Logiant/AgileRoboticControls/Documentation/Microprocessor Proposal/Tiva Series.jpg

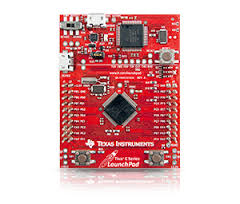
Documentation/Microprocessor Proposal/Tiva Series.jpg
