Logiant/AgileRoboticControls/Documentation/Design Show Poster/basic pneumatic circuit.png

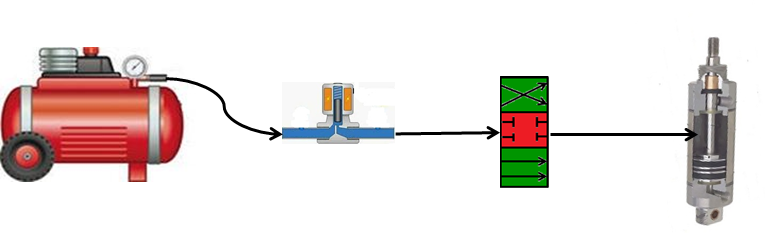
Documentation/Design Show Poster/basic pneumatic circuit.png
