Logiant/AgileRoboticControls/README.md

AgileRoboticControls
====================

Capstone Research Project
