Logiant/AgileRoboticControls/Poster/Poster Images.docx

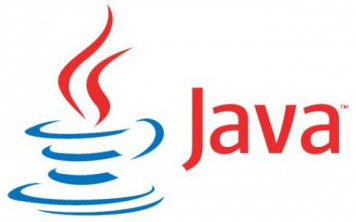
[picture p3: figure]

XBee

XBee

Arduino Mega 2560
