Logiant/AgileRoboticControls/Documentation/Presentation/Design Powerpoint.pptx

## Team Agile Robotic Control

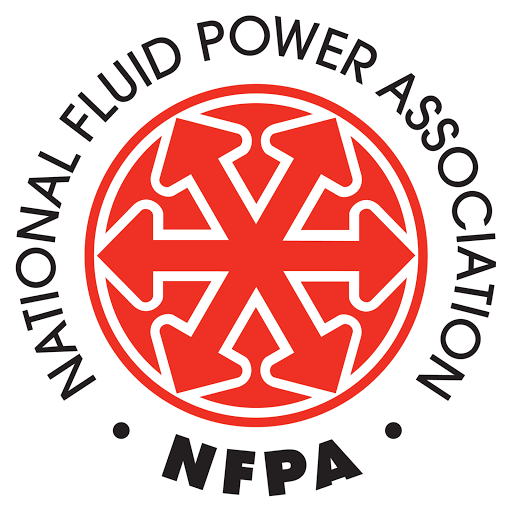
[picture p79: figure]
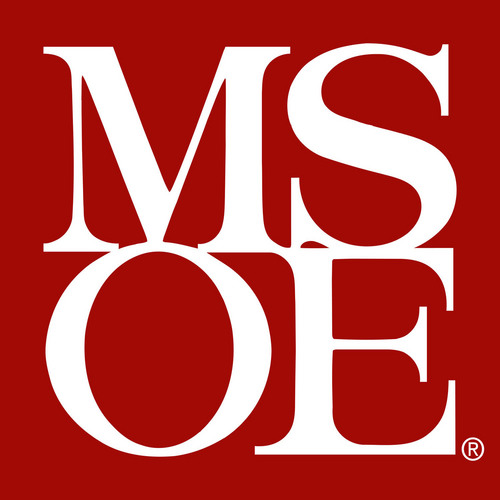
[picture p80: figure]

Logan Beaver - ME
Justin Campbell - ME
Tyler Paddock – CE/EE
Ronald Shipman – ME
Dr. Luis Rodriguez – advisor

## Project Overview

- Develop initial robotics platform
- Public Outreach
  - Increase interest in STEM fields
  - Engineering deficit
  - Fluid Power
- Educational robotics platform
  - Fluid Power
  - Control Systems
  - Robotics

## Major Design Decisions

- Quadruped Locomotion
  - Agile motion
  - Stable
  - Rugged Terrain
  - Two Links per Leg
- Pneumatic Power
  - High energy density
  - Clean and lightweight

## Major Constraints and Objectives

- Does not weight over 35 Kg
- Operational speed up to 0.5 m/s
- Gait implementations for creep and walk
- Emergency stops easily accessible
- Battery life of at least 3 hours for pneumatic components
- Onboard batteries and control system
- Tethered air supply

## Power Source Options

| Advantages | Disadvantages
Hydraulic Power Source | -Highest achievable power density | -High maintenance -Heavy -Dirty
Electric Power Source | -Accurate positioning | -Lowest achievable power density -Noncompliant
Pneumatic Power Source | -Higher power density than electric power -Low Maintenance -Compliant action from fluid compression | -Compressible fluid causes inaccuracy in positioning

## Components

Pneumatic components include:
- Receiver Tank
- Air Compressor
- Double Acting Air Cylinders (w/ feedback)
- Solenoid Valve
- Directional Control Valves (4/2)
- Pressure Relief Valve
- Tubing


F =P_(cap) A_(cap) −P_(rod) A_(rod)

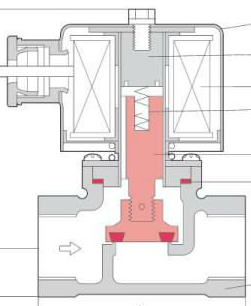
[picture p81: figure]
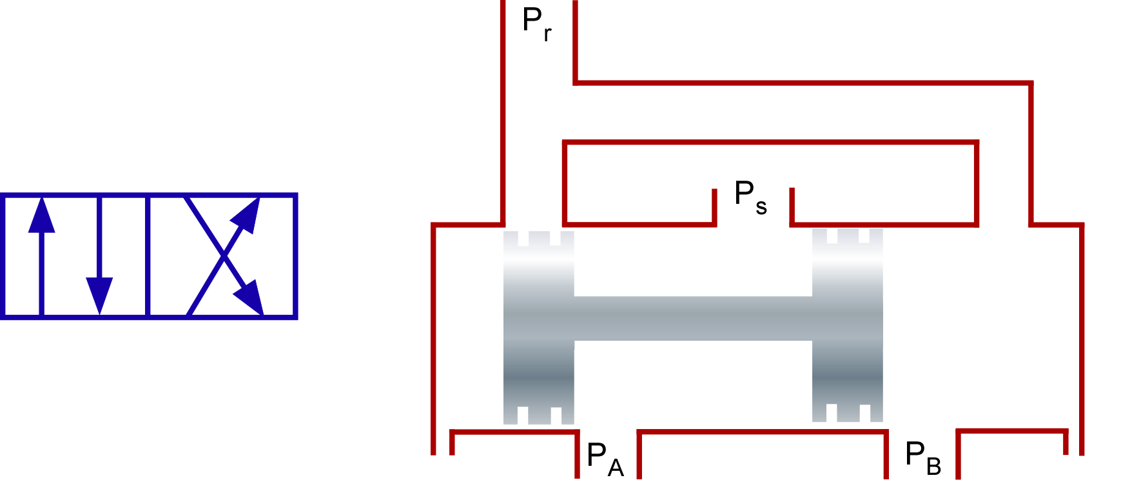
[picture p82: figure]

## Pneumatic Circuit for single cylinder


## Design Ideas


Arachnea


Hexabot

Boxxy

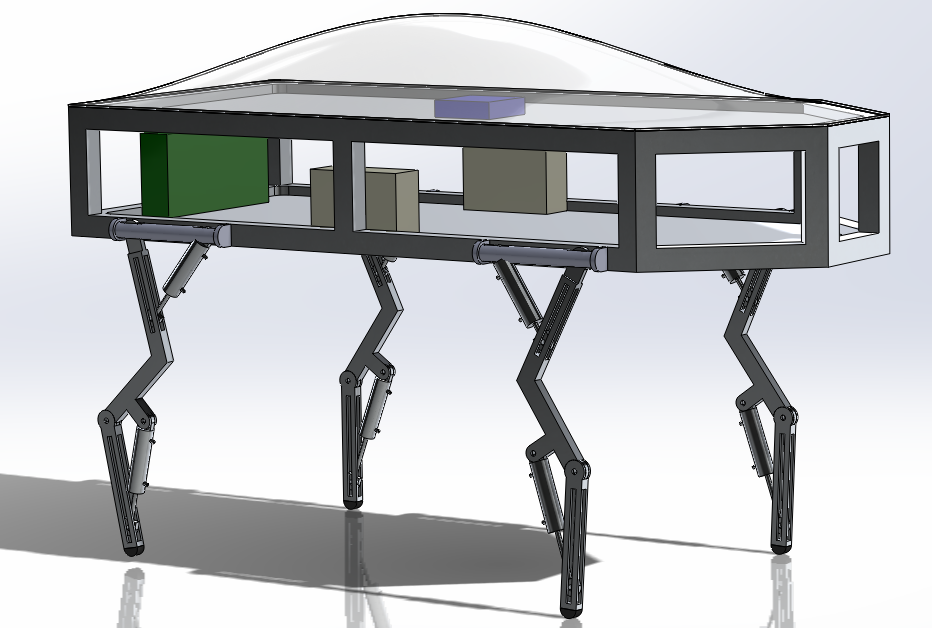
[picture p83: figure]

DogeBot

## Mechanical Design Matrix

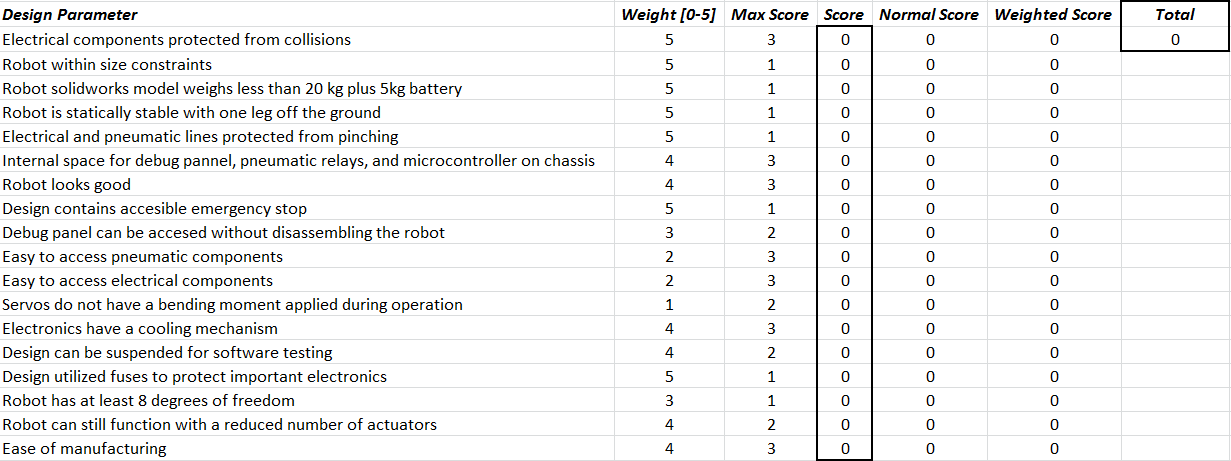
[picture p84: figure]

## Dogebot

- Pros
  - Legs cannot interfere with each other
  - Adequate space for components
  - Open sides for easy accessibility
- Cons
  - Legs may be susceptible to bending
  - Near the limit on all dimensions and weight

## Design Updates

- Chassis
  - Extruded T-Slotted Aluminum Frame
  - Easy to assemble and attach components
  - Decreased dimensions to reduce weight
- Legs
  - Fixed piston attachment points
  - Attached to top of chassis to increase stability

## DogeBot 2.0

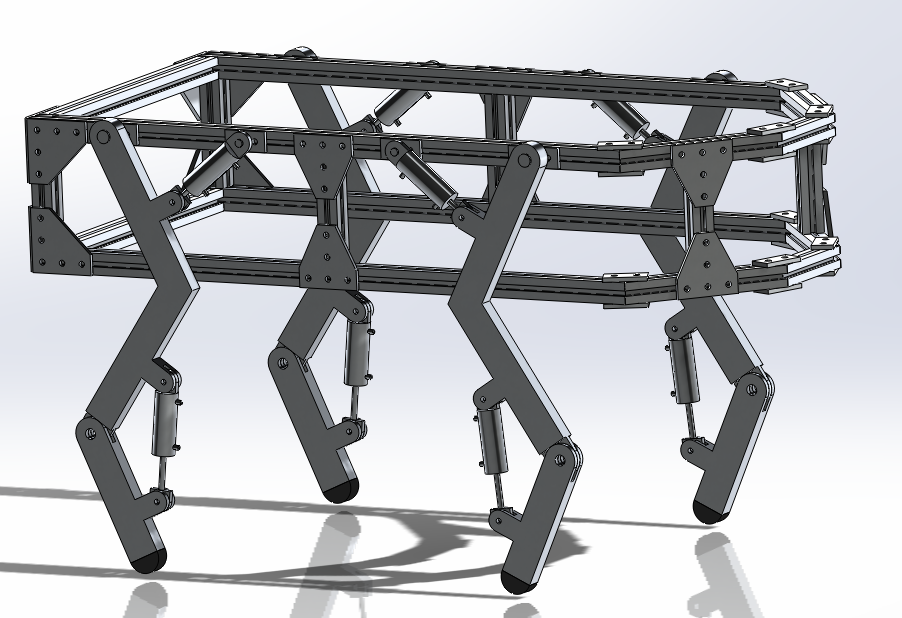
[picture p85: figure]

## Slide 13

Kinematic Model

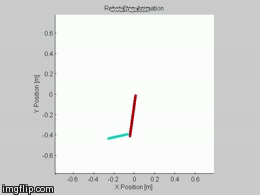
[picture p86: figure]

Homogenous Transformations
Determines cylinder stroke
Shank X Acceleration:
LH4∗cos(tb)∗tbdot^2 − LK4∗cos(th4)∗th4dot^2 + xddot + LH4∗tbddot∗sin(tb) − LK4∗th4ddot∗sin(th4) − S4∗tk4ddot∗sin(tk4)

## Slide 14

Dynamic Model

Non-inertial reference frame
Lagrangian Mechanics
Arbitrary global reference frame
Determines mechanical properties of components
27 Equations with state vector q

q=[, X, Y, θ_(Body) , θ_(Hip 1) , θ_(Knee 1) , θ_(Hip 2) , θ_(Knee 2) , θ_(Hip 3) , θ_(Knee 3) , , θ_(Hip 4) , θ_(Knee 4) ]

## Control architecture

- Control algorithms: Software implemented PIDs
- Software: MATLAB/Simulink model of the control is developed and
- Hardware: Arduino Mega 2560
- Control Feedback: Position feedback from the pneumatic cylinders

## PID Model

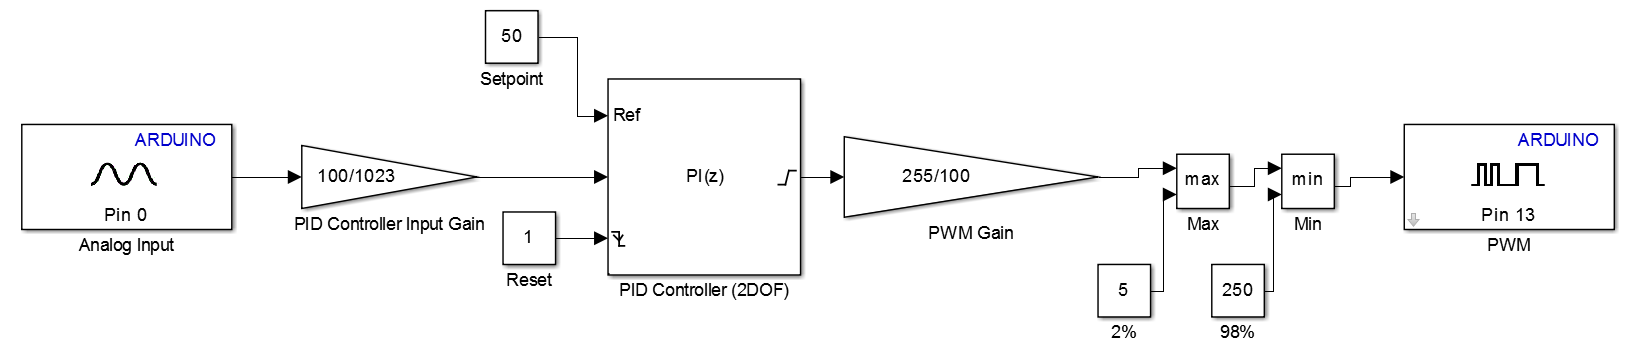
[picture p87: figure]

## Signal Conditioning

- PWM signals from the microcontroller are filtered into analog signals to drive the pneumatic actuators
- The analog signals will be scaled by amplifiers to the correct voltage required by the pneumatic actuator
- Opto-isolators used to protect microcontroller by separating power circuits

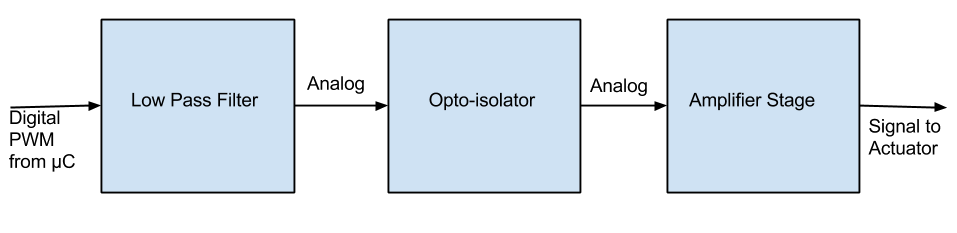
[picture p88: figure]

## User Interface and Remote COntrol

- Xbee short range radio devices using IEEE standard 802.15.4
- Range: 100 meters
- 250Kbps maximum
- 2.4GHz operating frequency

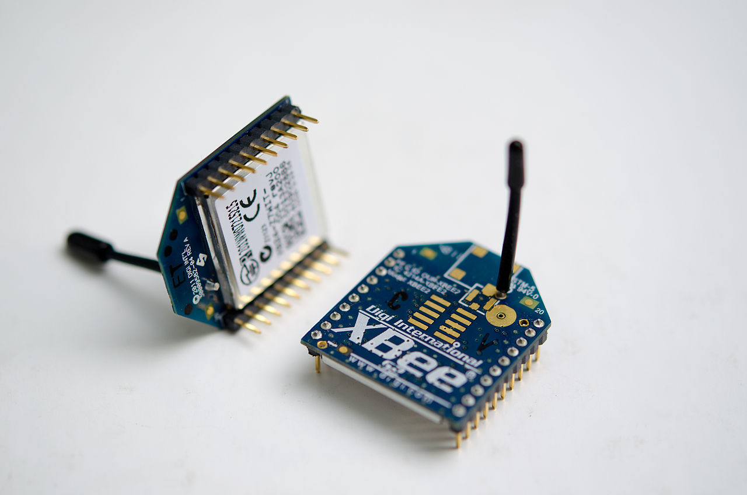
[picture p89: figure]
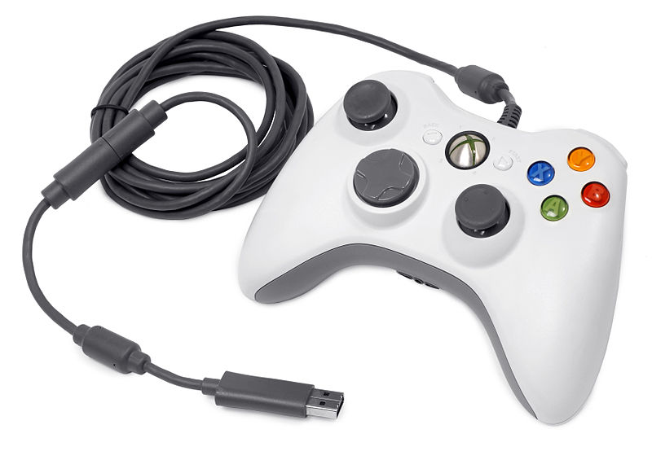
[picture p90: figure]

## What’s Next?

- Decide on final pneumatic cylinder based on simulations
- Operational Motherboard Assembled
- Gather air cylinder response data
- Experiment with single pneumatic leg control
- Build and assemble robot subsystems
- Observe final system behavior
- Test gait implementations

## Questions?
