Logiant/AgileRoboticControls/Meeting Summaries/Week 3/9-26-14.docx

Bimba Pneumatics – With feedback sensor

Numatics – may donate some pneumatic parts to team

Justify constraints/objectives with calculations and analysis – Feasibility Study

Feasability

Design Alternatives

Eventually, select design

Forward and inverse kinematics handout – Use atan2(y,x)
