Logiant/AgileRoboticControls/Documentation/Memos/Fall/Memo - Week 4.docx

Memo

To: Dr. Luis Rodriguez

From: A.R.C. - Logan Beaver, Justin Campbell, Tyler Paddock, and Ron Shipman

Date: October 3, 2014

Re: A.R.C.’s Update for the Week 4

Problem Statement:

Milwaukee School of Engineering’s mechanical engineering students take controls classes in their senior year. Having an automated control system would be a beneficial tool to explore controls theory. An application of Automatic Control Systems is the use and development of robotics. Development of a robot with pneumatic locomotion for the Milwaukee School of Engineering’s controls classes would give students a first-hand experience with complex control systems.

Last Week’s Goals:

- Request funds from Plexus, JoyGlobal, Johnson Controls, and MSOE
- Deliver initial constraints to Dr. Mahinfalah at next senior design meeting
- Design an initial pneumatic circuit for a 4 legged robot
- Create a rough matlab model for a 2 link pneumatic leg
- Interface an xBox controller with matlab
- Audit robot parts list

Accomplishments:

- Have initial interview with Plexus set up

Goals for this Week:

- Research the feasibility of the objectives/constraints
- Create an initial kinematic model of a leg
- Update Gantt chart with remaining deadlines
- Prepare initial presentation for Plexus
- Review the handouts provided by Dr. Rodriguez
- Compile report background information from research

Project Difficulties:

- Project is currently self-funded

Activities:

Date | Person | Task | Time [Hours] | Total Man-Hours
10/2/14 | Team | Team Meeting | 1 | 23
10/3/14 | Team | Team Meeting | 1
9/25/14 – 10/3/14 | Team | Various Research | 3
9/27/14 | Tyler | Xbox/MATLAB Interface | 3

Logan Beaver (715) 417 1001 beaverl@msoe.edu Justin Campbell (815) 347 2336 campbellj@msoe.edu Tyler Paddock (847) 239 3325 paddock@msoe.edu Ron Shipman (414) 520 5451 shipmanr@msoe.edu
