Logiant/AgileRoboticControls/Research/Constraints Research/Articles of Interest.docx

Articles of Interest:

Cheetah-Cub Quadruped Robot Learns to Walk, Trot Using Gait Patterns from Real Animal

http://spectrum.ieee.org/automaton/robotics/robotics-software/epfl-iit-cheetah-cub-quadruped-kmps

Quadruped Robot Pneupard Takes Its First Steps

http://spectrum.ieee.org/automaton/robotics/robotics-hardware/japanese-quadruped-robot-pneupard

THE USE OF PNEUMATIC ACTUATION TO ADDRESS SHORTCOMINGS

CONCERNING NORMALIZED OUTPUT POWER IN STATE

OF THE ART MOBILE ROBOTICS

http://etd.library.vanderbilt.edu/available/etd-07262010-121214/unrestricted/keith_wait_dissertation_FINAL.pdf
