Logiant/AgileRoboticControls/Design/Weight List.xlsx

Component | Weight [kg]
Microcontroller | 0.035
Battery | 2.27
other electronics (estimation) | 0.5
Chassis | 2.243
Position Feedback Cylinder 1-1/16" | 0.2
Position Feedback Cylinder 2" | 0.918
Solenoid Valve | 0.0369
4/2 DCV | 0.13
 |  | Max Weight
Robot Weight | 6.3329 | 35
Load (.25 times robot weight) | 7.916125
Total Weight Including Load | 14.249025
