Logiant/AgileRoboticControls/Documentation/Design Matrix.xlsx

Sheet: Overall Score
Arachne | 88.33
Hexapod | 85.48
Shibe | 96.19 | <-- WINRAR!
Boxxy | 91.43

Sheet: Arachne
Arachne | 70
Design Parameter | Weight [0-5] | Max Score | Score | Normal Score | Weighted Score | Total | Design Pros
Electrical components protected from collisions | 5 | 3 | 3 | 1 | 5 | 88.33333333
Robot within size constraints | 5 | 1 | 1 | 1 | 5
Robot solidworks model weighs less than 20 kg plus 5kg battery | 5 | 1 | 1 | 1 | 5
Robot is statically stable with one leg off the ground | 5 | 1 | 1 | 1 | 5
Electrical and pneumatic lines protected from pinching | 5 | 1 | 1 | 1 | 5
Internal space for debug pannel, pneumatic relays, and microcontroller on chassis | 4 | 3 | 3 | 1 | 4
Robot looks good | 4 | 3 | 2 | 0.6666666667 | 2.666666667
Design contains accesible emergency stop | 5 | 1 | 1 | 1 | 5
Debug panel can be accesed without disassembling the robot | 3 | 2 | 1 | 0.5 | 1.5
Easy to access pneumatic components | 2 | 3 | 1 | 0.3333333333 | 0.6666666667 |  | Design Cons
Easy to access electrical components | 2 | 3 | 2 | 0.6666666667 | 1.333333333
Servos do not have a bending moment applied during operation | 1 | 2 | 2 | 1 | 1
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
