Logiant/AgileRoboticControls/Documentation/Microprocessor Proposal/Microcontroller Decision Matrix.xlsx

Microcontroller Choice Matrix | Weight | 0.1 | 0.25 | 0.15 | 0.2 | 0.25 | 0.05 | 1
 | Field | Cost | Analog Inputs | GPIO | Speed | MATLAB compatibility | Programming Ease | Evaluation
 | Arduino | 2 | 5 | 5 | 2 | 4 | 4 | 3.8
 | Raspberry Pi | 3 | 0 | 1 | 4 | 5 | 2 | 2.6
 | Tiva | 4 | 3 | 5 | 3 | 4 | 4 | 3.7
 | Beagleboard | 1 | 0 | 5 | 5 | 5 | 2 | 3.2
