Logiant/AgileRoboticControls/System Modelling/Mechanical/Pneumatics/PressureBoreCalc.xlsx

Sheet: Main
 |  | Step Time [s] | 1
 | Desired Specifications |  |  | Air Compressor Requirements
 | Hip Torque [N-m] | Knee Torque [N-m] |  | Hip Pressure [PSI] | Knee Pressure [PSI] | Hip Flow Rate [SCFM] | Knee Flow Rate [SCFM] | FLOW [SCFM] | MAX PRESSURE [PSI]
Max - Hip | 383 | 1.3 |  | 56.78564604 | 0.3454863434 | 3.083343162 | 1.297894053 | 4.381237216 | 56.78564604
Max- Knee | 42 | 56 |  | 6.227146563 | 14.88248864 | 0.9026367927 | 2.551923893 | 3.454560686 | 14.88248864
Average | 11.3 | 19.7 |  | 1.675398956 | 5.235446897 | 0.7063092691 | 1.719724932 | 2.426034201 | 5.235446897
 | Geometric Constants |  |  | Air Supply Specs
 | Hip Bore [in] | Knee Bore [in] |  | Flow Produced [SCFM] | Air Storage [Gallons] | Storage Pressure [PSIG]
 | 2 | 2 |  | 1.5 | 8 | 120
 | Hip Moment Arm [in] | Knee Moment Arm [in]
 | 19 | 10.6
 | Hip Stroke [in] | Knee Stroke [in] |  |  | Lifetime (if difference > 0)
 | 3 | 6 |  |  | Flow Difference [SCFM] | Pressurized Flow Difference [CFM] | Air Supply Life [min]
 | Hip Rod Diameter [in] | Knee Rod Diameter [in] |  |  | 0.9260342009 | 0.1010594117 | 10.60762162
 | 0.5 | 0.5
Source:
http://cross-automation.com/blog/pneumatic-cylinder-air-flow-requirements

Sheet: Pressure Calculations
Max Hip Acc |  |  |  |  |  |  | Max Knee Acc
Hip |  |  |  |  |  |  | Hip
Torque [N-m] | Torque [in-lb] | Length [in] | Force [lb] | Bore D [in] | Area [in2] | Pressure | Torque [N-m] | Torque [in-lb] | Length [in] | Force [lb] | Bore D [in] | Area [in2] | Pressure
383 | 3389.55 | 19 | 178.3973684 | 2 | 3.141592654 | 56.78564604 | 42 | 371.7 | 19 | 19.56315789 | 2 | 3.141592654 | 6.227146563
Knee |  |  |  |  |  |  | Knee
Torque [N-m] | Torque [in-lb] | Length [in] | Force [lb] | Bore D [in] | Area [in2] | Pressure | Torque [N-m] | Torque [in-lb] | Length [in] | Force [lb] | Bore D [in] | Area [in2] | Pressure
1.3 | 11.505 | 10.6 | 1.085377358 | 2 | 3.141592654 | 0.3454863434 | 56 | 495.6 | 10.6 | 46.75471698 | 2 | 3.141592654 | 14.88248864
 |  |  |  |  |  |  | Avg Knee Acc
 |  |  |  |  |  |  | Hip
 |  |  |  |  |  |  | Torque [N-m] | Torque [in-lb] | Length [in] | Force [lb] | Bore D [in] | Area [in2] | Pressure
 |  |  |  |  |  |  | 11.3 | 100.005 | 19 | 5.263421053 | 2 | 3.141592654 | 1.675398956
 |  |  |  |  |  |  | Knee
 |  |  |  |  |  |  | Torque [N-m] | Torque [in-lb] | Length [in] | Force [lb] | Bore D [in] | Area [in2] | Pressure
 |  |  |  |  |  |  | 19.7 | 174.345 | 10.6 | 16.44764151 | 2 | 3.141592654 | 5.235446897

Sheet: Volumetric Flow Calculations
Max Hip Acc
Hip |  |  |  |  |  |  |  |  | vol | act vol
Stroke [in] | Bore Diameter [in] | Rod Diameter [in] | Cycles/Minute | Bore Area [in2] | Rod Area [in2] | Flow Rate [ft3/min] | Pressure [PSIG] | Flow Rate [SCFM] | 0.6544984695 | 0.6340453923
3 | 2 | 0.5 | 60 | 3.141592654 | 0.1963495408 | 0.6340453923 | 56.78564604 | 3.083343162
Knee
Stroke [in] | Bore Diameter [in] | Rod Diameter [in] | Cycles/Minute | Bore Area [in2] | Rod Area [in2] | Flow Rate [ft3/min] | Pressure [PSIG] | Flow Rate [SCFM]
6 | 2 | 0.5 | 60 | 3.141592654 | 0.1963495408 | 1.268090785 | 0.3454863434 | 1.297894053
Max Knee Acc
Hip
Stroke [in] | Bore Diameter [in] | Rod Diameter [in] | Cycles/Minute | Bore Area [in2] | Rod Area [in2] | Flow Rate [ft3/min] | Pressure [PSIG] | Flow Rate [SCFM]
3 | 2 | 0.5 | 60 | 3.141592654 | 0.1963495408 | 0.6340453923 | 6.227146563 | 0.9026367927
Knee
Stroke [in] | Bore Diameter [in] | Rod Diameter [in] | Cycles/Minute | Bore Area [in2] | Rod Area [in2] | Flow Rate [ft3/min] | Pressure [PSIG] | Flow Rate [SCFM]
6 | 2 | 0.5 | 60 | 3.141592654 | 0.1963495408 | 1.268090785 | 14.88248864 | 2.551923893
Average
Hip
Stroke [in] | Bore Diameter [in] | Rod Diameter [in] | Cycles/Minute | Bore Area [in2] | Rod Area [in2] | Flow Rate [ft3/min] | Pressure [PSIG] | Flow Rate [SCFM]
3 | 2 | 0.5 | 60 | 3.141592654 | 0.1963495408 | 0.6340453923 | 1.675398956 | 0.7063092691
Knee
Stroke [in] | Bore Diameter [in] | Rod Diameter [in] | Cycles/Minute | Bore Area [in2] | Rod Area [in2] | Flow Rate [ft3/min] | Pressure [PSIG] | Flow Rate [SCFM]
6 | 2 | 0.5 | 60 | 3.141592654 | 0.1963495408 | 1.268090785 | 5.235446897 | 1.719724932
