Logiant/AgileRoboticControls/Documentation/Environmental Impact Report/6400035E_MSDS.pdf

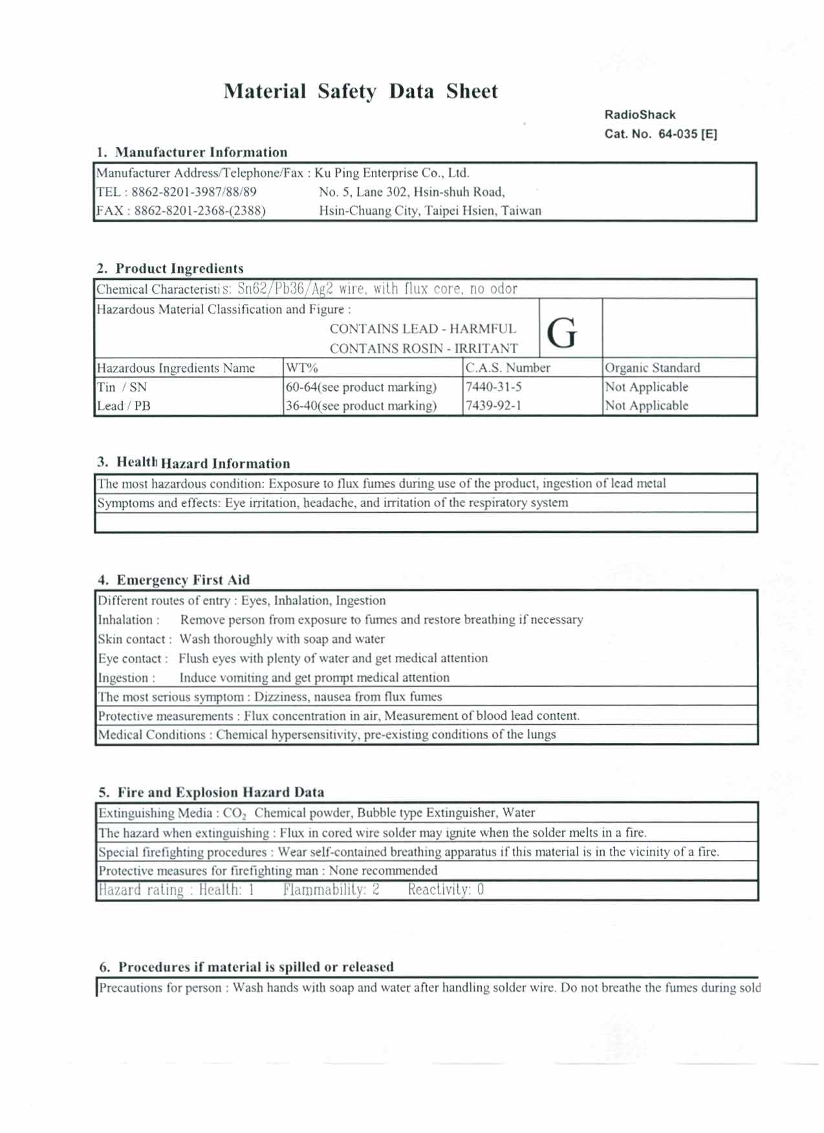
[picture p144: page 1]
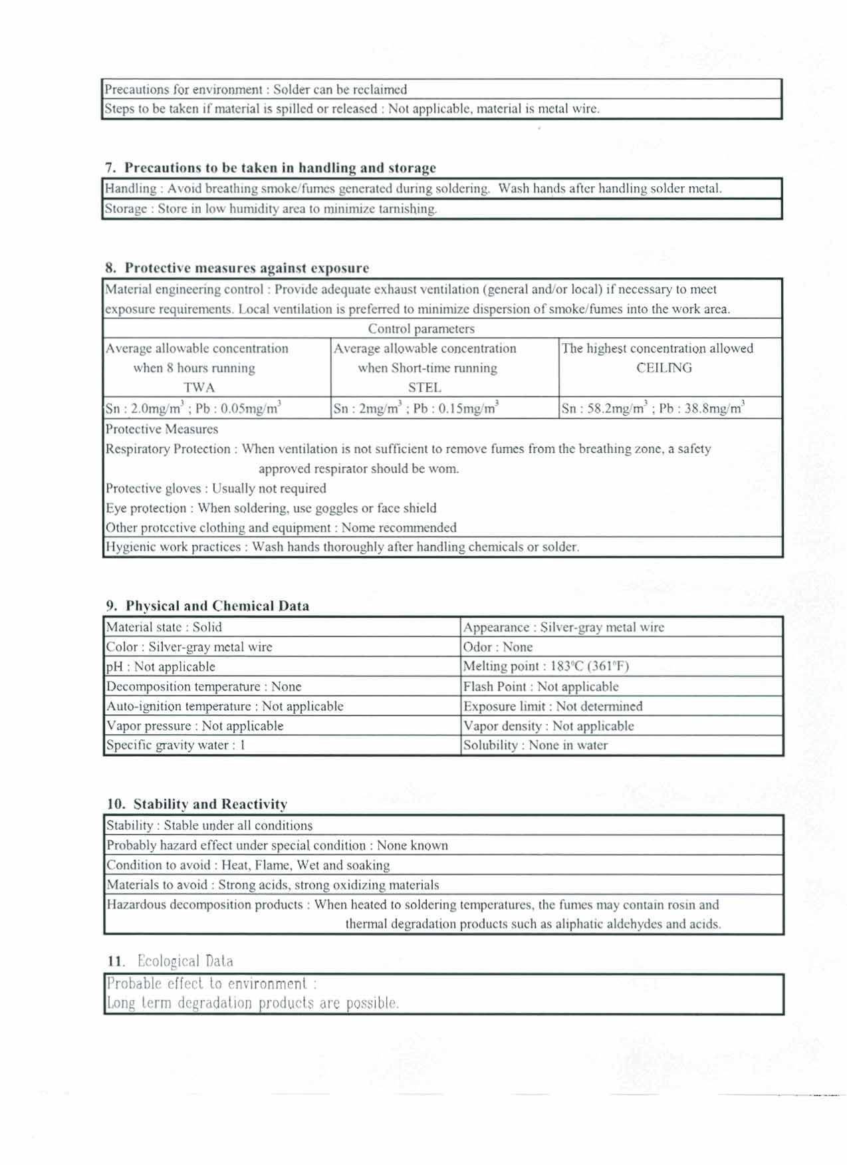
[picture p145: page 2]
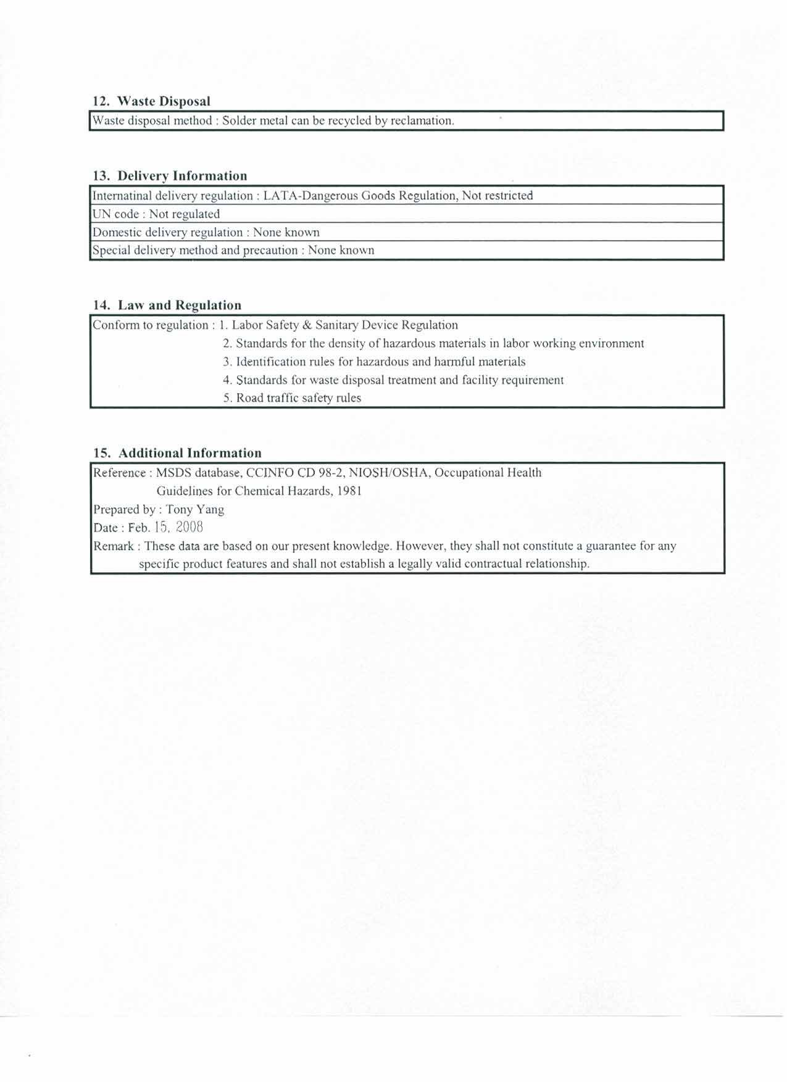
[picture p146: page 3]
