Logiant/AgileRoboticControls/Documentation/Design Proposal Report/Electrical Drawings.pdf

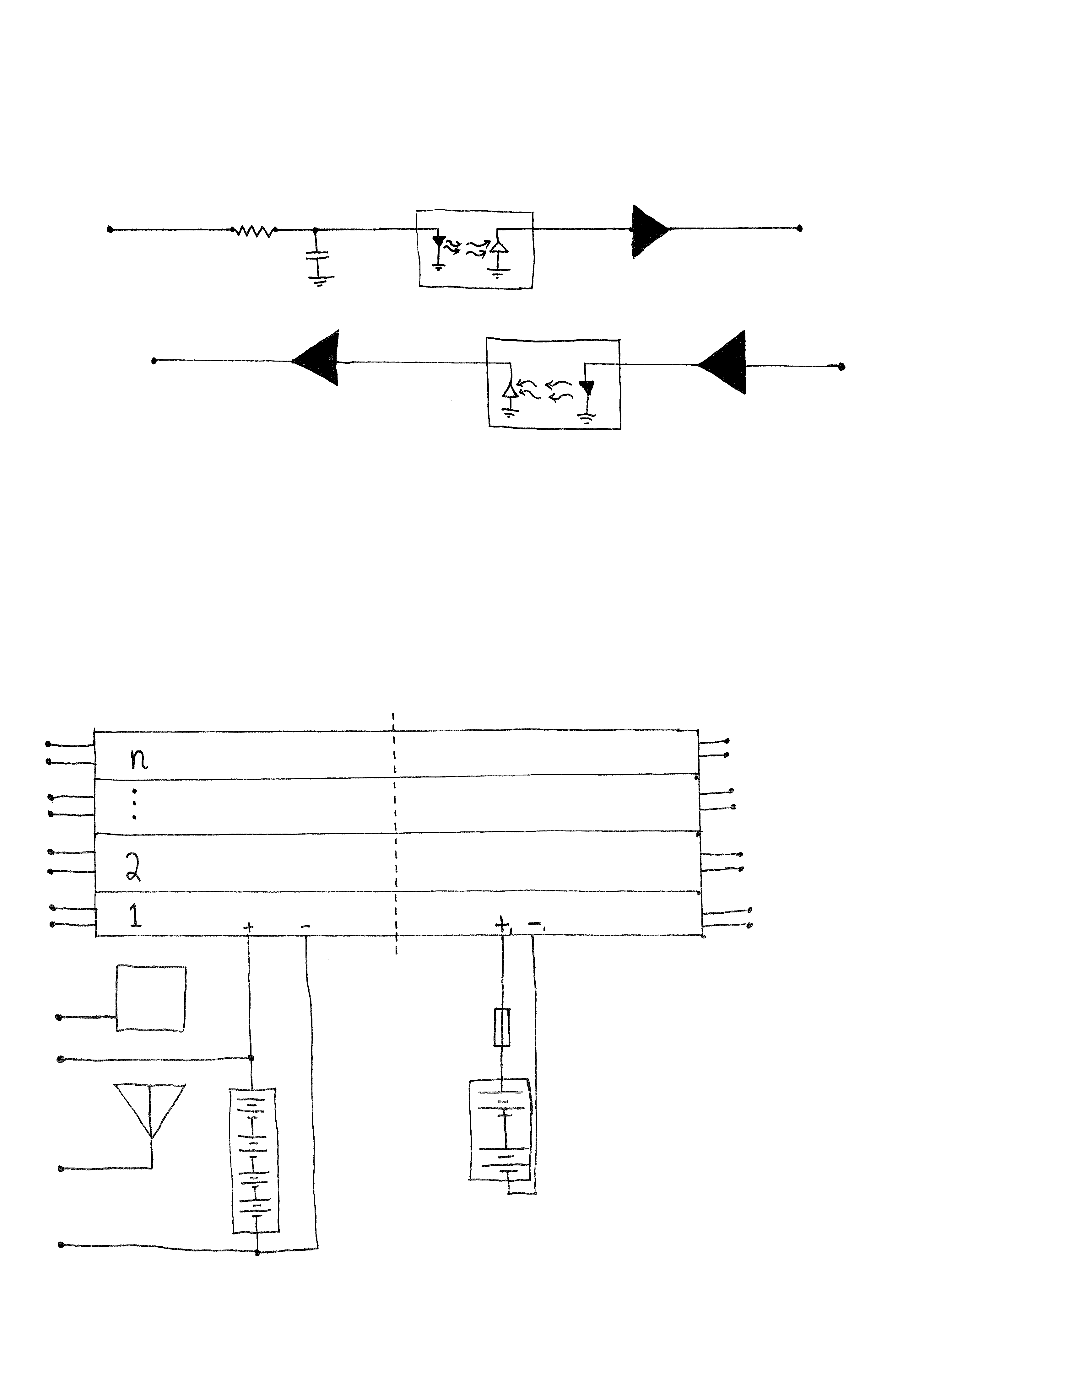
[picture p147: page 1]
