Logiant/AgileRoboticControls/System Modelling/Mechanical/Finite Elements/Force Calculations.xlsx

Sheet: Step
 | TI1 = | Value |  | Hip Arm | Hip Force | Theta1 | Theta2 | Index 1 | Torques |  | Value | Step | Drag | Impulse
TH1 | 383.2008 | 383.2008 |  | 0.18 | 2128.893333 | -76.5 | -76.5 |  |  |  | TH1 | 383.2008 | 67.082 | 0
TH2 | 2.9008 | 2.9008 |  |  |  |  |  |  |  |  | TH2 | 2.9008 | -3.1367 | 0
TH3 | -0.7823 | -0.7823 |  |  |  |  |  |  |  |  | TH3 | -0.7823 | -1.3573 | 0
TH4 | 2.9008 | 2.9008 |  | Knee Arm | Knee Force |  |  |  |  |  | TH4 | 2.9008 | -3.1367 | 0
TK1 | 1.3135 | 1.3135 |  | 0.17 | 7.726470588 |  |  |  |  |  | TK1 | 1.3135 | 99.3253 | 0
TK2 | 17.5289 | 17.5289 |  |  |  |  |  |  |  |  | TK2 | 17.5289 | 6.8914 | 0
TK3 | -13.2918 | -13.2918 |  |  |  |  |  |  |  |  | TK3 | -13.2918 | -9.8418 | 0
TK4 | 17.5289 | 17.5289 |  |  |  | Total Weight [N] | 138 |  |  |  | TK4 | 17.5289 | 6.8914 | 0
 |  |  |  |  |  | Foot Friction Factor | 0.5 | Theta1 | Theta2 |  | FK1x | 557.6 | 33.7092 | 12.3869
 |  |  |  |  |  |  |  | -70.1 | -85.1 |  | FH1x | 911 | 91.9408 | 0
 |  |  |  |  |  |  |  |  |  |  | FK2x | 0 | 17.25 | 0
 | TI2 = | value |  | Hip Arm | Hip Force | FF1x | 0 |  |  |  | FH2x | 0 | 17.25 | 0
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
