Logiant/AgileRoboticControls/System Modelling/Mechanical/Agile Controls Simulation/ParameterConfig.xlsx

Total Weight [N] | 138
Body Length [m] | 0.75
Body CG [m from front] | 0.375
Thigh Distance [cm] | 53
Thigh Inertia [m4] | 0.00067929
Thigh CG (from hip) [m] | 0.2
Thigh Mass [kg] | 0.43
Shank Distance [cm] | 27
Shank Inertia [m4] | 0.00051042
Shank CG (from knee) [m] | 0.19
Shank Mass [kg] | 0.37
Foot Friction Factor | 0.5
