Logiant/AgileRoboticControls/Documentation/Design Proposal Report/ActuatorSensorPath.PNG

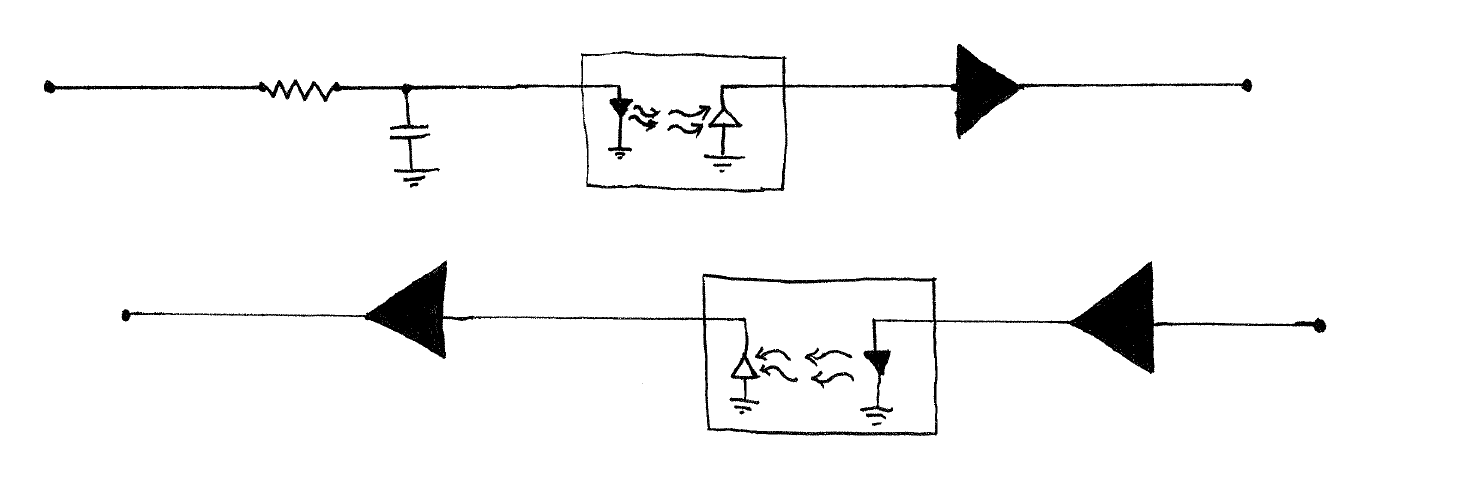
Documentation/Design Proposal Report/ActuatorSensorPath.PNG
