Logiant/AgileRoboticControls/Documentation/Design Show Poster/Formula Hybrid Poster.JPG

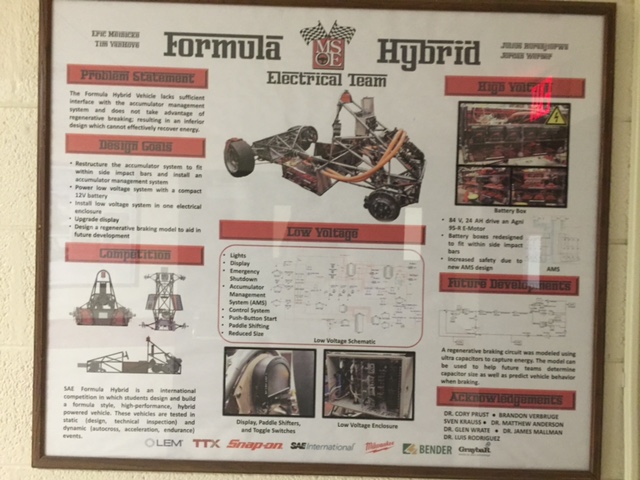
Documentation/Design Show Poster/Formula Hybrid Poster.JPG
