Logiant/AgileRoboticControls/Documentation/Design Show Poster/IGVC Poster.JPG

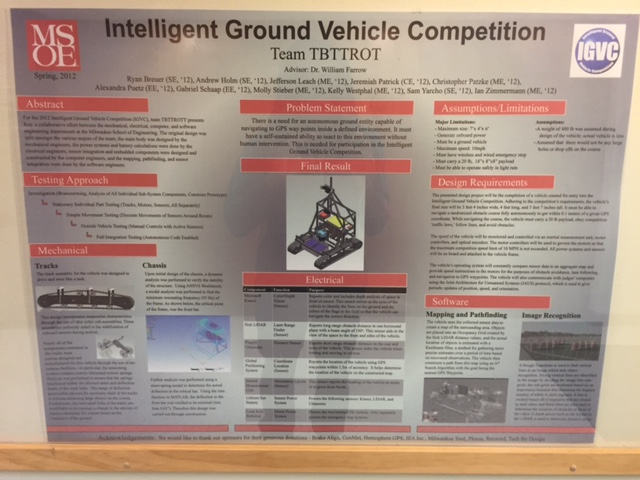
Documentation/Design Show Poster/IGVC Poster.JPG
