Logiant/AgileRoboticControls/Documentation/Design Show Poster/Mini Baja Poster.JPG

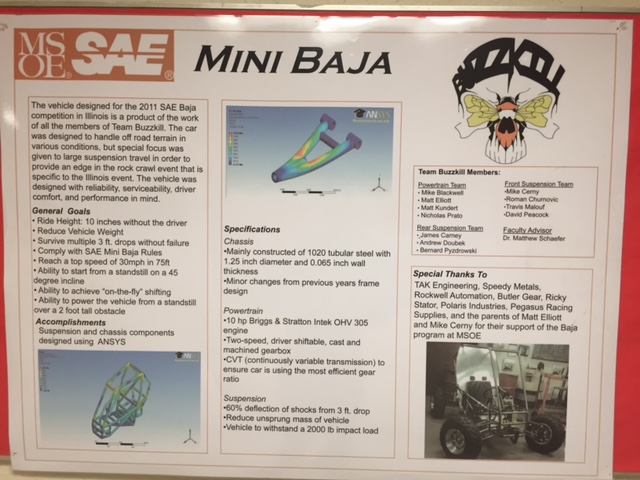
Documentation/Design Show Poster/Mini Baja Poster.JPG
