Logiant/AgileRoboticControls/Research/Pneumatics, Hydraulics, and Electrics/Difference Between Pneumatics and Hydraulics Systems_files/49e29f63e0661b72ee2a0c7a9000ce4fb3b3f61a_large.jpg

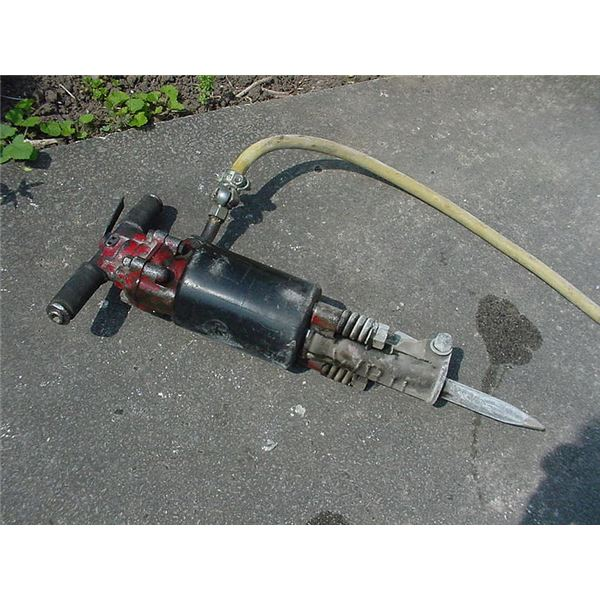
Research/Pneumatics, Hydraulics, and Electrics/Difference Between Pneumatics and Hydraulics Systems_files/49e29f63e0661b72ee2a0c7a9000ce4fb3b3f61a_large.jpg
