Logiant/AgileRoboticControls/Research/Pneumatics, Hydraulics, and Electrics/Electric Actuator or Pneumatic Actuator _files/DownloadLatestLeadScrewCatalog.gif

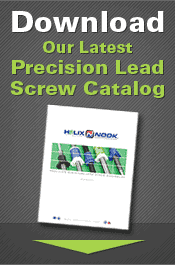
Research/Pneumatics, Hydraulics, and Electrics/Electric Actuator or Pneumatic Actuator _files/DownloadLatestLeadScrewCatalog.gif
