Logiant/AgileRoboticControls/Research/Pneumatics, Hydraulics, and Electrics/Electric Actuator or Pneumatic Actuator _files/Electric-Actuator.gif

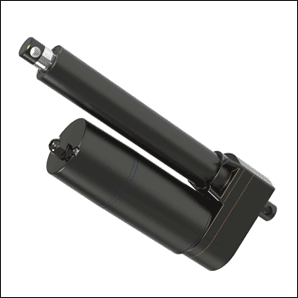
Research/Pneumatics, Hydraulics, and Electrics/Electric Actuator or Pneumatic Actuator _files/Electric-Actuator.gif
