Logiant/AgileRoboticControls/Research/Pneumatics, Hydraulics, and Electrics/Electric Actuator or Pneumatic Actuator _files/pneumatic_actuator_helix_linear_technologies.png

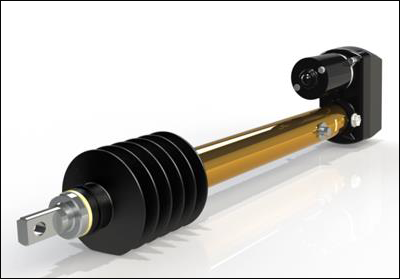
Research/Pneumatics, Hydraulics, and Electrics/Electric Actuator or Pneumatic Actuator _files/pneumatic_actuator_helix_linear_technologies.png
