Logiant/AgileRoboticControls/System Modelling/Electrical/Smaller Battery Level Indicator/New Circuit/Battery Level Indicator.jpg

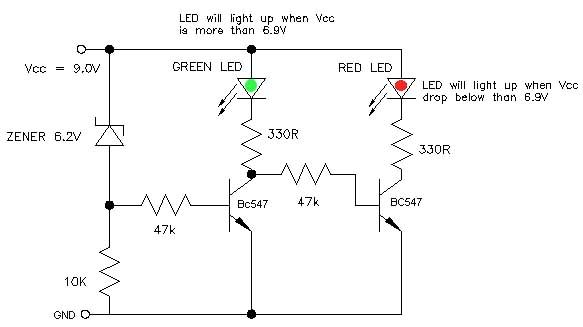
System Modelling/Electrical/Smaller Battery Level Indicator/New Circuit/Battery Level Indicator.jpg
