Logiant/AgileRoboticControls/Design/Bill of Materials/Bill Of Materials - Updated.xlsx

Name | Description | Quantity | Part Number | Cost | Ordered
Arduino Mega 2560 | Microcontroller | 1 |  | $45.00 | Y
Arduino Xbee Shield | Xbee Shield for expanding the IO ports on Arduino Mega | 1 |  | $6.00 | Y
9 volt battery connector | 9 volt battery connector | 1 | BS61-ND | $0.59 | Y
Two prong Switch | Two prong Switch | 1 | CKN 9868-ND | $6.63 | Y
Battery Holder | Battery Holder | 1 | 71K-ND | $0.42 | Y
USB A RCPT to B PLUG | USB A receptacle to USB B plug | 1 | 839-1104-ND | $4.14 | Y
USB A RCPT to A PLUG | USB A receptacle to USB A plug | 1 | U024-001-PM-ND | $8.07 | N
Xbee | Xbee series 1 radio antenna | 2 |  | $25.00 | Y
E-STOP | Emergency Stop Switch | 1 | Z1504-ND | $27.30 | Y
LED | Green | 3 | 350-1557-ND | $0.95 | Y
LED | Yellow | 3 | 350-1558-ND | $0.95 | Y
LED | Red | 2 | 350-1555-ND | $0.95 | Y
Banana Connector | Banana Plug Connector - Black Female | 2 | J152-ND | $0.70 | Y
Banana Connector | Banana Plug Connector - Red Female | 8 | J151-ND | $0.70 | Y
Banana Connector | Banana Plug Connector - White Female | 8 | J150-ND | $0.70 | Y
Nitra Nylon Tubing | Flexible Tubing | 200 ft | n532BLU100 | $21.00
20 mm Extruded Aluminum Frame - 8 ft | McMaster - Carr | 3 | 5537T101 | $64.74
20 mm Extruded Aluminum Frame - 6 ft | McMaster - Carr | 1 | 5537T101 | $17.19
Single, 5-Hole Tee Plate | McMaster - Carr | 8 | 5537T213 | $60.16
Single, 5-Hole 90° Plate | McMaster - Carr | 8 | 5537T206 | $51.04
Single, 2-Hole 90° Bracket | McMaster - Carr | 8 | 5537T181 | $31.04
Single, 2-Hole Plate | McMaster - Carr | 16 | 5537T167 | $72.00
Fasteners (4 pack) | McMaster - Carr | 34 | 5537T154 | $71.40
1"x1.5"x6' 6061 Aluminum Bar | McMaster - Carr | 2 | 8975K52 | $136.32
2" Bore, 4" Stroke Position Feedback Cylinder | Bimba air cylinder (universal mount) | 4 | PFC-314-X | $2651.80
2" Bore, 3" Stroke Position Feedback Cylinder | Bimba air cylinder (universal mount) | 4 | PFC-313-X | $2562.40
Mark 3 (5/3) Directional Control Valve | Numatics/Emerson | 8 | 03-1-SS5-00-E-0-000-61 | $1734.00
Brass Solenoid Valve | Grainger | 1 | 821G003 | -
1/8" Solenoid Valve | Normally closed pneumatic electrically controlled, 0.23 Cv | 1 | 2ACK-1/8-D | $16.80
10 gal. 2.5 HP Air Compressor | 5.3 CFM @ 90 ps - 6.2 CFM @ 40 psi (CentralPneumatic) | 1 | 67708 | $142.99
0.056 uF cap |  | 8 | 478-3145-1-ND | $3.52
0.047 uF cap |  | 8 | BC2686CT-ND | $2.96
0.068 uF cap |  | 8 | 399-4381-ND | $3.20
0.022uF cap |  | 8 | BC2677CT-ND | $2.56
0.018uF cap |  | 8 | 490-8989-1-ND | $5.28
0.22 uF cap |  | 8 | 399-4466-1-ND | $3.52
0.012 uF cap |  | 8 | 399-9799-ND | $2.64
Debug panel hosuing |  | 1 | SRW091-WG-ND | $16.19
6.2 Zener Diode |  | 1 | 1N4735A-TPCT-ND | 0.25
10K resistor |  | 1 | CF14JT10K0CT-ND | $0.10
47K resistor |  | 2 | CF14JT47K0CT-ND | $0.20
330 resistor |  | 2 | CF14JT330RCT-ND | $0.20
NPN transistor |  | 2 | BC547BTACT-ND | $0.40
