Logiant/AgileRoboticControls/Design/Bill of Materials/BOM.xlsx

Name | Description | Quantity | Part Number | Cost
Arduino Mega 2560 | Microcontroller | 1 |  | $45.00
Arduino Xbee Shield | Xbee Shield for expanding the IO ports on Arduino Mega | 1 |  | $6.00
9 volt battery connector | 9 volt battery connector | 1 | BS61-ND | $0.59
Two prong Switch | Two prong Switch | 1 | CKN 9868-ND | $6.63
Battery Holder | Battery Holder | 1 | 71K-ND | $0.42
USB A RCPT to B PLUG | USB A receptacle to USB B plug | 1 | 839-1104-ND | $4.14
USB A RCPT to A PLUG | USB A receptacle to USB A plug | 1 | U024-001-PM-ND | $8.07
Xbee | Xbee series 1 radio antenna | 2 |  | $25.00
E-STOP | Emergency Stop Switch | 1 | Z1504-ND | $27.30
LED | Green | 3 | 350-1557-ND | $0.95
LED | Yellow | 3 | 350-1558-ND | $0.95
LED | Red | 2 | 350-1555-ND | $0.95
Banana Connector | Banana Plug Connector - Black Female | 2 | J152-ND | $0.70
Banana Connector | Banana Plug Connector - Red Female | 8 | J151-ND | $0.70
Banana Connector | Banana Plug Connector - White Female | 8 | J150-ND | $0.70
Nitra Nylon Tubing | Flexible Tubing | 200 ft | n532BLU100 | $21.00
Bimba Air Cylinder | 2 IN Bore Diameter Dual Acting Cylinders with position feedback | 8 |  | $2831.20
