Logiant/AgileRoboticControls/Design/Bill of Materials/Bill of Materials.xlsx

Bill of Materials
Item # | Item Name | Quantity | Manufacturer | Reference #
1 | 20 mm Extruded Aluminum Frame - 8 ft | 3 | McMaster - Carr | 5537T101
2 | 20 mm Extruded Aluminum Frame - 6 ft | 1 | McMaster - Carr | 5537T101
3 | Single, 5-Hole Tee Plate | 8 | McMaster - Carr | 5537T213
4 | Single, 5-Hole 90° Plate | 8 | McMaster - Carr | 5537T206
5 | Single, 2-Hole Plate | 16 | McMaster - Carr | 5537T167
6 | Fasteners (4 pack) | 28 | McMaster - Carr | 5537T154
7 | 1"x1.5"x6' 6061 Aluminum Bar | 2 | McMaster - Carr | 8975K52
8 | 2" Bore, 4" Stroke Position Feedback Cylinder | 4 | Bimba | PFC-314-X
9 | 2" Bore, 3" Stroke Position Feedback Cylinder | 4 | Bimba | PFC-313-X
10 | Mark 3 (5/3) Directional Control Valve | 8 | Neumatics/Emerson | 03-1-SS5-00-E-0-000-61
11 | Brass Solenoid Valve | 1 | Grainger | 821G003
