Logiant/AgileRoboticControls/Design/Debug Panel/Debug Panel Components.xlsx

Part Number [Digikey] | Description | Cost | Quantity | Total Cost
B561-ND | 9 volt Battery Connector | 0.59 | 1 | 0.59
CKN 9868-ND | 2 Pronge Switch | 6.63 | 1 | 6.63
71K-ND | Battery Holder | 0.42 | 1 | 0.42
839-1104-ND | USB A RCPT to B Plug | 4.14 | 1 | 4.14
U024-001-PM-ND | USB A RCPT to A Plug | 8.07 | 1 | 8.07
J152-ND | Black Banana Female | 0.7 | 1 | 0.7
J151-ND | Red Banana Female | 0.7 | 8 | 5.6
J150-ND | White Banana Female | 0.7 | 8 | 5.6
350-1557-ND | Green LED | 0.95 | 2 | 1.9
350-1558-ND | Yellow LED | 0.95 | 3 | 2.85
350-1555-ND | Red LED | 0.95 | 2 | 1.9
Z1504-ND | E-Stop | 27.3 | 1 | 27.3
732-4358-ND | 32 pin Connector | 2.3 | 1 | 2.3
732-4335-ND | 32-pin Connector | 7.85 | 1 | 7.85
 |  |  | Sum | 75.85
