Logiant/AgileRoboticControls/Documentation/Compressor Options/Air Compressor Spread sheet.xlsx

 |  | Average (amps) | Capacity (Gallons) | Air Flow (cfm) | Pressure (psi) | Pressure (Kpa) | Cost | Link
Home Depot | 1-Gallon Portable Electronic Air Compressor | 2.9 | 1 |  | 100 | 689.475729 | $70.00 | http://www.menards.com/main/tools-hardware/power-tools/compressors-and-pneumatic-tools/compressors/tool-shop-6-gallon-air-compressor-with-13-pc-accessory-kit/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
 | 3 gal. Horizontal Air Compressor | 2 | 3 | 0.4 | 110 | 758.4233019 | $79.00 | http://www.homedepot.com/p/Campbell-Hausfeld-3-gal-Horizontal-Air-Compressor-FP209499AV/203002168
 | 6 gal. 150 psi Portable Air Compressor | 10 | 6 | 2.6 | 150 | 1034.213594 | $149.00 | http://www.homedepot.com/p/Porter-Cable-6-gal-150-psi-Portable-Air-Compressor-C2002/203162815
Menards | Tool Shop 6-Gallon Air compressor | 12 | 6 | 3.5 | 125 | 861.8446613 |  | http://www.menards.com/main/tools-hardware/power-tools/compressors-and-pneumatic-tools/compressors/tool-shop-6-gallon-air-compressor-with-13-pc-accessory-kit/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
 | Tool Shop 2-Gallon Air Compressor | 2 | 2 | 0.7 | 100 | 689.475729 | $54.00 | http://www.menards.com/main/tools-hardware/power-tools/pneumatic/2-gallon-air-compressor/p-1442765.htm
