Logiant/AgileRoboticControls/SolidWorks Models/Leg Assembly.SLDASM

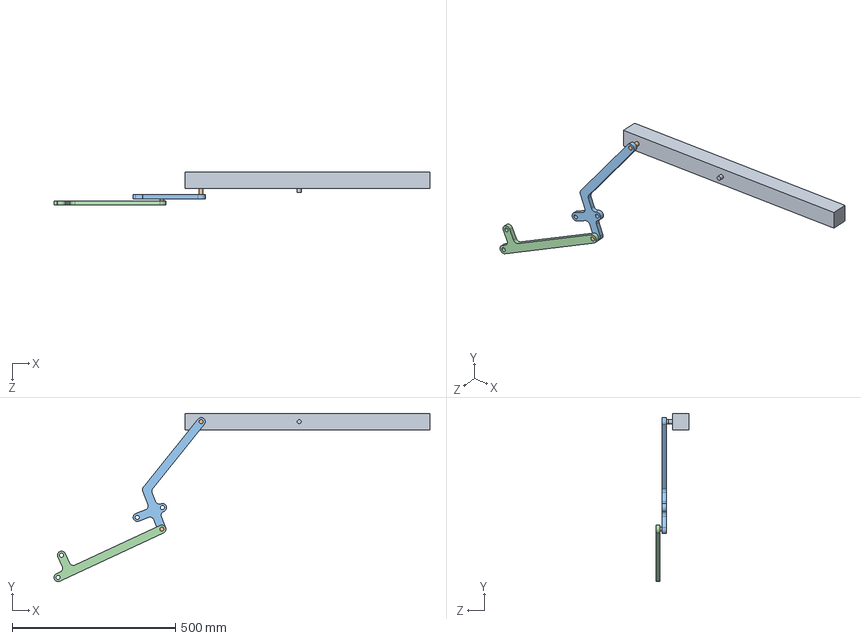
[picture p157: CAD file, 2015-02-17]
SolidWorks Models/Leg Assembly.SLDASM
1150.2 x 514.4 x 101.6 mm
Mounting
Pin Joint x 2
Thigh
Shank
