Logiant/AgileRoboticControls/SolidWorks Models/Solid Models/Doge 4.0.SLDASM

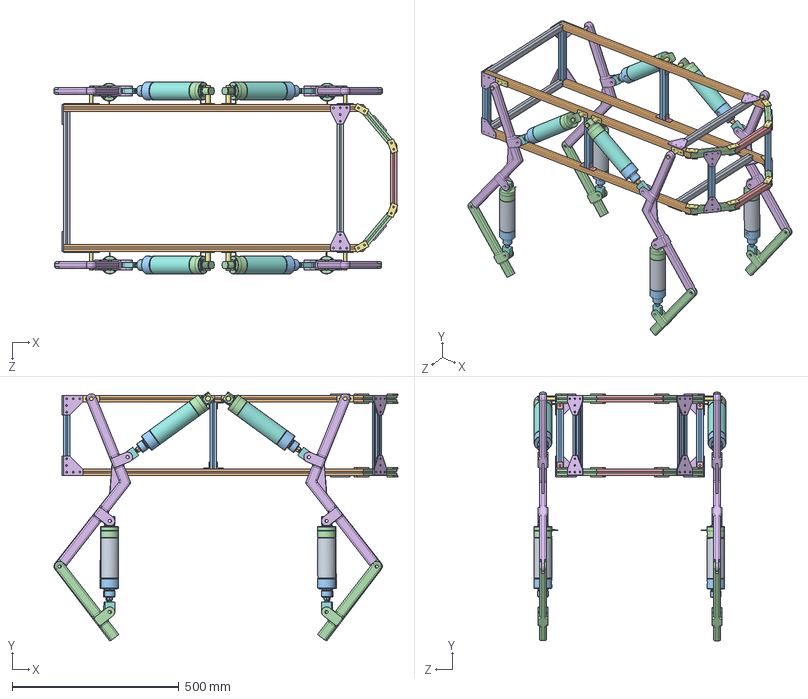
[picture p158: CAD file, 2015-02-27]
SolidWorks Models/Solid Models/Doge 4.0.SLDASM
1031.5 x 746.3 x 574.9 mm
Body_2_Back x 4
Body_2_Side x 4
Body_2_Upright x 6
Body_2_Angle x 4
Body_2_Front x 2
90_Degree_Plate x 8
Shoulder_Plate x 4
PFC-31-4 x 4
PFC-314-X__rod x 4
PFCN-314-0_31_stud x 4
PFC-31X-_0_rod_guide x 8
PFC-31X x 8
D-8342-XX x 8
Upper Leg 4.0 x 4
Piston_Plate2 x 4
Piston Attachment x 8
PFC-31-3 x 4
PFC-313-X__rod x 4
PFCN-313-0_31_stud x 4
Lower Leg 3.0 x 4
90_Degree_Bracket x 8
T_Plate x 8
Plate x 16
