Logiant/AgileRoboticControls/SolidWorks Models/Cylinders/3 inch/PFC-313-X.sldasm

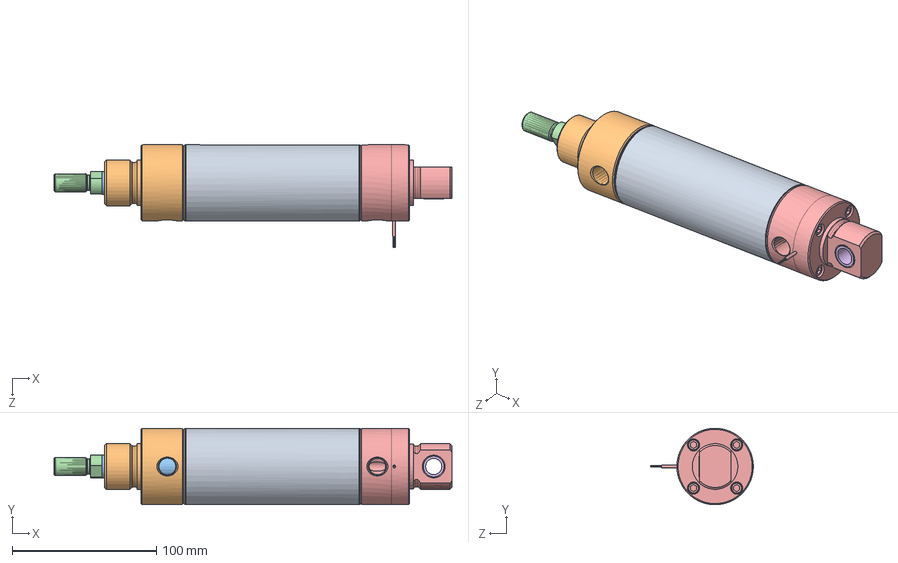
[picture p159: CAD file, 2015-02-17]
SolidWorks Models/Cylinders/3 inch/PFC-313-X.sldasm
276.4 x 53.1 x 71.3 mm
PFC-31-3
PFC-31X-_0_rod_guide
PFC-313-X__rod
PFCN-313-0_31_stud
PFC-31X
D-8342-XX
