Logiant/AgileRoboticControls/SolidWorks Models/Cylinders/4 inch/PFC-314-X.sldasm

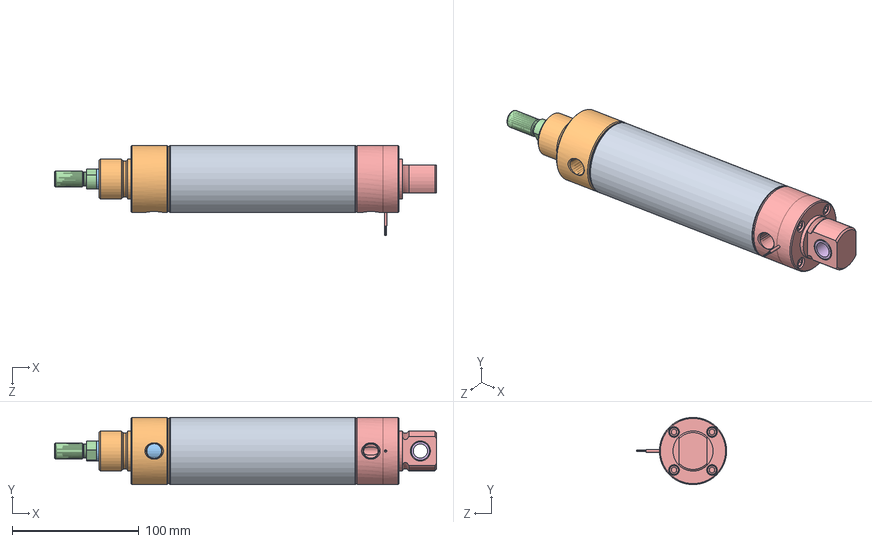
[picture p160: CAD file, 2015-02-17]
SolidWorks Models/Cylinders/4 inch/PFC-314-X.sldasm
301.8 x 53.1 x 71.3 mm
PFC-31-4
PFC-31X-_0_rod_guide
PFC-314-X__rod
PFCN-314-0_31_stud
PFC-31X
D-8342-XX
