Logiant/AgileRoboticControls/SolidWorks Models/Cylinders/3 inch/PFC-31X-_0_rod_guide.sldprt

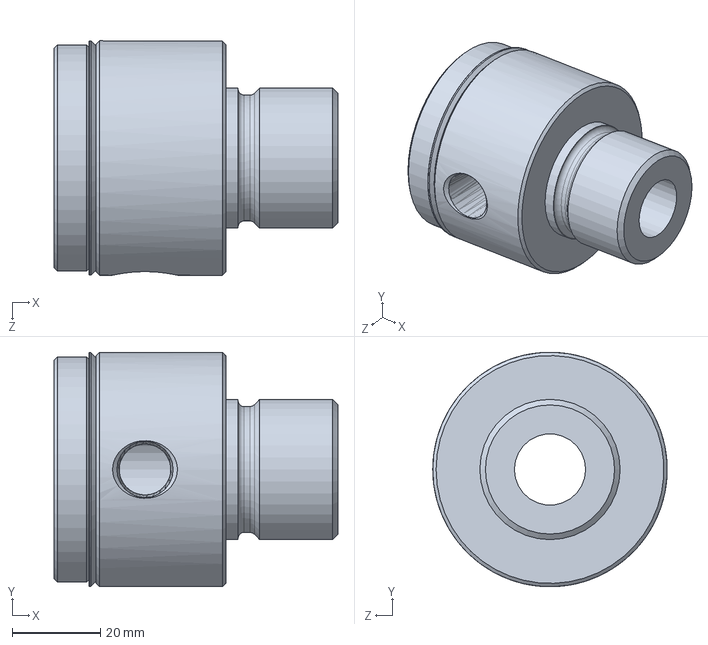
[picture p161: CAD file, 2015-02-17]
SolidWorks Models/Cylinders/3 inch/PFC-31X-_0_rod_guide.sldprt
64.3 x 53.1 x 53.1 mm
