Logiant/AgileRoboticControls/SolidWorks Models/Leg Components/Mounting.SLDPRT

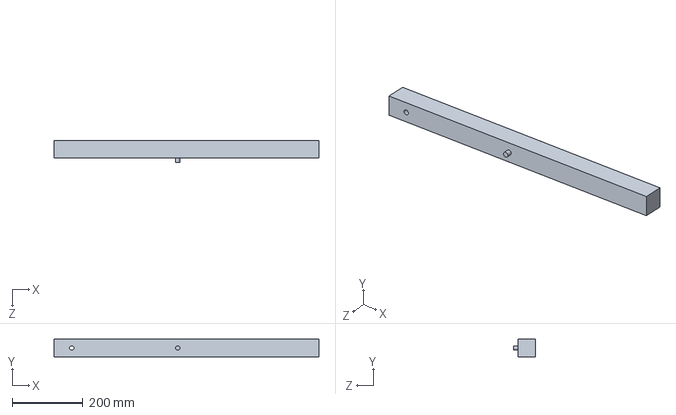
[picture p162: CAD file, 2015-02-17]
SolidWorks Models/Leg Components/Mounting.SLDPRT
750.0 x 50.8 x 63.5 mm
