Logiant/AgileRoboticControls/System Modelling/Mechanical/Agile Controls Simulation/Thigh.SLDPRT

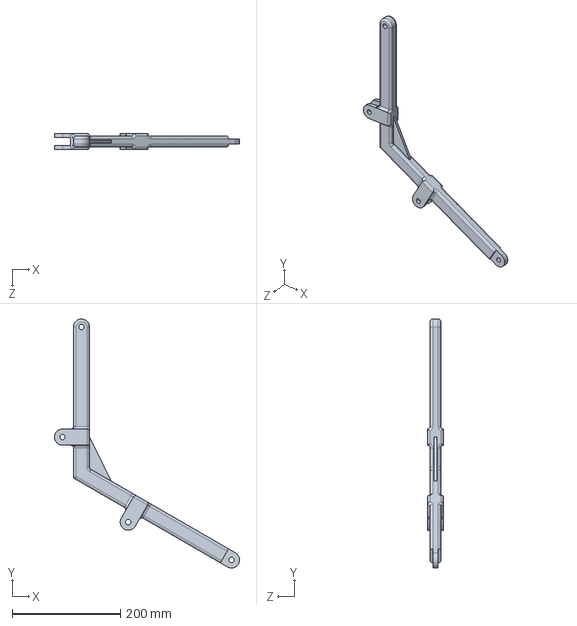
[picture p163: CAD file, 2015-02-19]
System Modelling/Mechanical/Agile Controls Simulation/Thigh.SLDPRT
342.1 x 460.0 x 30.0 mm
