Logiant/AgileRoboticControls/System Modelling/Mechanical/Finite Elements/Shank.IGS

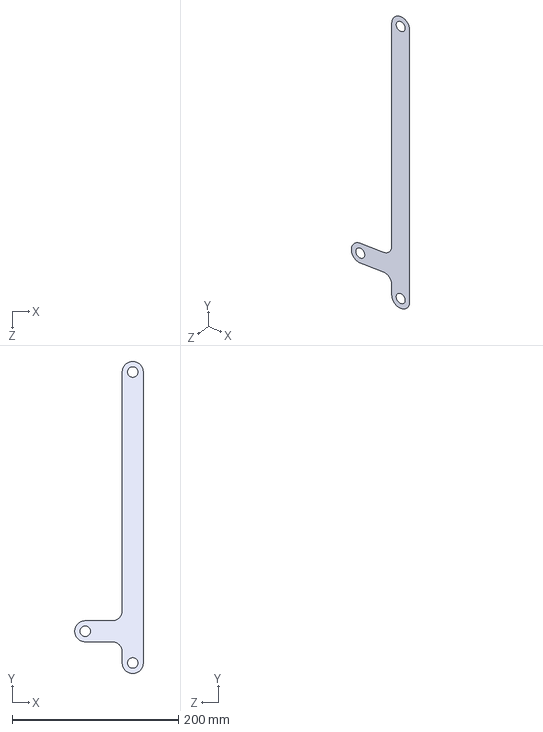
[picture p164: CAD file, 2015-02-13]
System Modelling/Mechanical/Finite Elements/Shank.IGS
82.5 x 375.4 x 0 mm
