Logiant/AgileRoboticControls/SolidWorks Models/Cylinders/3 inch/PFC-31-3.sldprt

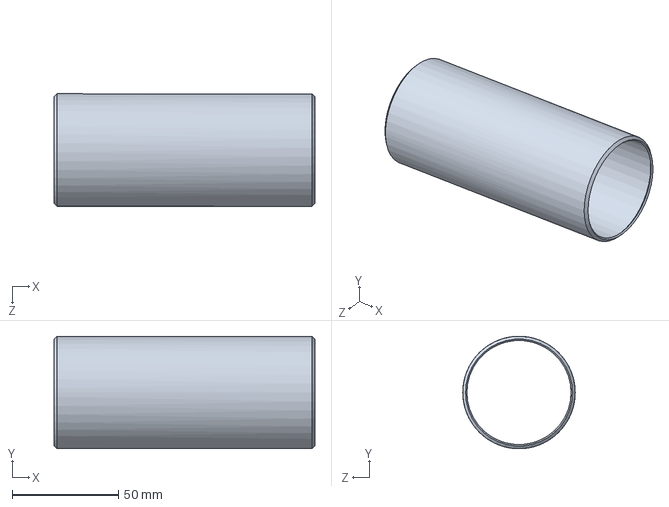
[picture p165: CAD file, 2015-02-17]
SolidWorks Models/Cylinders/3 inch/PFC-31-3.sldprt
122.9 x 52.9 x 53.0 mm
