Logiant/AgileRoboticControls/SolidWorks Models/Leg Components/Shank.SLDPRT

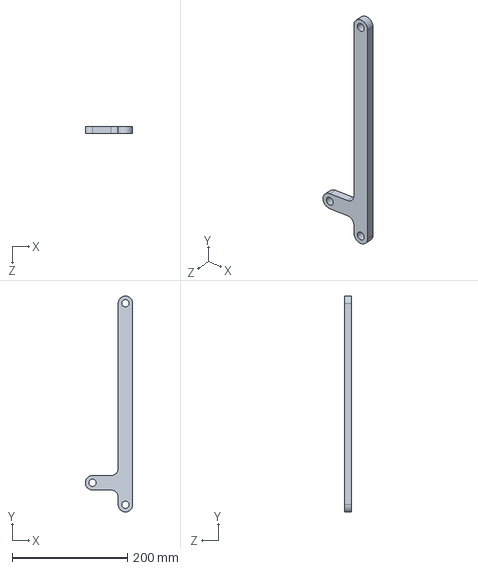
[picture p166: CAD file, 2015-02-13]
SolidWorks Models/Leg Components/Shank.SLDPRT
82.5 x 375.4 x 12.7 mm
