Logiant/AgileRoboticControls/SolidWorks Models/Pneumatic Box.SLDPRT

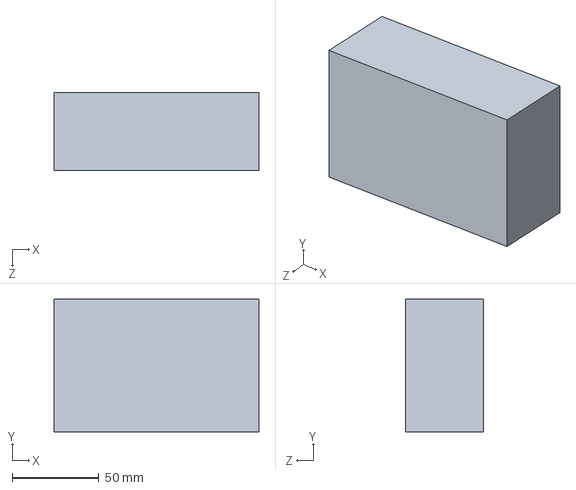
[picture p167: CAD file, 2014-11-13]
SolidWorks Models/Pneumatic Box.SLDPRT
118.0 x 76.4 x 45.0 mm
