Logiant/AgileRoboticControls/System Modelling/Mechanical/Agile Controls Simulation/Shank.SLDPRT

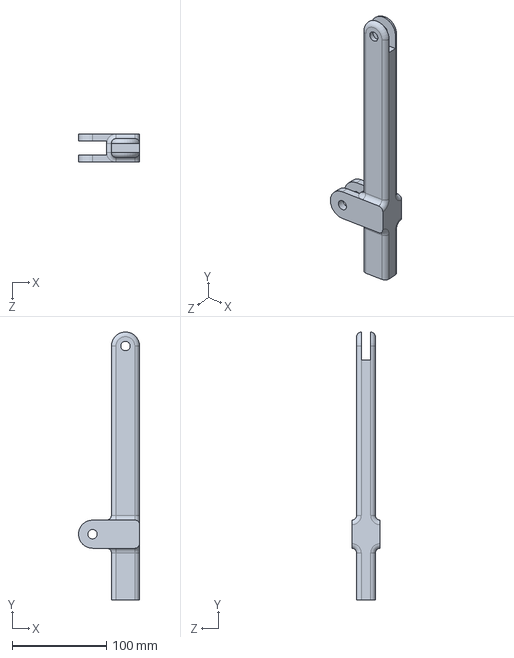
[picture p168: CAD file, 2015-02-19]
System Modelling/Mechanical/Agile Controls Simulation/Shank.SLDPRT
65.0 x 284.9 x 30.0 mm
