Logiant/AgileRoboticControls/System Modelling/Mechanical/Finite Elements/Thigh.IGS

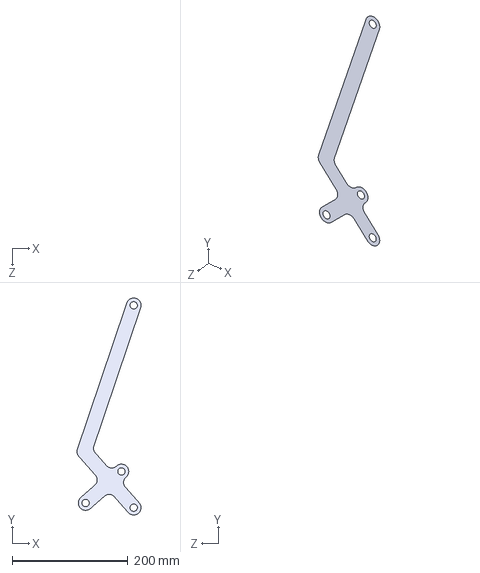
[picture p169: CAD file, 2015-02-13]
System Modelling/Mechanical/Finite Elements/Thigh.IGS
110.9 x 375.4 x 0 mm
