Logiant/AgileRoboticControls/SolidWorks Models/Cylinders/3 inch/PFCN-313-0_31_stud.sldprt

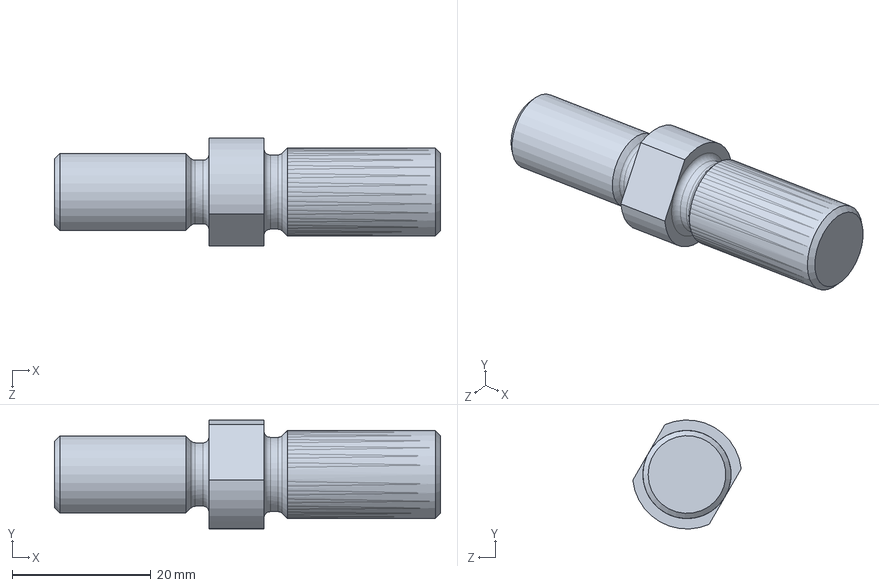
[picture p170: CAD file, 2015-02-17]
SolidWorks Models/Cylinders/3 inch/PFCN-313-0_31_stud.sldprt
55.6 x 15.7 x 15.6 mm
