Logiant/AgileRoboticControls/SolidWorks Models/Cylinders/4 inch/PFC-31X.sldprt

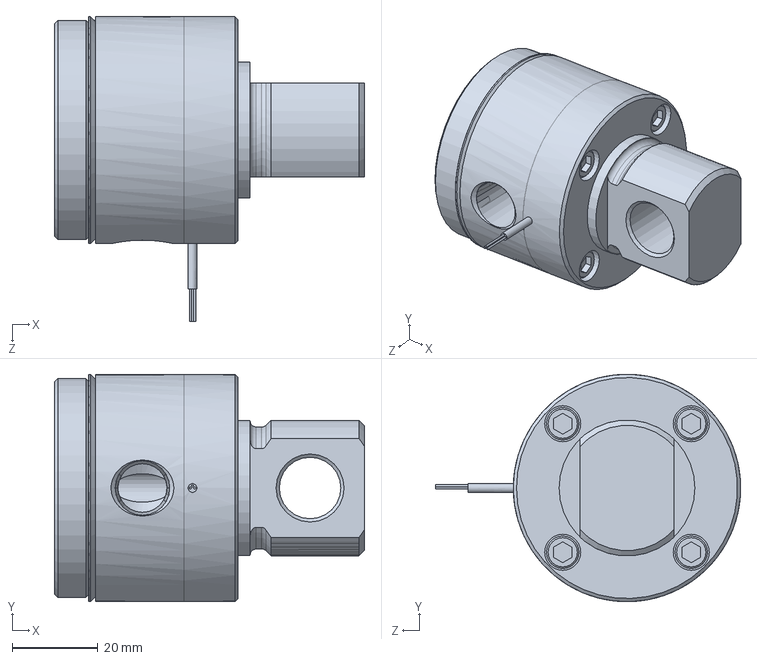
[picture p171: CAD file, 2015-02-17]
SolidWorks Models/Cylinders/4 inch/PFC-31X.sldprt
72.3 x 53.1 x 71.3 mm
