Logiant/AgileRoboticControls/SolidWorks Models/Leg Components/Thigh.SLDPRT

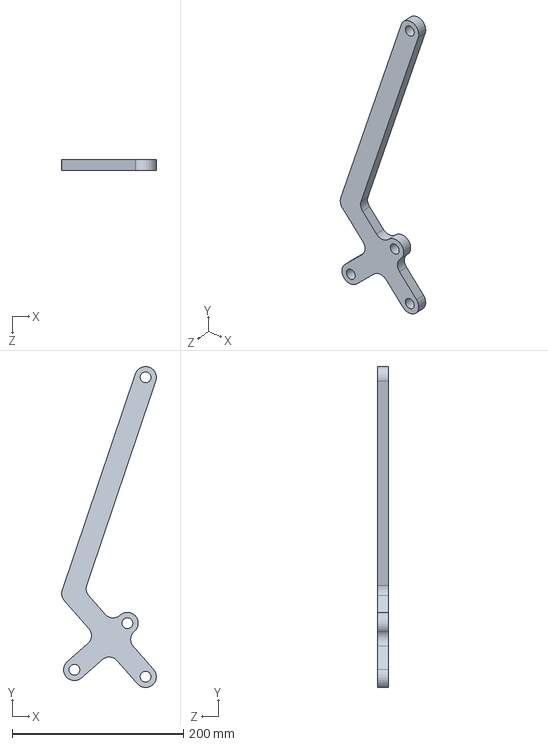
[picture p172: CAD file, 2015-02-13]
SolidWorks Models/Leg Components/Thigh.SLDPRT
110.9 x 375.3 x 12.7 mm
