Logiant/AgileRoboticControls/SolidWorks Models/Microcontroller.SLDPRT

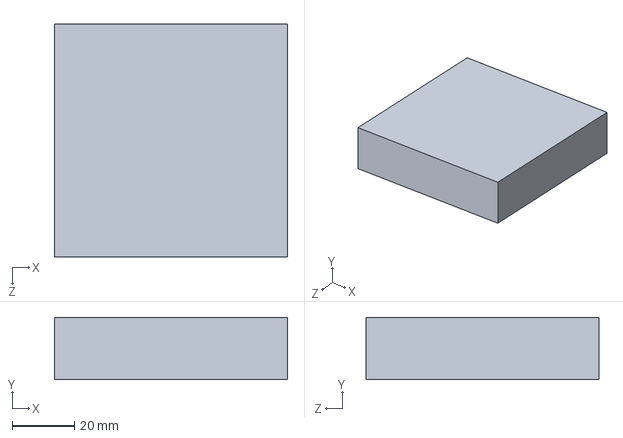
[picture p173: CAD file, 2014-11-13]
SolidWorks Models/Microcontroller.SLDPRT
75.0 x 20.0 x 75.0 mm
