Logiant/AgileRoboticControls/SolidWorks Models/Solid Models/90_Degree_Extended_Bracket.SLDPRT

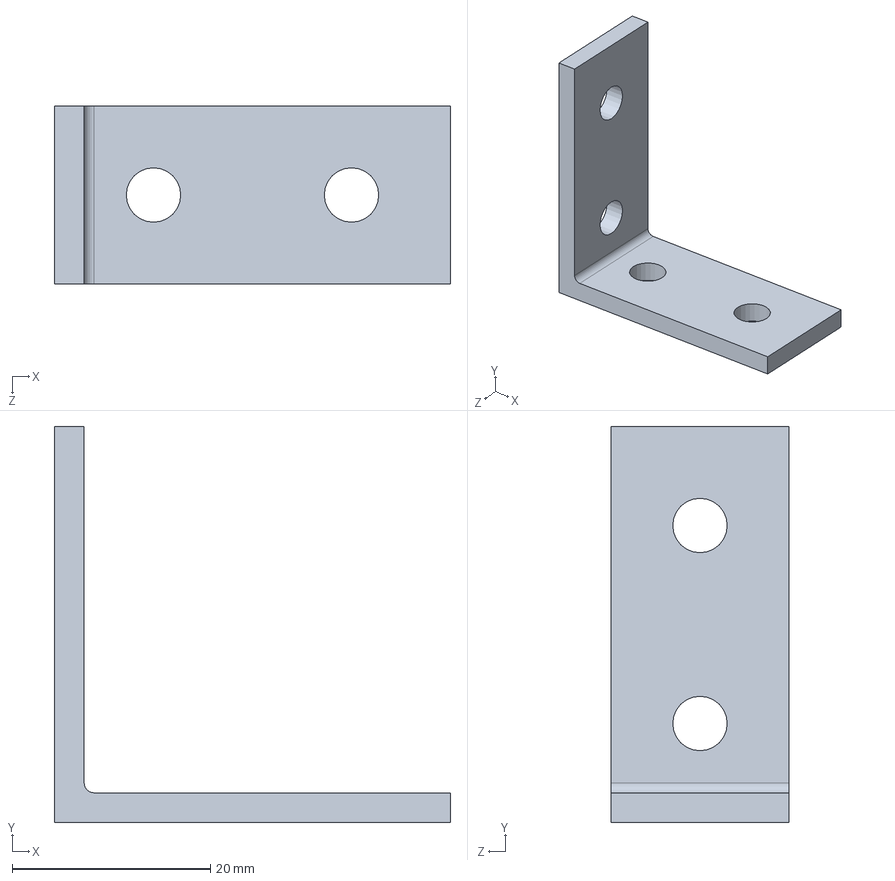
[picture p174: CAD file, 2015-02-17]
SolidWorks Models/Solid Models/90_Degree_Extended_Bracket.SLDPRT
40.0 x 40.0 x 18.0 mm
