Logiant/AgileRoboticControls/System Modelling/Mechanical/Agile Controls Simulation/Link2.SLDPRT

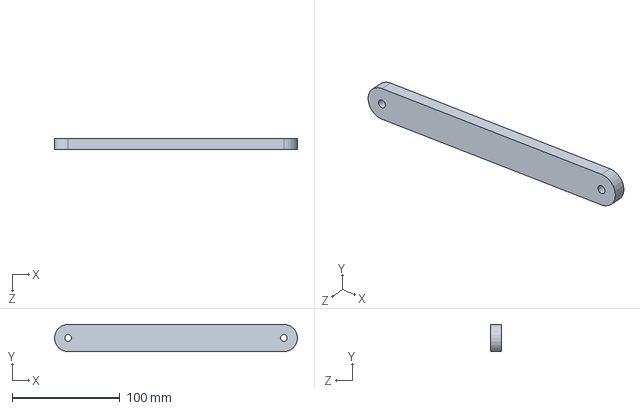
[picture p175: CAD file, 2014-12-04]
System Modelling/Mechanical/Agile Controls Simulation/Link2.SLDPRT
225.4 x 25.4 x 10.0 mm
