Logiant/AgileRoboticControls/System Modelling/Mechanical/Finite Elements/Pin Joint.IGS

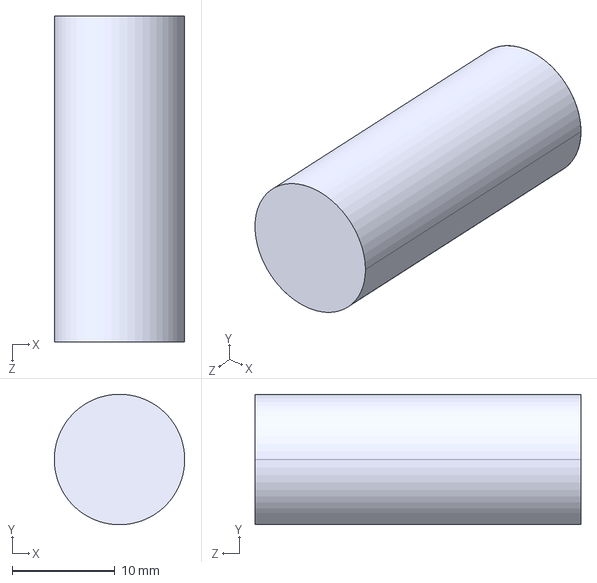
[picture p176: CAD file, 2015-02-13]
System Modelling/Mechanical/Finite Elements/Pin Joint.IGS
12.7 x 12.7 x 31.8 mm
