Logiant/AgileRoboticControls/SolidWorks Models/DebugBoard.SLDPRT

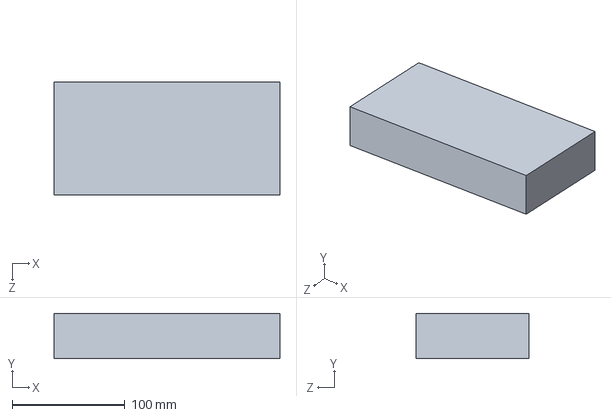
[picture p177: CAD file, 2014-11-13]
SolidWorks Models/DebugBoard.SLDPRT
200.0 x 40.0 x 100.0 mm
