Logiant/AgileRoboticControls/SolidWorks Models/Solid Models/Shoulder_Plate.SLDPRT

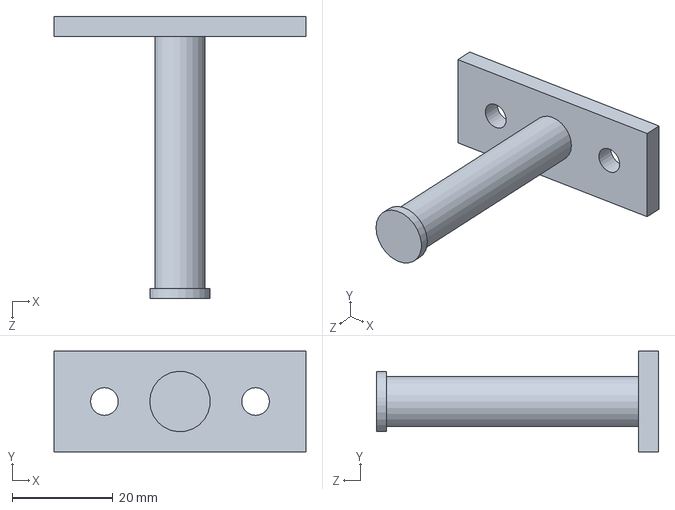
[picture p178: CAD file, 2015-02-17]
SolidWorks Models/Solid Models/Shoulder_Plate.SLDPRT
50.0 x 20.0 x 56.0 mm
