Logiant/AgileRoboticControls/System Modelling/Mechanical/Agile Controls Simulation/Link1.SLDPRT

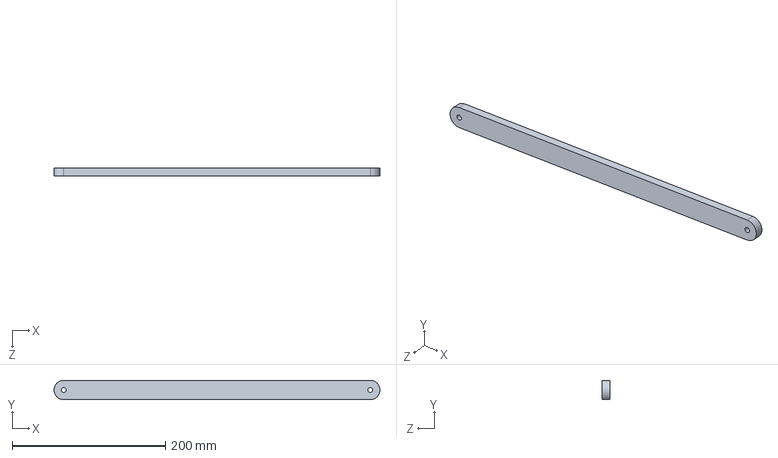
[picture p179: CAD file, 2014-12-04]
System Modelling/Mechanical/Agile Controls Simulation/Link1.SLDPRT
425.4 x 25.4 x 10.0 mm
