Logiant/AgileRoboticControls/SolidWorks Models/Cylinders/3 inch/D-8342-XX.sldprt

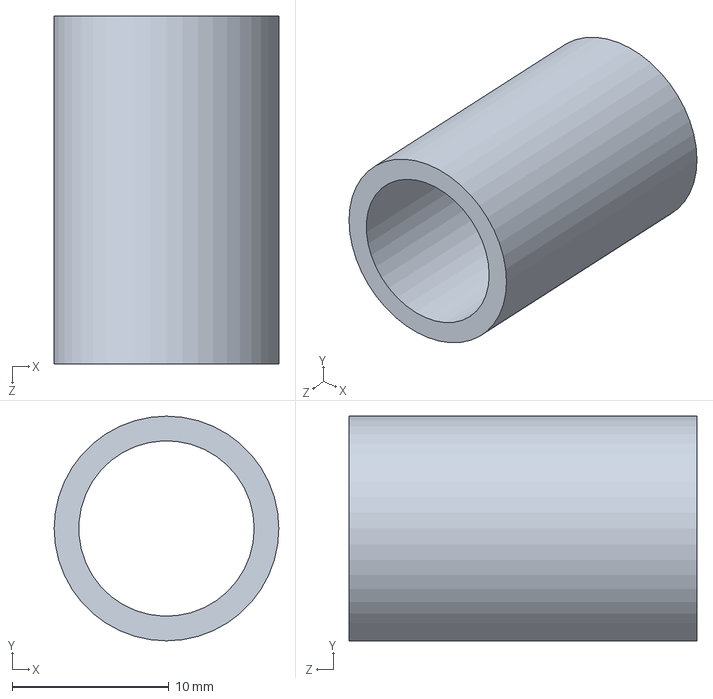
[picture p180: CAD file, 2015-02-17]
SolidWorks Models/Cylinders/3 inch/D-8342-XX.sldprt
14.4 x 14.4 x 22.2 mm
