Logiant/AgileRoboticControls/SolidWorks Models/Cylinders/3 inch/PFC-313-X__rod.sldprt

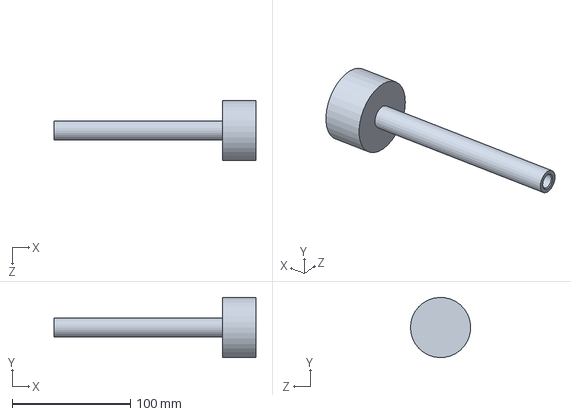
[picture p181: CAD file, 2015-02-17]
SolidWorks Models/Cylinders/3 inch/PFC-313-X__rod.sldprt
170.7 x 50.8 x 50.8 mm
