Logiant/AgileRoboticControls/SolidWorks Models/Cylinders/4 inch/PFC-31-4.sldprt

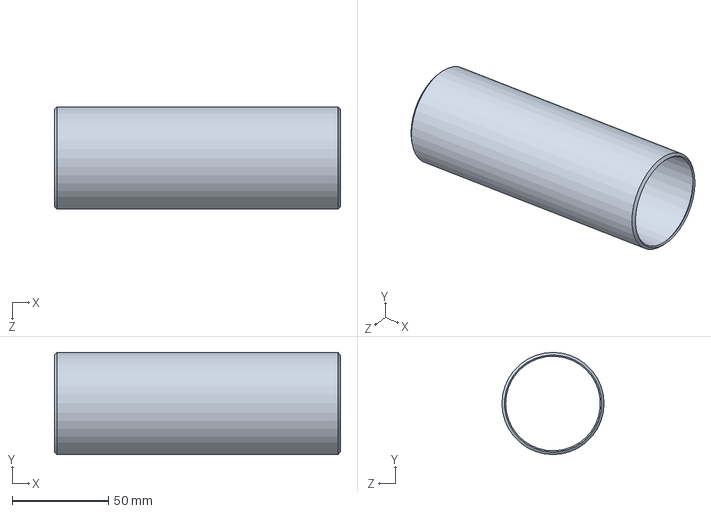
[picture p182: CAD file, 2015-02-17]
SolidWorks Models/Cylinders/4 inch/PFC-31-4.sldprt
148.3 x 53.0 x 53.0 mm
