Logiant/AgileRoboticControls/SolidWorks Models/Solid Models/Body_2_Side.SLDPRT

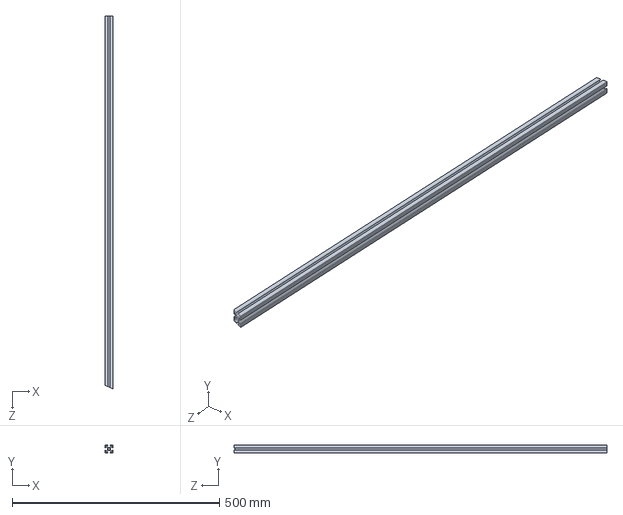
[picture p183: CAD file, 2015-02-17]
SolidWorks Models/Solid Models/Body_2_Side.SLDPRT
20.0 x 20.0 x 900.0 mm
