Logiant/AgileRoboticControls/SolidWorks Models/Leg Components/Side Wall.SLDPRT

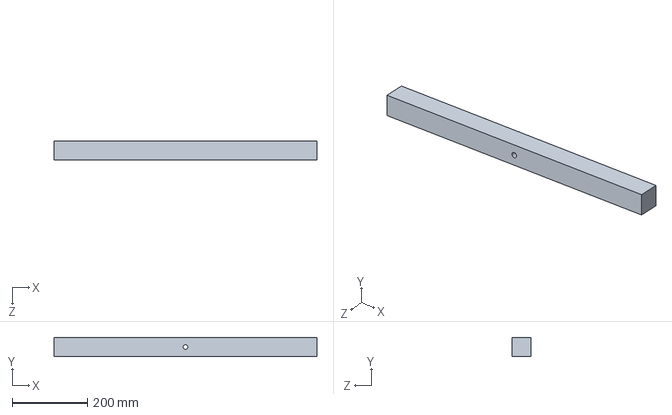
[picture p184: CAD file, 2015-02-13]
SolidWorks Models/Leg Components/Side Wall.SLDPRT
700.0 x 50.8 x 50.8 mm
