Logiant/AgileRoboticControls/SolidWorks Models/Solid Models/Body_2_Front.SLDPRT

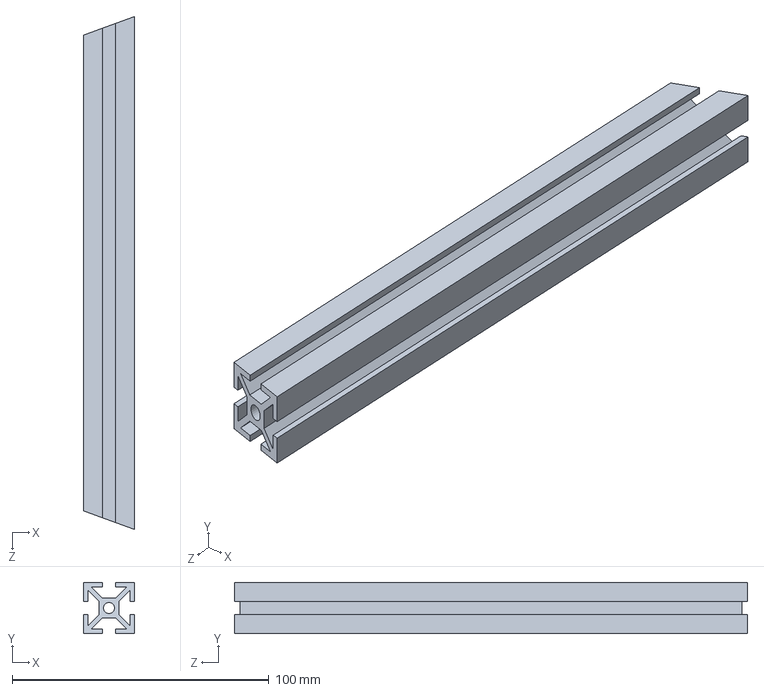
[picture p185: CAD file, 2015-02-17]
SolidWorks Models/Solid Models/Body_2_Front.SLDPRT
20.0 x 20.0 x 200.0 mm
