Logiant/AgileRoboticControls/SolidWorks Models/Cylinders/4 inch/PFC-314-X__rod.sldprt

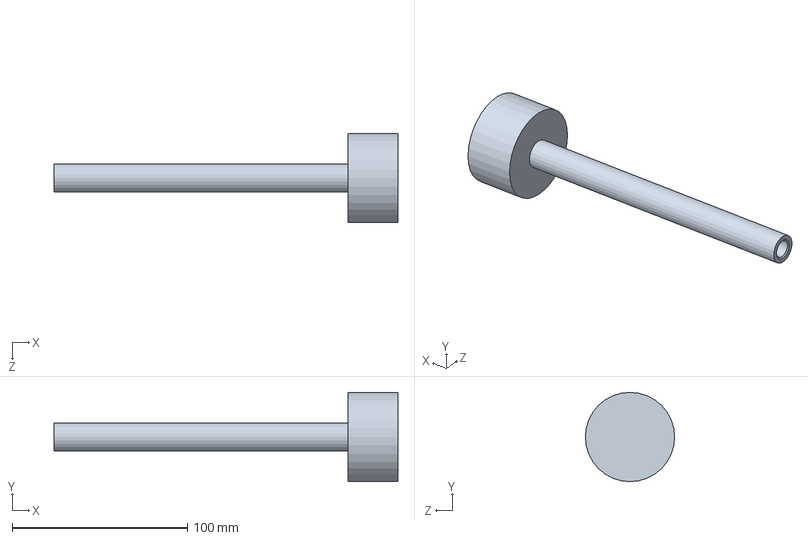
[picture p186: CAD file, 2015-02-17]
SolidWorks Models/Cylinders/4 inch/PFC-314-X__rod.sldprt
196.1 x 50.9 x 50.9 mm
