Logiant/AgileRoboticControls/SolidWorks Models/Solid Models/90_Degree_Plate.SLDPRT

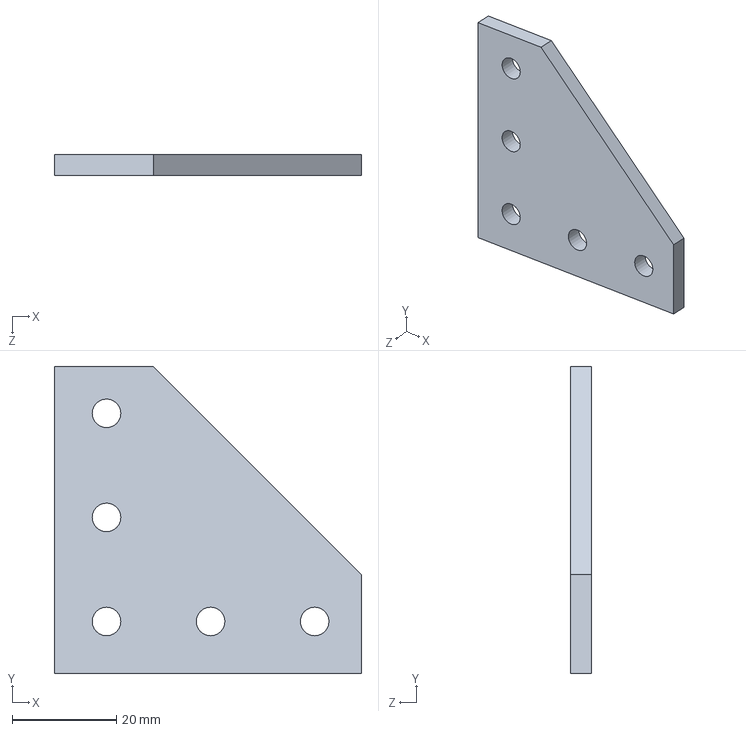
[picture p187: CAD file, 2015-02-17]
SolidWorks Models/Solid Models/90_Degree_Plate.SLDPRT
59.0 x 59.0 x 4.00 mm
