Logiant/AgileRoboticControls/SolidWorks Models/Solid Models/90_Degree_Bracket.SLDPRT

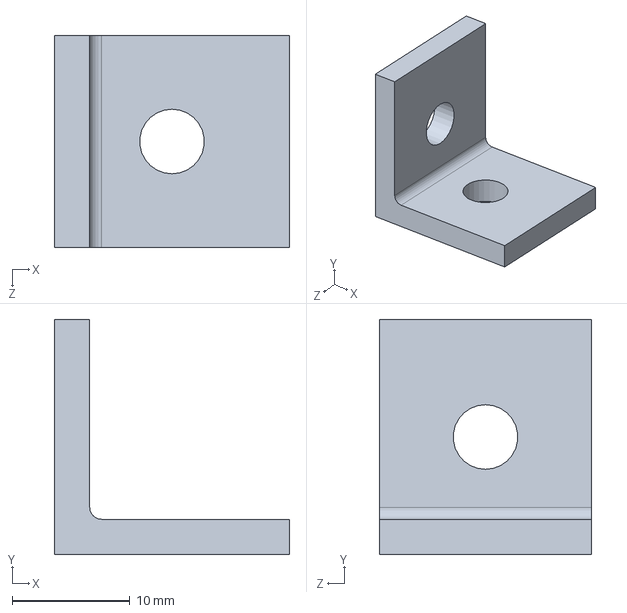
[picture p188: CAD file, 2015-02-17]
SolidWorks Models/Solid Models/90_Degree_Bracket.SLDPRT
20.0 x 20.0 x 18.0 mm
