Logiant/AgileRoboticControls/SolidWorks Models/Solid Models/T_Plate.SLDPRT

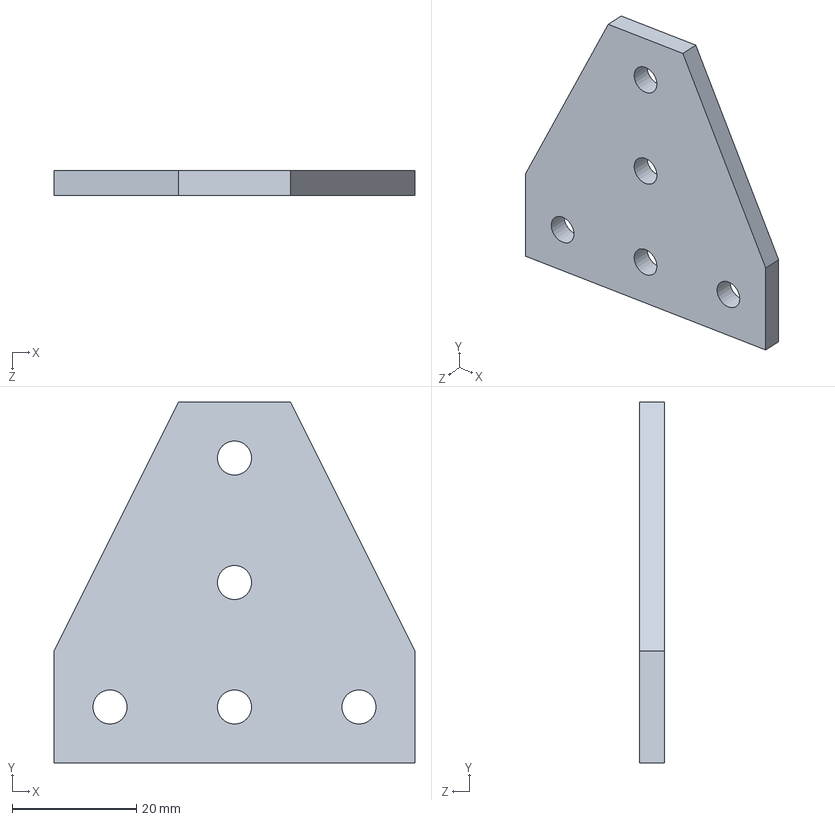
[picture p189: CAD file, 2015-02-17]
SolidWorks Models/Solid Models/T_Plate.SLDPRT
58.0 x 58.0 x 4.00 mm
