Logiant/AgileRoboticControls/SolidWorks Models/Solid Models/Body_2_Angle.SLDPRT

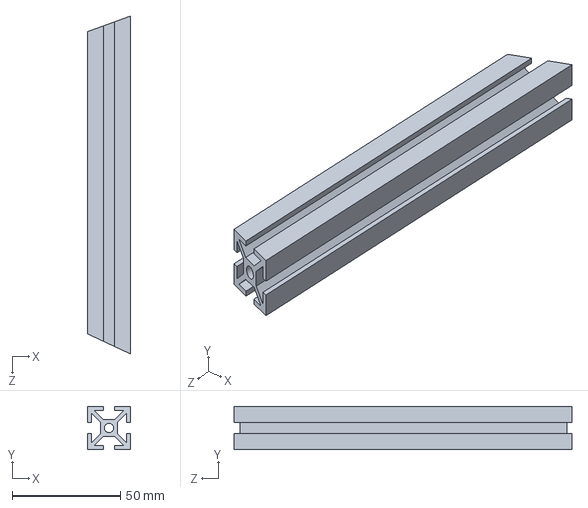
[picture p190: CAD file, 2015-02-17]
SolidWorks Models/Solid Models/Body_2_Angle.SLDPRT
20.0 x 20.0 x 156.2 mm
