Logiant/AgileRoboticControls/SolidWorks Models/Solid Models/Foot 2.0.SLDPRT

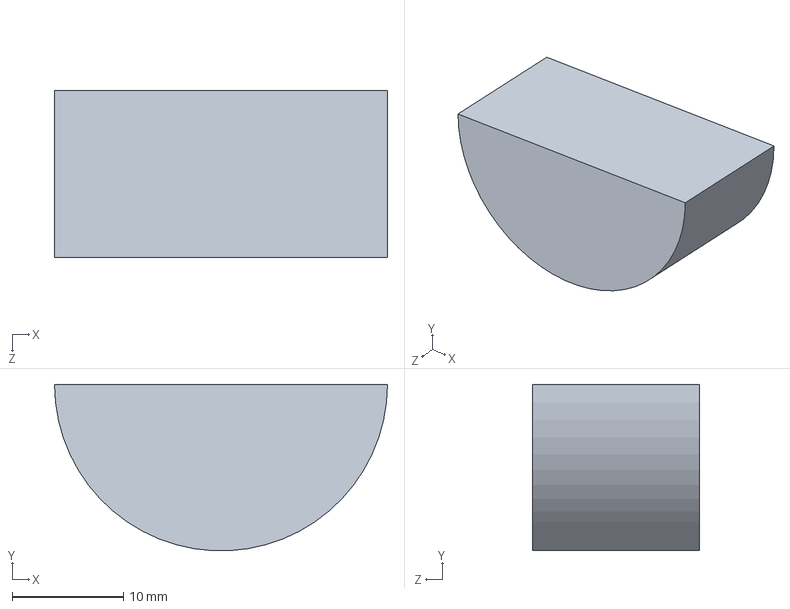
[picture p191: CAD file, 2015-02-17]
SolidWorks Models/Solid Models/Foot 2.0.SLDPRT
30.0 x 15.0 x 15.0 mm
