Logiant/AgileRoboticControls/SolidWorks Models/Solid Models/Body_2_Upright.SLDPRT

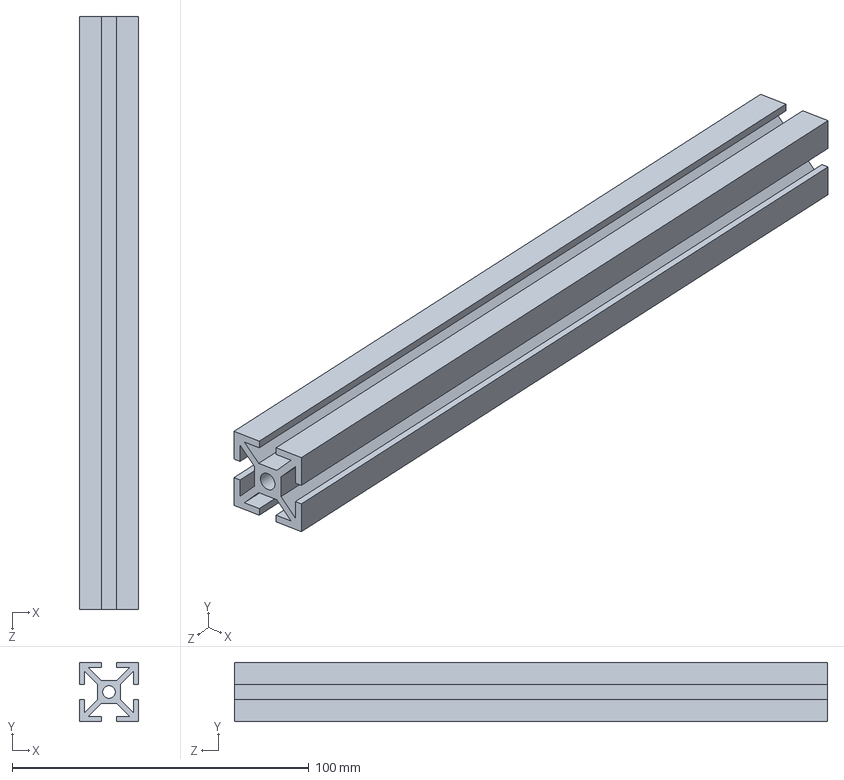
[picture p192: CAD file, 2015-02-17]
SolidWorks Models/Solid Models/Body_2_Upright.SLDPRT
20.0 x 20.0 x 200.0 mm
