Logiant/AgileRoboticControls/SolidWorks Models/Solid Models/Piston_Plate2.SLDPRT

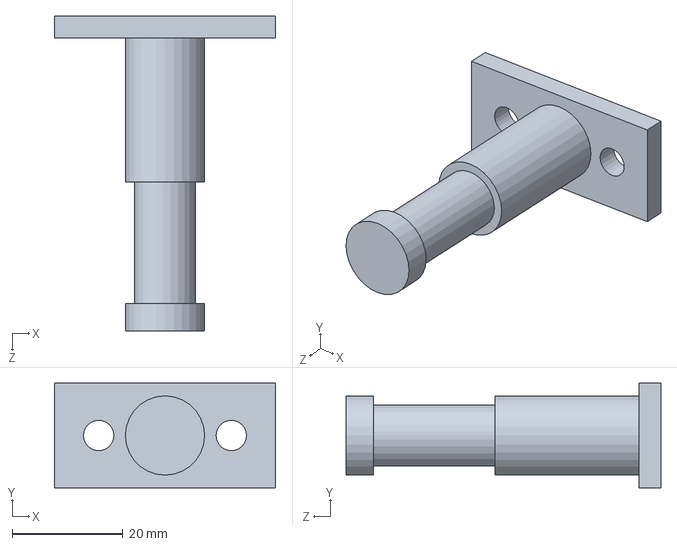
[picture p193: CAD file, 2015-02-17]
SolidWorks Models/Solid Models/Piston_Plate2.SLDPRT
40.0 x 19.0 x 57.0 mm
