Logiant/AgileRoboticControls/SolidWorks Models/Solid Models/Body_2_Back.SLDPRT

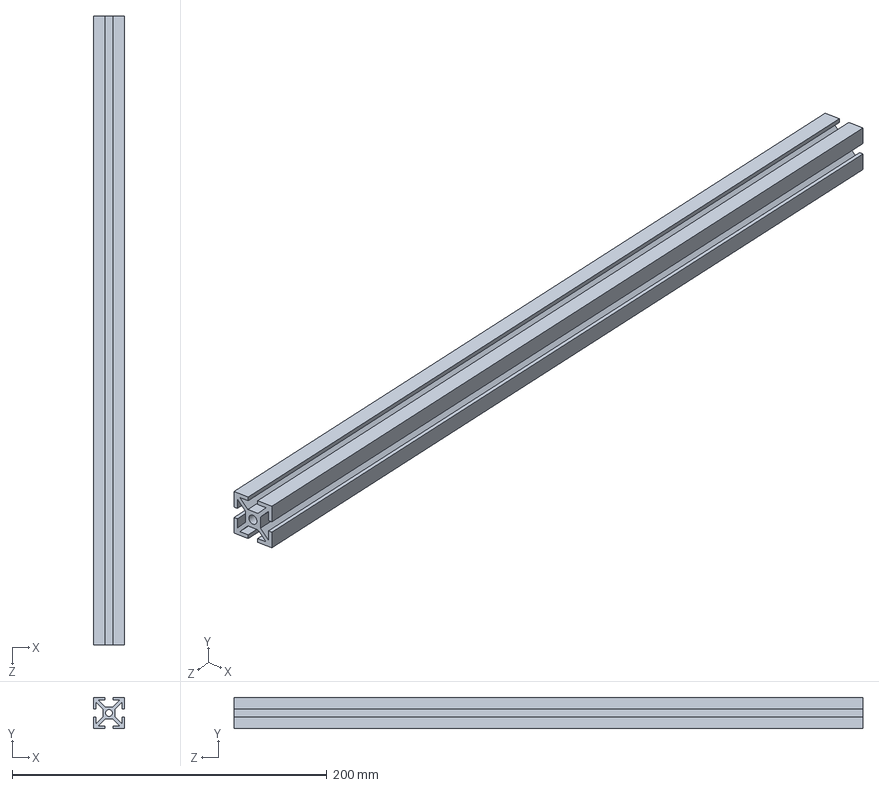
[picture p194: CAD file, 2015-02-17]
SolidWorks Models/Solid Models/Body_2_Back.SLDPRT
20.0 x 20.0 x 400.0 mm
