Logiant/AgileRoboticControls/SolidWorks Models/Solid Models/Plate.SLDPRT

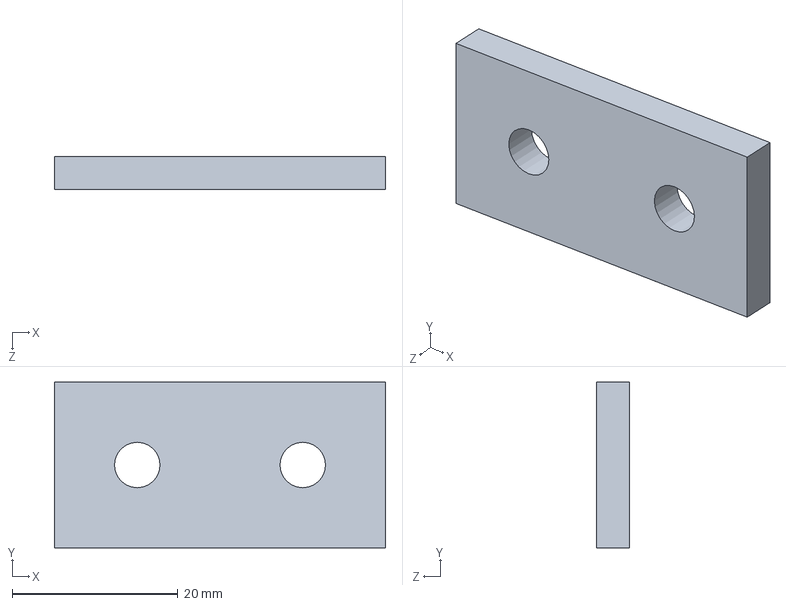
[picture p195: CAD file, 2015-02-17]
SolidWorks Models/Solid Models/Plate.SLDPRT
40.0 x 20.0 x 4.00 mm
