Logiant/AgileRoboticControls/SolidWorks Models/Solid Models/Piston Attachment.SLDPRT

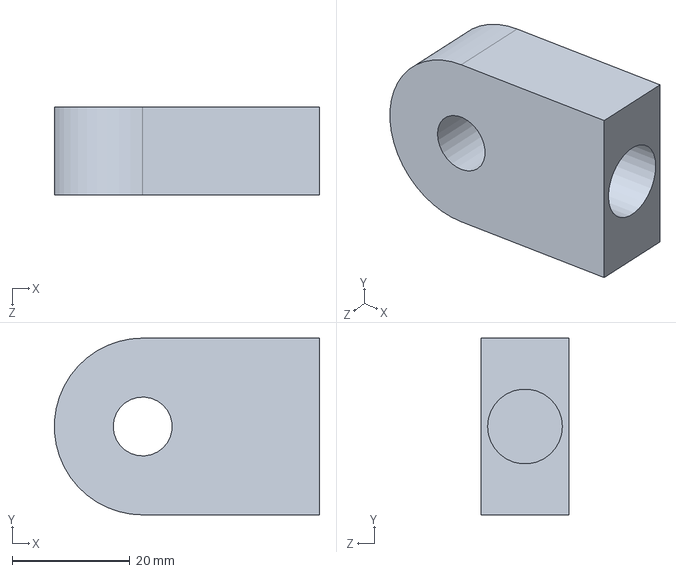
[picture p196: CAD file, 2015-02-17]
SolidWorks Models/Solid Models/Piston Attachment.SLDPRT
45.0 x 30.0 x 15.0 mm
