Logiant/AgileRoboticControls/(list of files, cad)

Other CAD files:
System Modelling/Control/Simulink Code/Cylinder Tests/Hardware Test/SingleCylinderTest_grt_rtw/rt_main.obj
SolidWorks Models/Cylinders/4 inch/PFC-314-X_0_dummy.sldprt
System Modelling/Control/Simulink Code/Cylinder Tests/Hardware Test/SingleCylinderTest_grt_rtw/rt_nonfinite.obj
SolidWorks Models/Cylinders/4 inch/PFC-31X-_0_rod_guide.sldprt
SolidWorks Models/Solid Models/Upper Leg 4.0.SLDPRT
System Modelling/Control/Simulink Code/Cylinder Tests/Hardware Test/SingleCylinderTest_grt_rtw/rtGetInf.obj
SolidWorks Models/Leg Components/Surface_Shank.SLDPRT
System Modelling/Control/Simulink Code/Cylinder Tests/Hardware Test/SingleCylinderTest_grt_rtw/SingleCylinderTest_data.obj
SolidWorks Models/Cylinders/4 inch/PFCN-314-0_31_stud.sldprt
SolidWorks Models/Leg Components/Surface_Thigh.SLDPRT
SolidWorks Models/Solid Models/Lower Leg 3.0.SLDPRT
System Modelling/Control/Simulink Code/Cylinder Tests/Hardware Test/SingleCylinderTest_grt_rtw/SingleCylinderTest.obj
SolidWorks Models/Leg Components/Pin Joint.SLDPRT
System Modelling/Control/Simulink Code/Cylinder Tests/Hardware Test/SingleCylinderTest_grt_rtw/rtGetNaN.obj
SolidWorks Models/Cylinders/3 inch/PFC-313-X_0_dummy.sldprt
SolidWorks Models/Cylinders/4 inch/D-8342-XX.sldprt
System Modelling/Control/Simulink Code/Cylinder Tests/Hardware Test/SingleCylinderTest_grt_rtw/rt_logging.obj
SolidWorks Models/Cylinders/3 inch/PFC-31X.sldprt
SolidWorks Models/Solid Models/ANSYS Models/Doge 4.0.x_t
SolidWorks Models/Solid Models/ANSYS Models/Lower Leg 3.0.x_t
SolidWorks Models/Solid Models/ANSYS Models/Upper Leg.x_t
System Modelling/Mechanical/Agile Controls Simulation/Link1.STL
System Modelling/Mechanical/Agile Controls Simulation/Link2.STL
System Modelling/Mechanical/Agile Controls Simulation/Shank.STL
System Modelling/Mechanical/Agile Controls Simulation/Thigh.STL
