Logiant/AgileRoboticControls/Design/Communication Software/Instructions.docx

Guild to Installing XCTU and Discovering XBee Radios for the Agile Robotics Control Project

1) First install XCTU (Image of installer shown below).
2) Click “Next” on the installer window (Be sure to allow the installer to run on your computer).

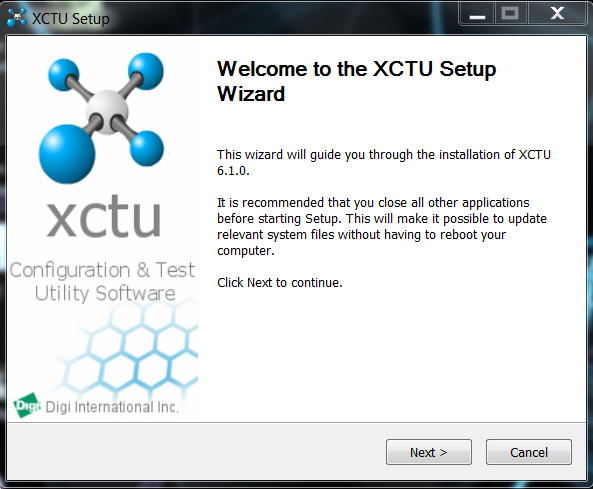
[picture p197: figure]

3) Click “I agree” to the license agreement (After carefully reading everything of course).

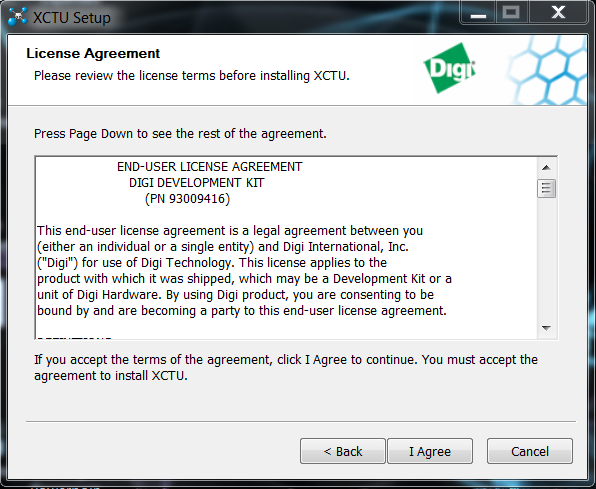
[picture p198: figure]

4) Click “Next”.

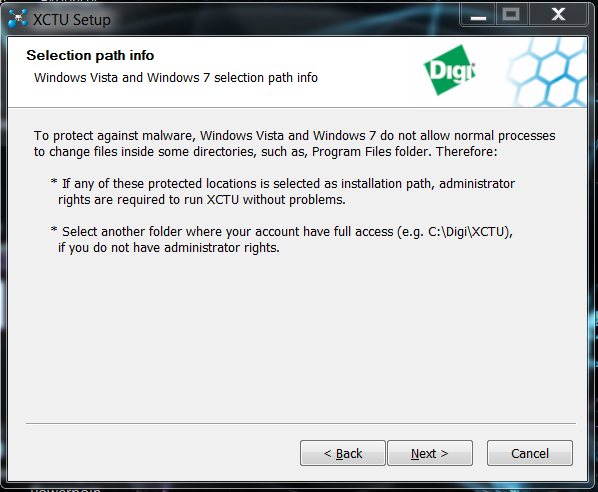
[picture p199: figure]

5) Select an install directory on your computer if you are not using the default. Click “Next”.

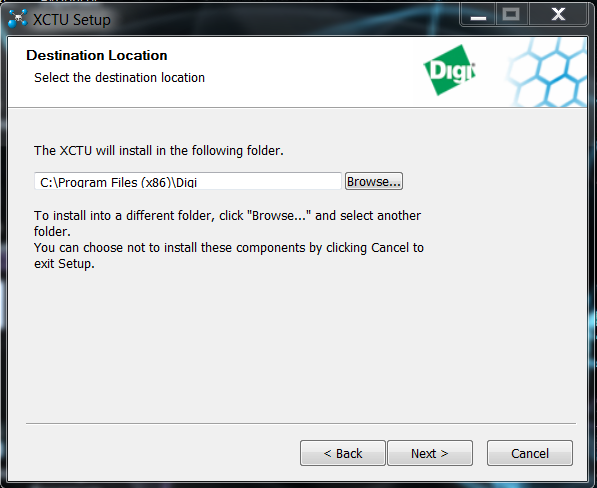
[picture p200: figure]

6) Click the “Install” button.

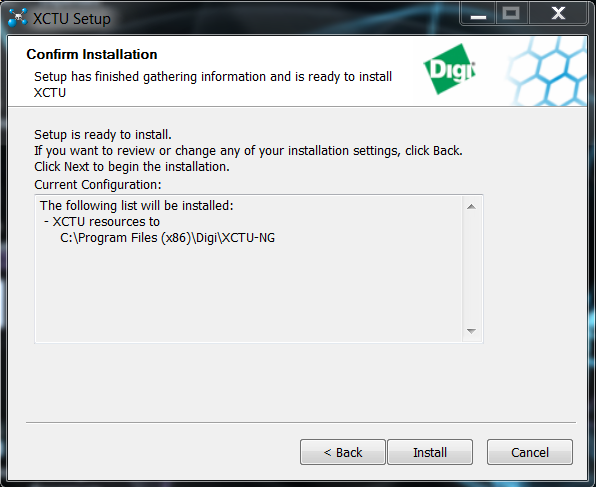
[picture p201: figure]

7) Wait for the installer to finish.

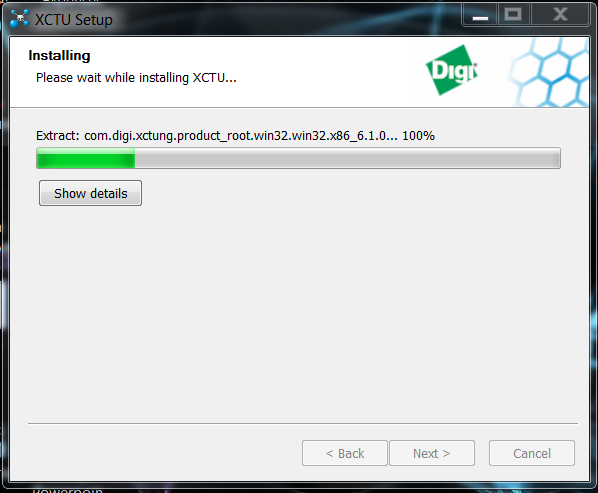
[picture p202: figure]

8) Click “Finish” to complete the setup wizard.

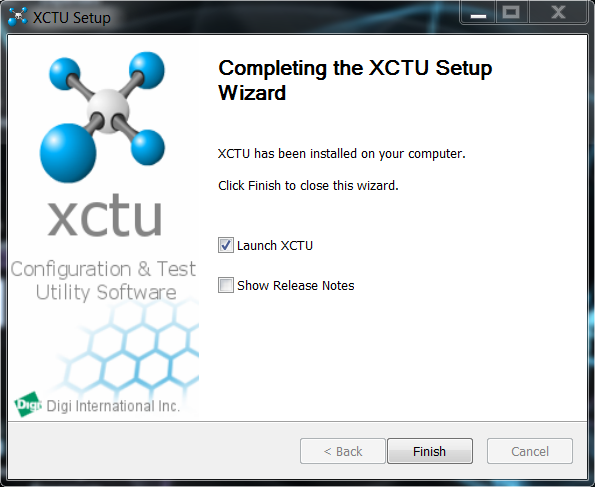
[picture p203: figure]

9) When finished, launch XCTU and this should come up. Click on the updates available on the bottom right corner.

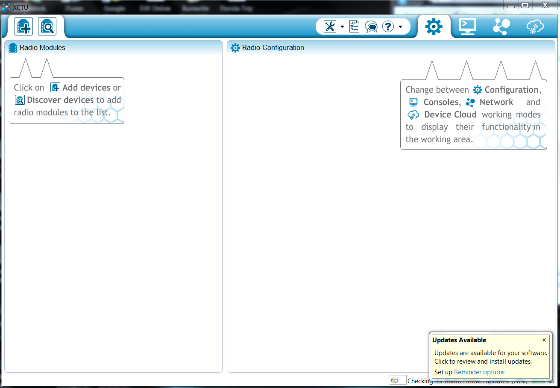
[picture p204: figure]

10) Click “Finish”.

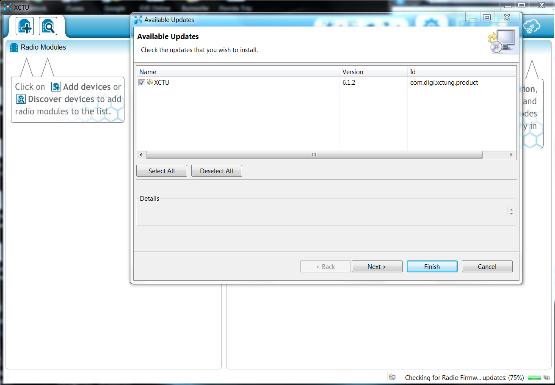
[picture p205: figure]

11) Wait for the update to complete.

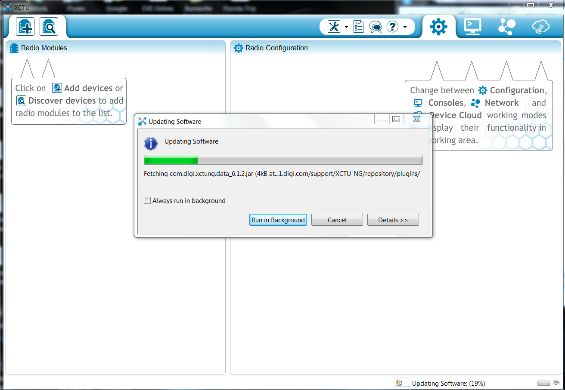
[picture p206: figure]

12) Click “Ok” and continue.

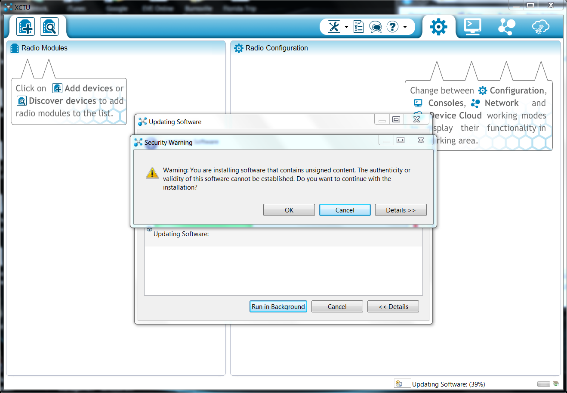
[picture p207: figure]

13) Restart your XCTU for the changes to take effect.

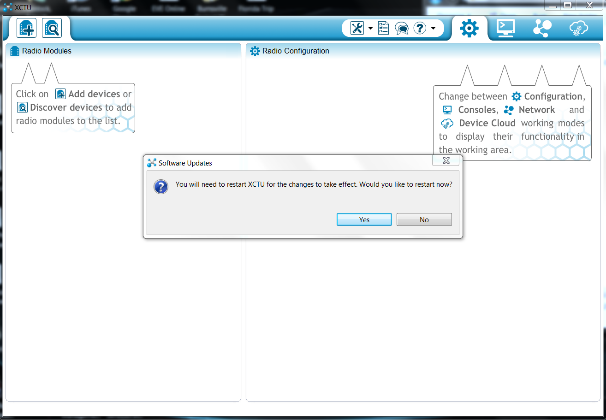
[picture p208: figure]

14) Install the Parallax USB driver (Image of installer shown below).
15) Click “Install” on the Parallax USB Driver Installer.

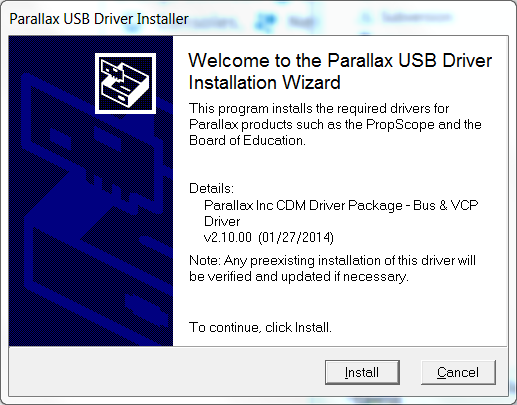
[picture p209: figure]

16) Click “Finish” on the Parallax USB Driver Installation.

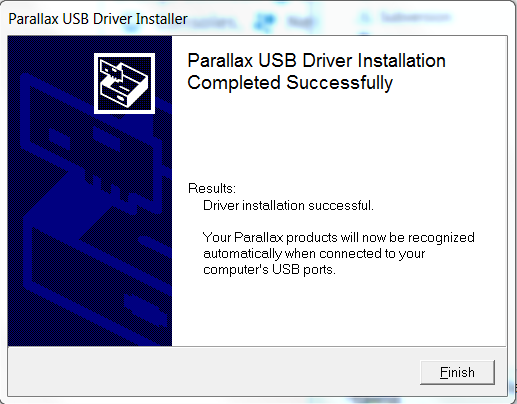
[picture p210: figure]

17) When finished, open XCTU and select the ports you want to scan. Click “Next”.

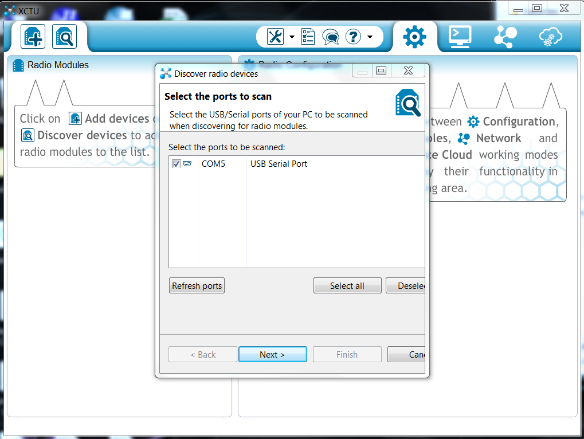
[picture p211: figure]

18) Follow default parameters and click “Finish”.

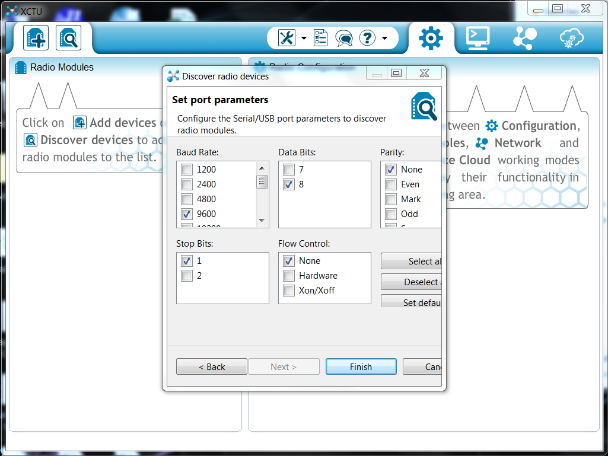
[picture p212: figure]

19) When the device is found, select it and click “Finish”.

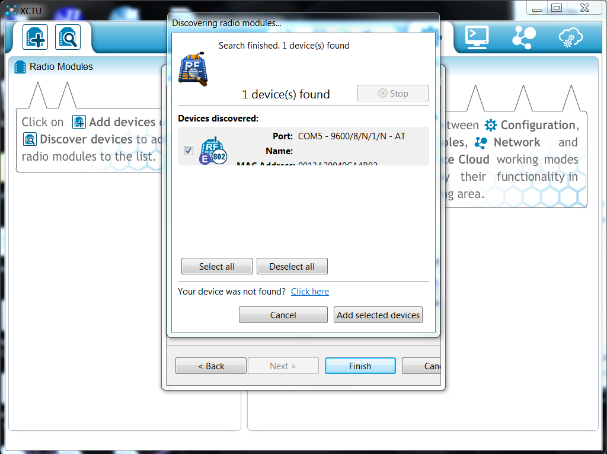
[picture p213: figure]
