Logiant/AgileRoboticControls/Design/Communication Software/Instruction Resource Files/XCTU Update Step 4.PNG

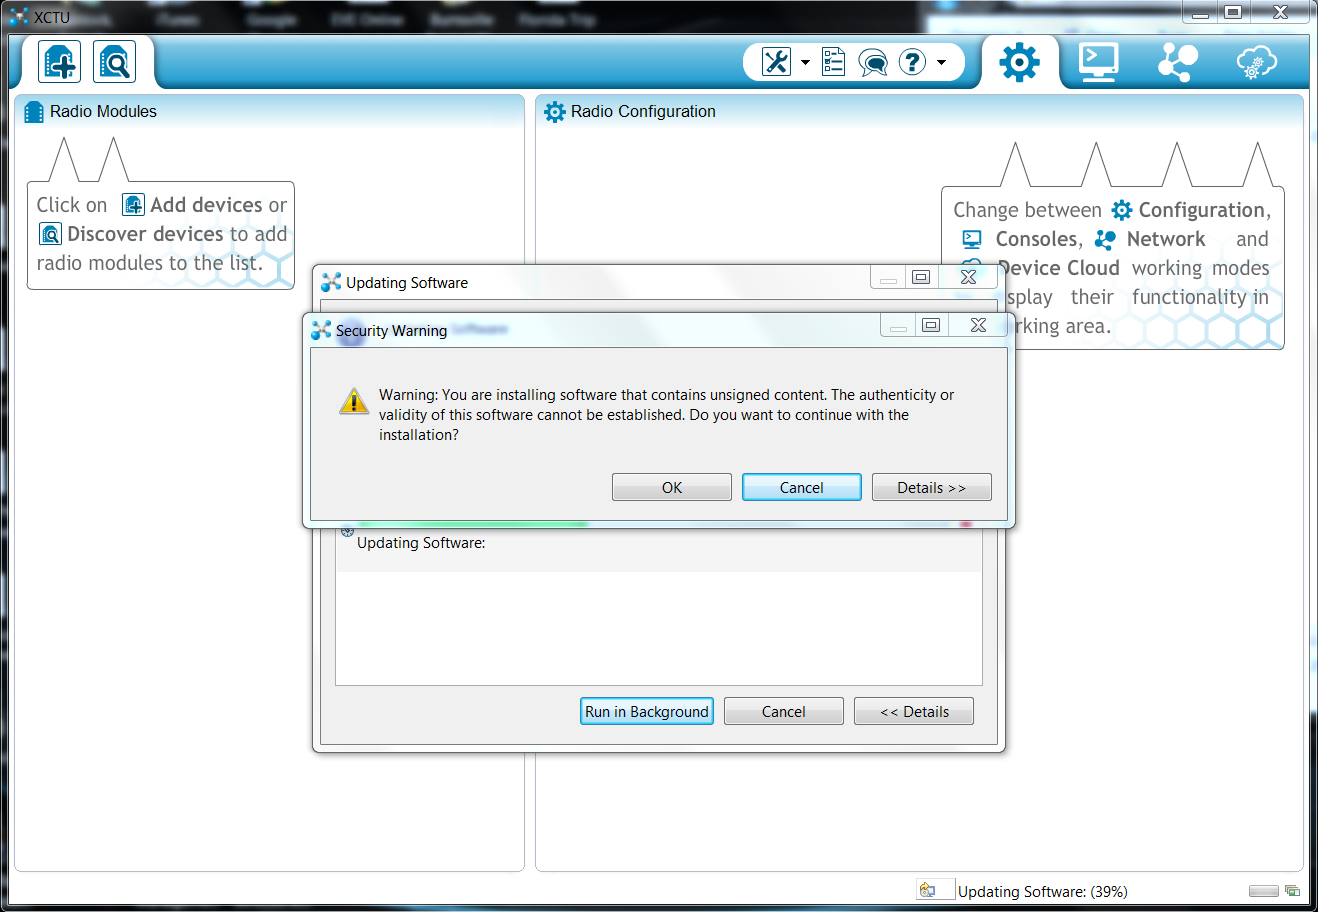
Design/Communication Software/Instruction Resource Files/XCTU Update Step 4.PNG
