Logiant/AgileRoboticControls/Design/Communication Software/Instruction Resource Files/XCTU Update Step 5.PNG

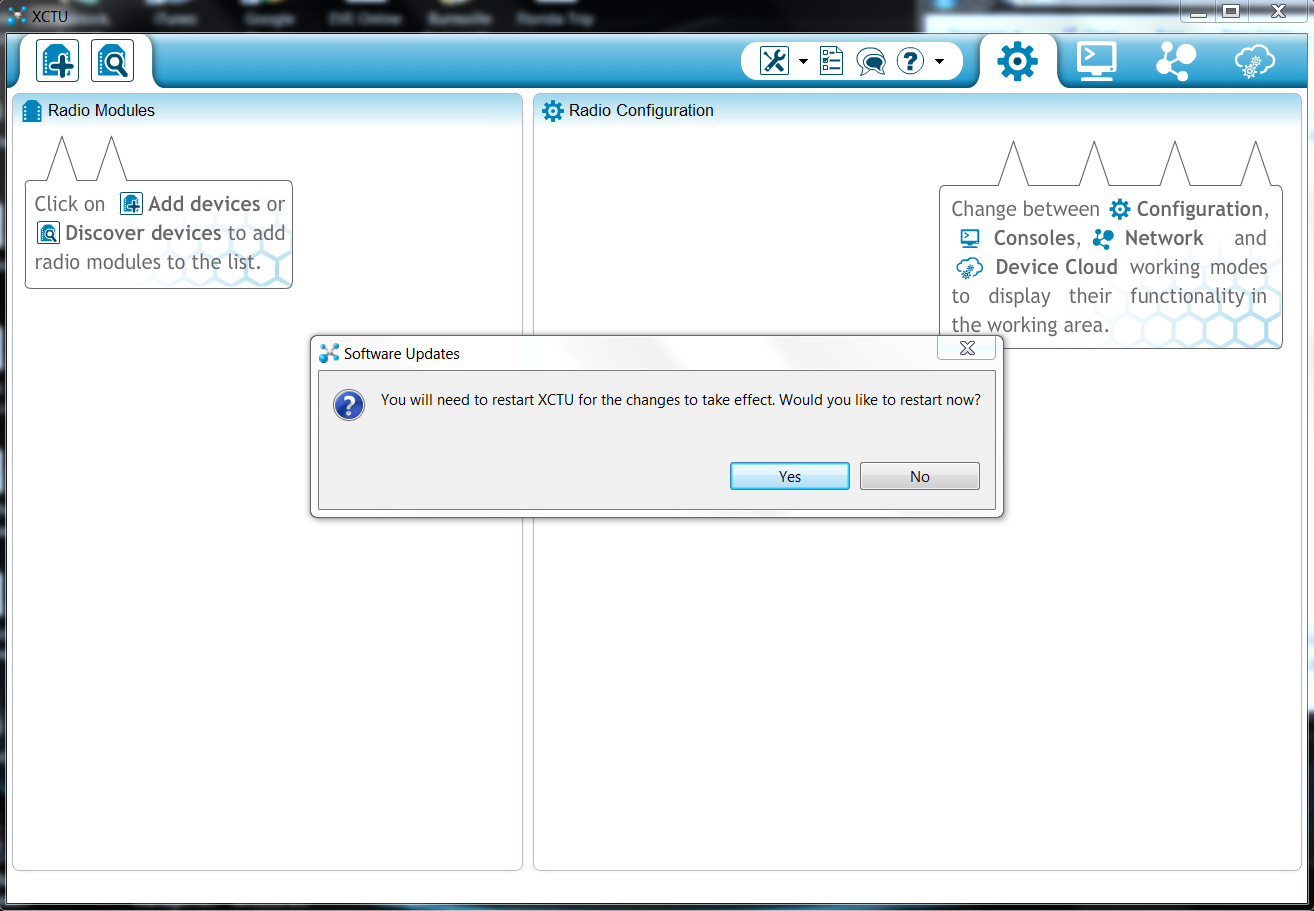
Design/Communication Software/Instruction Resource Files/XCTU Update Step 5.PNG
