Logiant/AgileRoboticControls/System Modelling/Mechanical/Agile Controls Simulation/Sim Results.xlsx

 | Swing 1 | Swing 2 | Impulse | Drag 1 | Drag 2 | s1 | s2 | d1 | d2
FK1x | -900.8699932 | 877.9429507 | -457.9893 | 61.69691272 | 70.56740398 | 1488.611229 | 2250.375345 | 196.5109895 | 173.6434812
FH1x | -879.5344185 | 744.2811152 | -876.5922 | 113.1840679 | 102.3710977 | 1394.983661 | 2275.581322 | 277.8228326 | 255.3056144
FK2x | 0 | 0 | 0 | -17.25 | -17.25 | 42.3703 | 42.3703 | 48.1203 | 48.1203
FH2x | 0 | 0 | 0 | -17.25 | -17.25 | 38.152 | 38.152 | 43.902 | 43.902
FK3x | 0 | 0 | 0 | -17.25 | -17.25 | 42.3703 | 42.3703 | 48.1203 | 48.1203
FH3x | 0 | 0 | 0 | -17.25 | -17.25 | 38.152 | 38.152 | 43.902 | 43.902
FK4x | 0 | 0 | 0 | -17.25 | -17.25 | 42.3703 | 42.3703 | 48.1203 | 48.1203
FH4x | 0 | 0 | 0 | -17.25 | -17.25 | 38.152 | 38.152 | 43.902 | 43.902
FK1y | -587.741236 | 1372.432395 | -306.9781 | -134.8140768 | 103.0760772 | 3125.16179 | 4767.523567 | 750.4007221 | 705.0159955
FH1y | -515.4492425 | 1531.300207 | -213.3509 | -164.6387646 | 152.9345167
FK2y | -42.3703 | -42.3703 | -42.3703 | -30.8703 | -30.8703
FH2y | -38.152 | -38.152 | -38.152 | -26.652 | -26.652
FK3y | -42.3703 | -42.3703 | -42.3703 | -30.8703 | -30.8703
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
