Logiant/AgileRoboticControls/Documentation/TODO List Spring.xlsx

Task | Taskee | Definition of Finished
Design Tasks
Design control system | Logan, Tyler | Get feedback servo to follow an input
Fix Xbee bug | Logan, Tyler | Receive requests on device wirelessly to control feedback servo
Come up with initial GUI ideas | Logan, Tyler | Initial GUI designs for final project
Design Knee and Hip joint | Ron, Justin | Decide on knee and hip joints
Pneumatic design | Logan | Approximate number of connections required, reciever tank size
Construction Tasks
Order chassis components | Ron, Justin | 80 20 aluminum components ordered for chassis
Order electrical components | Tyler | Order electrical components for signal conditioning
Machine shop certification | Ron, Justin | Get certified for MSOE's machine shop
Order leg components | Ron, Justin | Order aluminum stock for legs
Order air compressor | Ron | Air compressor ordered
Call Bimba/Numatics |  | Get component lead time and feedback on design specs
Report Tasks
Add total to bill of materials
Update table of contents
Add/update introduction
Update sections
Add intro to environmental report
Other Tasks
Email JoyGlobal about tour, judges, and presentation | Logan | Email JoyGlobal about tour and presentation
Email Dr. Mahinfalah about workspace/storage | Logan | Email Dr. Mahinfalah about workspace/storage
