Logiant/AgileRoboticControls/Documentation/TODO List Winter.xlsx

Sheet: 1-9-15 to 1-16-15
Task | Taskee | Definition of Finished
Design Tasks
Scan the feedback from presentation | Team | Project Presentation feedback on Git
Verify dynamic equations | Justin | Problems found or no?
Debug Panel | Tyler | Start design of debug panel
Communication System | Tyler | Constructed Communication System
Pick foot rubber | Ron | Foot selected
Design foot | Ron | Foot Designed
Research Tasks
Compressors | Tyler | Common compressors with pressures, cost, ect…
Cylinders | Tyler | Cost, Stroke Length, Bore size
Dynamic Model | Logan | Updates completed

Sheet: 12-18-14 to 1-8-15
Task | Taskee | Definition of Finished
Design Tasks
Finish deriving equations and simulation | Logan, Tyler | Finish developing state-based model and integrate it with the simulation
Update chassis | Justin, ron
Leg Design | Ron, Justin | Cool new leg design
Develop robot control mechanism | Tyler | A microcontroller running matlab can be controlled by a laptop wirelessly
Put masses and moments of inertia in excel spreadhseet | Justin | Input required masses and intertias into an excel file
Materials science research | Ron | List of lightweight and cheap sheet materials that can be used for component mounting inside chassis
Start presentation powerpoint | Everyone | Individual sections finished per person, 3 minutes max per section
Report Tasks
Whatever Dr Rodriguez says | The truth
Ask Milwaukee tool about batteries? | Somebody? | Ask Dr. Rodriguez what he think
Styrofoam model? | Please?

Sheet: 12-12-14 to 12-19-14
Task | Taskee | Definition of Finished
Design Tasks
Derive 27 equations | Logan, Tyler, Ron, Justin | Agreeing equations for robot motion
Estimate component masses | Justin | Rough estimate of component weights
Shoulder joint design | Ron, Logan | Rough design of shoulder joints
Stress test the microcontroller | Tyler | Test microcontroller for PID and model simulation speeds
Look into master slave architecture | Tyler | Research master-slave architecture with multiple microcontrollers
Finish updating body model and estimate chassis mass | Justin | Updated model in SolidWorks with chassis mass estimate
3-4 vs 2-4 valve design | Justin | Review benefits and drawbacks of 3-4 valve versus over-lapped 2-4 valve
Report Tasks
Motherboard/Electrical Diagram | Tyler | Clean up electrical section and add full wiring diagram
Conclusion/Winter work | Ron Ron | Add a conclusion section to the report
Define gamma | Justin | Gamma defined in the report for the accumulator tank
 |  | It's the adiabatic index
$$$ Tasks
Look into JCI batteries | Tyler | Batteries talk!
