Logiant/AgileRoboticControls/Documentation/TODO List Fall.xlsx

Sheet: 12-12-14 to 12-19-14
Task | Taskee | Definition of Finished
Design Tasks
Derive 27 equations
Estimate component masses
Shoulder joint design
Stress test the microcontroller
Look into master slave architecture
Report Tasks
Background Section | Justin | Updates to background info, Kevin Lee moved
Pedagogical Research | Logan | Updates to pedagogical research
Motherboard/Electrical Diagram | Tyler | Clean up electrical section and add full wiring diagram

Sheet: 12-3-14 to 12-12-14
Task | Taskee | Definition of Finished
Design Tasks
Motherboard and Electrical Component Design/Specs | Tyler | Electrical components sized and relative positions mapped out
Signal scaling and amplifying | Tyler | Initial components known and placed for signal conditioning
Op Amp Design | Tyler | Determine style of Op Amp and number of amplification voltages
Shoulder Design | Ron | 2 Shoulder designs completed
Leg Design | Ron | 2 Leg designs completed
Leg Motion Study Animation | Logan | Animation has realistic gait and determines min/max values
Update SolidWorks Model of Robot | Justin | Robot updated with T-slotted aluminum chassis
Lightweight materials research | Justin | List of potential leg materials/weights
Report Tasks
Background Section | Justin | Updates to background info, Kevin Lee moved
Pedagogical Research | Logan | Updates to pedagogical research
Motherboard/Electrical Diagram | Tyler | Clean up electrical section and add full wiring diagram
Update pneumait diagram | Logan | Pneumatic diagram does not have an accumulation tank

Sheet: 11-6-14 to 11-13-14
Project Management Tasks
Task | People | Definition of Finished
Get Dr Rodriguez's Signature on $$$ request form | Tyler | Form filled out for MSOE to request money
Memo created for Dr. Rodriguez | Ronaldo | Give memo to Dr. Rodriguez 10/31
Design Taks
Task | People | Definition of Finished
Update robot design in solidworks and rate them | Justin, Ron, Logan | Design and ratings are on SVN
Rodriguez Tasks
Task | People | Definition of Finished
Electrical report work | Tyler | Electronic feasability updated from feedback
Proposed Gaits | Logan | Different feasable gaits and gait shapes
Update background section | Team | Background section updated based on feedback
Update Gantt chart with mechanical stuff | Logan/Justin/Ron | Leg construction, chassis construction, pneumatic circuit development
Example Pneumatic circuit in report | Logan | Example pneumatic circuit in report
Number of legs discussion in background | Ron | Discussion of 4 legged choice in report
Feasability/example of other robots | Justin | Examples of existing robots in report
Start design choice section, pictures and pros/cons | Team | Initial robots included in report with a description and pros/cons
Email draft to Rodriguez on Wednesday, 11/12

Sheet: 11-13-14 to 11-20-14
Project Management Tasks
Task | People | Definition of Finished
Memo for Week 10 | Tyler | Memo sent
Design Taks
Task | People | Definition of Finished
Rodriguez Tasks
Task | People | Definition of Finished
Send draft report on Thursday end of meeting | Logan | Email sent, team cc'd on email
Review Before Rodriguez Feedback | Team | Review completed
Review After Rodriguez Feedback | Team | Review Completed
Set up Google Document | Tyler | Google Doc up until end of reviewing

Sheet: 10-30-14 to 11-6-14
Research Tasks |  | Max Score
Task | People | Definition of Finished
Project Management Tasks
Task | People | Definition of Finished
Fill out form to request money for project | Tyler | Form filled out for MSOE to request money
Memo created for Dr. Rodriguez | Logan | Give memo to Dr. Rodriguez 10/31
Finalize design matrices | Logan, Justin, Ron | Design matrix finished
Upload solidworks model of components to SVN | Logan | Solidworks model for pneumatic bay, debug board, microcontroller uploaded
Simulation and Software Tasks
Task | People | Definition of Finished
Update leg simulation | Logan | Simulation completed to determine maximum velocity/pressure of leg configurations
Design Taks
Task | People | Definition of Finished
Update robot design in solidworks | Justin, Ron, Logan | Submit design on SVN for discussion next week team meeting
Draft of debug panel | Tyler | Draft of debug panel design
Rodriguez Tasks
Task | People | Definition of Finished
Feasability of electronic components | Tyler | Electronic feasability in report
Proposed Gaits | Logan | Different feasable gaits and gait shapes
Microcontroller recommendation put in document | Tyler | In document
Background Section Completed | Ron | Legs benefits/drawbacks, stability, pneumatic/electrical components, constraints/objectives updated, reference to kevin's stuff
Update Gantt chart with mechanical stuff | Logan/Justin/Ron | Gannt chart has mechanical stuff

Sheet: 10-23-14 to 10-30-14
Research Tasks
Task | People | Definition of Finished
Project Management Tasks
Task | People | Definition of Finished
Fill out form to request money for project | Logan | Form filled out for MSOE to request money
Memo created for Dr. Rodriguez | Tyler
Letter from MSOE to JCI | Tyler | Letter requirements known and requested
Initial draft of design matrices created | Logan, Justin, Ron | Initial design matrix drafted
Simulation and Software Tasks
Task | People | Definition of Finished
MATLAB model updates and library | Logan, Tyler | Updates and Library made
Mini piston simulation | Logan | Compartmenatlized simple piston model with pressure/mass
Design Taks
Task | People | Definition of Finished
Create a general robot design in solidworks | Team | Submit design on SVN for discussion next week team meeting
Rodriguez Tasks
Task | People | Definition of Finished
Feasability of electronic components | Tyler | Neccesary signals and comminucation to control pneumatic components
Drawings and Models of Robot Components | Team | Image and File Uploaded
Proposed Gaits | Logan | Different feasable gaits and gait shapes
Microcontroller recommendation put in document | Tyler | In document
Background Section Completed | Ron | Legs benefits/drawbacks, stability, pneumatic/electrical components, constraints/objectives updated, reference to kevin's stuff
Add table of contents/headers and page numbers to report | Justin | Report has nice headings, table of contents, and page numbers
Update Gantt chart with mechanical stuff | Logan/Justin/Ron | Gannt chart has mechanical stuff
Gannt chart rotated so it can be read | Tyler | Rotate the chart so we can actually read it

Sheet: 10-16-14 to 10-23-14
Research Tasks
Task | People | Definition of Finished
Synthesize three initial design ideas (legs or chassis) | Team | Sketched/Drawn leg configurations and chassis (one of each)
Compile simulink model to C code | Tyler | Compile a simulink model into C code, or figure out its impossible
Project Management Tasks
Task | People | Definition of Finished
Create memo for Dr. Rodriguez | Tyler | Memo given to Dr. Rodriguez at next meeting
Email Joy Global | Logan | Joy Global emailed
Letter from MSOE to JCI | Tyler | Letter requirements known and requested
Add specificaion for protecting the electronic comps. | Tyler | Specification added to specs list
Initial draft of design matrices created | Team | Initial design matrix drafted
Work on design proposal report | Teams | Tasks below are completed
Feasability of electronic components | Tyler | Neccesary signals and comminucation to control pneumatic components
Pneumatic benefits | Justin | Benefits of pneumatics for this project
Specification and objective defense | Ron | Why we chose each specification, find the weak reasons
Proposed Gaits | Logan | Different feasable gaits and gait shapes
Microcontroller recommendation | Tyler | List suggested microcontrollers and why
Upload MATLAB code | Logan
Rodriguez Tasks
Task | People | Definition of Finished
Deliver Draft of Project Design report to Rodriguez |  | Draft emailed by Tuesday

Sheet: 10-9-14 to 10-16-14
Research Tasks
Task | People | Definition of Finished
Feasability Study/Patents | Team | Justify objectives/constraints of the project
Research pneumatic circuit components | Logan/Tyler | Pneumatic circuit components understood
Different Project Designs | Team | Sketched Designs with Descriptions
Project Management Tasks
Task | People | Definition of Finished
Look at research | Team | Everyone skim the research on the SVN
Create memo for Dr. Rodriguez | Ron | Memo given to Dr. Rodriguez at next meeting
Start compiling report background info | Team | Put relevant research items to the report in the Report folder
Update Gantt chart with remaining deadlines | Tyler | Gantt chart updated with deliverable deadlines
Discuss project with plexus Monday, 10/13 at 10:40 | Team | Dress nicely, get money!
Begin report drafting | Team
Finish/turn in project plan | Team | Give project plan to mahinfalah
Pneumatic vs. motor vs. other decision matrix | Team | Matrix drafted and enumerated
Design matrix drafted | Team | Different designs entered into matrix and ranked
Rodriguez Tasks
Task | People | Definition of Finished

Sheet: 10-2-14 to 10-9-14
Research Tasks
Task | People | Definition of Finished
Feasability Study/Patents | Team | Justify objectives/constraints of the project
Communication Protocol research | Tyler | research documents on communication protocols on SVN
Create variable leg model in MATLAB | Logan | Initial kinematic model of a leg
Microcontroller proposal | Tyler | List of top 3-5 microcontrollers reccomended brought to meeting on 10/9/14
Research pneumatic circuit components | Team
Project Management Tasks
Task | People | Definition of Finished
Look at research | Team | Everyone skim the research on the SVN
Create memo for Dr. Rodriguez | Justin | Memo given to Dr. Rodriguez at next meeting
Start compiling report background info | Team | Put relevant research items to the report in the Report folder
Update Gantt chart with remaining deadlines | Tyler | Gantt chart updated with deliverable deadlines
Prepeare initial presentation for Plexus | Ron/Justin | Initial disussion topics prepared for the interview
Review homogenious transformations | Team | Everyone has read the handout from Dr. Rodriguez
Begin report drafting | Team
Rodriguez Tasks
Task | People | Definition of Finished
Draw a circle in MATLAB using a 2 link arm | Team | Everyone has a 2 link arm that draws in a cricle

Sheet: 9-25-14 to 10-2-14
Research Tasks
Task | People | Definition of Finished
Review parts list | Justin | More detailed parts list acquired
Finish xBox controller MATLAB interface | Tyler | xBox controller interfaced with matlab
Feasability Study | Team | Justify objectives/constraints of the project
Project Management Tasks
Task | People | Definition of Finished
Look at research | Team | Everyone skim the research on the SVN
Kickstarter | Tyler | Start a kickstarter this week
Email Plexus | Tyler | Email sent to plexus and CC'd to team/advisor
Submit constraints | Logan | Constraints/Objectives submitted to mahinfalah
Create memo for Dr. Rodriguez | Logan | Memo given to Dr. Rodriguez at next meeting
Start compiling report information and outline | Team | Put relevant research items to the report in the Report folder
Budget Tasks
Task | People | Definition of Finished
Brainstorm more funding options | Team | More funding options, we need money
Refine robot constraints | Team | Constraint document given to Dr Mahinfalah

Sheet: 9-18-14 to 9-25-14
Research Tasks
Task | People | Definition of Finished
Microcontroller/pneumatic control hardware | Tyler | Two research documents on microcontrollers/pneumatic control hardaware, as well as a hardware recomendation
Robotic Gaits | Logan | Research delivered about robotic gaits
Research interfacing microcontrollers with MATLAB | Ron | List of compatible microcontrollers with MATlab
Research on setting up pneumatic circuits | Justin | Example circuit uploaded to SVN
Project Management Tasks
Task | People | Definition of Finished
Memo for Dr Rodriguez | Logan | Memo written for Dr Rodriguez tomorrow
Syntesize constraints | Team | Each team member has 1-2 constraints/objectives - Team meeting Friday 9/18 5pm
Look at research | Team | Everyone at least skim the research in the SVN
Budget Tasks
Task | People | Definition of Finished
Brainstorm more funding options | Team | More funding options, we need money

Sheet: 9-12-14 to 9-18-14
Research Tasks
Task | People | Definition of Finished
Initial Objectives/Constraints research | Ron | Initial list of objectives/constraints with at least one source
Pneumatic Benefits | Justin | At least two PDF/word documents of papers related to the benefits of pneumatics over hydraulics/electronics
Locomotion | Logan | At least two PDF/word documents of papers related to the dynamic modelling of walking robots
Stability / Number of Legs | Tyler | At least two PDF/word documents of papers related to the tradeoff of the number of legs on a walking robot
Project Management Tasks
Task | People | Definition of Finished
Setup SVN | Tyler | Able to access SVN server remotely
Come up with rules | Team | List of rules exists
Acquire Team Binder | Logan | Have Team Binder
Synthesize Problem Statement | Team | Have a problem statement
Gannt Chart Template | Tyler | Gannt Chart Template and timeline in SVN
Make Weekly Update Template | Logan | Word template of memo exists, memo given to Mahinfalah Tuesday of week 2
Summary of research findings | Team | Present summary at next meeting
Make initial TODO list | Team | TODO list created and filled with week 1 tasks
Install Tortise SVN | Team | Tortise SVN installed on team laptops
Budget Tasks
Task | People | Definition of Finished
Come up with ways to fund project | Team | Everyone has one idea on how to get money | JoyGlobal, Johnson Controls, MSOE, Kickstarter
