Logiant/AgileRoboticControls/Orders/Digikey Order.pdf

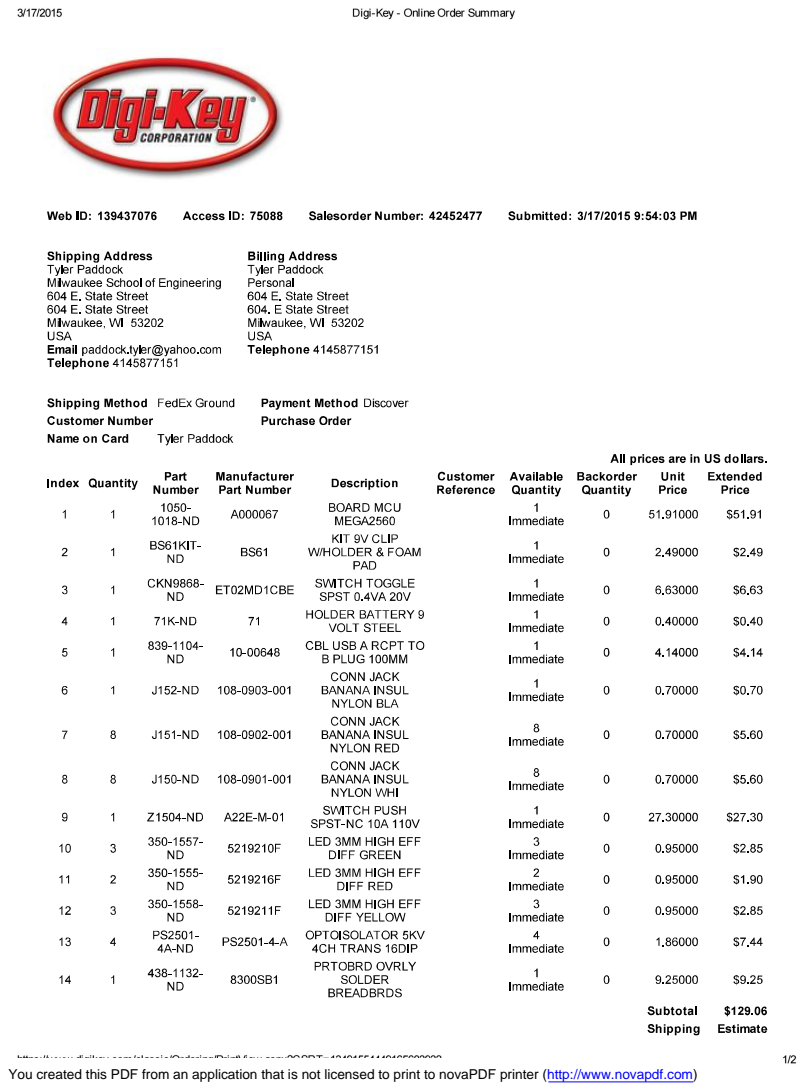
[picture p218: page 1]

You created this PDF from an application that is not licensed to print to novaPDF printer (http://www.novapdf.com)

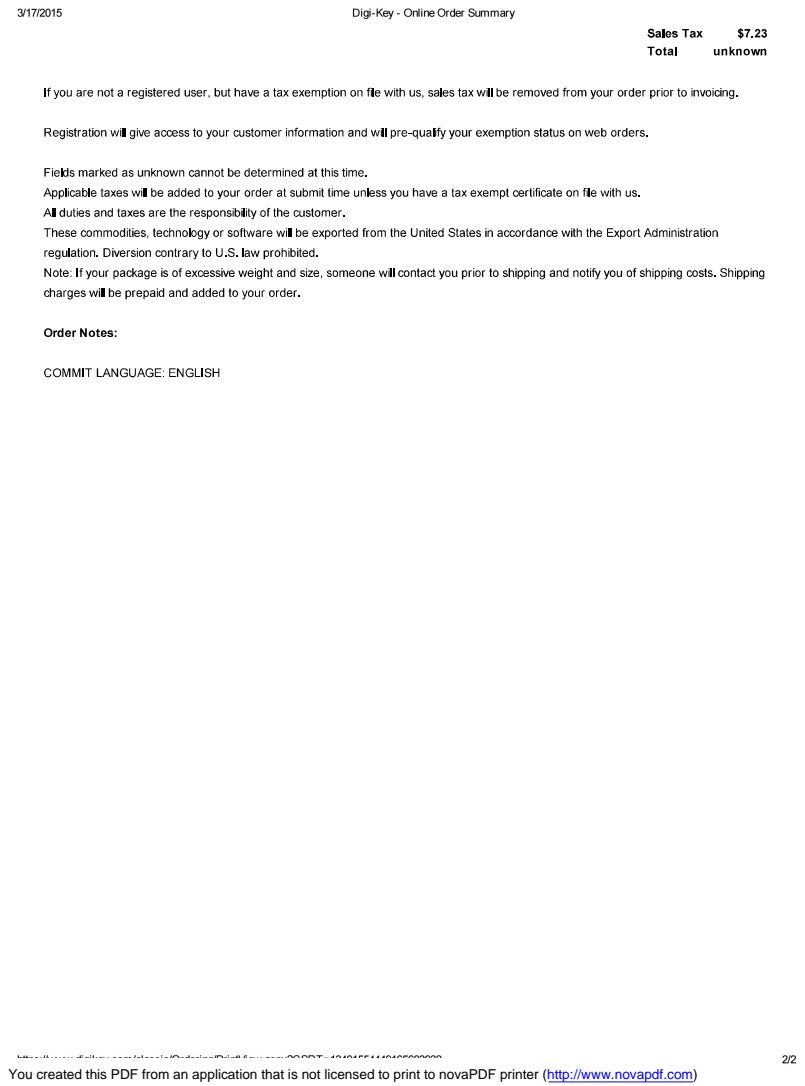
[picture p219: page 2]
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
