Logiant/AgileRoboticControls/(list of files, drawings)

Other design files:
System Modelling/Electrical/Amplifier/Amplifier.ms13
System Modelling/Electrical/LPF/LPF.ms13
System Modelling/Electrical/LPF/LPF_Standard Caps.ms13
System Modelling/Electrical/Smaller Battery Level Indicator/Did Not Work/Smaller Battery Level Indicator.ms13
System Modelling/Electrical/Smaller Battery Level Indicator/New Circuit/9VoltBatteryLevelIndicator.ms13
