Logiant/AgileRoboticControls/System Modelling/Control/Simulink Code/Cylinder Tests/ArduinoFeedbackTest_rtt/ArduinoFeedbackTest.h

/*
 * File: ArduinoFeedbackTest.h
 *
 * Code generated for Simulink model 'ArduinoFeedbackTest'.
 *
 * Model version                  : 1.15
 * Simulink Coder version         : 8.6 (R2014a) 27-Dec-2013
 * TLC version                    : 8.6 (Jan 30 2014)
 * C/C++ source code generated on : Mon Mar 16 16:55:36 2015
 *
 * Target selection: realtime.tlc
 * Embedded hardware selection: Atmel->AVR
 * Code generation objectives: Unspecified
 * Validation result: Not run
 */

#ifndef RTW_HEADER_ArduinoFeedbackTest_h_
#define RTW_HEADER_ArduinoFeedbackTest_h_
#include <math.h>
#include <string.h>
#include <stddef.h>
#ifndef ArduinoFeedbackTest_COMMON_INCLUDES_
# define ArduinoFeedbackTest_COMMON_INCLUDES_
#include "rtwtypes.h"
#include "rtw_continuous.h"
#include "rtw_solver.h"
#include "arduino_analoginput_lct.h"
#include "arduino_analogoutput_lct.h"
#endif                                 /* ArduinoFeedbackTest_COMMON_INCLUDES_ */

#include "ArduinoFeedbackTest_types.h"

/* Macros for accessing real-time model data structure */
#ifndef rtmGetErrorStatus
# define rtmGetErrorStatus(rtm)        ((rtm)->errorStatus)
#endif

#ifndef rtmSetErrorStatus
# define rtmSetErrorStatus(rtm, val)   ((rtm)->errorStatus = (val))
#endif

#ifndef rtmGetStopRequested
# define rtmGetStopRequested(rtm)      ((rtm)->Timing.stopRequestedFlag)
#endif

#ifndef rtmSetStopRequested
# define rtmSetStopRequested(rtm, val) ((rtm)->Timing.stopRequestedFlag = (val))
#endif

#ifndef rtmGetStopRequestedPtr
# define rtmGetStopRequestedPtr(rtm)   (&((rtm)->Timing.stopRequestedFlag))
#endif

#ifndef rtmGetT
# define rtmGetT(rtm)                  (rtmGetTPtr((rtm))[0])
#endif

/* Block signals (auto storage) */
typedef struct {
  real_T ProportionalGain;             /* '<S1>/Proportional Gain' */
  real_T DerivativeGain;               /* '<S1>/Derivative Gain' */
  real_T FilterCoefficient;            /* '<S1>/Filter Coefficient' */
  real_T IntegralGain;                 /* '<S1>/Integral Gain' */
  uint8_T DataTypeConversion;          /* '<S2>/Data Type Conversion' */
} B_ArduinoFeedbackTest_T;

/* Continuous states (auto storage) */
typedef struct {
  real_T Integrator_CSTATE;            /* '<S1>/Integrator' */
  real_T Filter_CSTATE;                /* '<S1>/Filter' */
} X_ArduinoFeedbackTest_T;

/* State derivatives (auto storage) */
typedef struct {
  real_T Integrator_CSTATE;            /* '<S1>/Integrator' */
  real_T Filter_CSTATE;                /* '<S1>/Filter' */
} XDot_ArduinoFeedbackTest_T;

/* State disabled  */
typedef struct {
  boolean_T Integrator_CSTATE;         /* '<S1>/Integrator' */
  boolean_T Filter_CSTATE;             /* '<S1>/Filter' */
} XDis_ArduinoFeedbackTest_T;

#ifndef ODE3_INTG
#define ODE3_INTG

/* ODE3 Integration Data */
typedef struct {
  real_T *y;                           /* output */
  real_T *f[3];                        /* derivatives */
} ODE3_IntgData;

#endif

/* Parameters (auto storage) */
struct P_ArduinoFeedbackTest_T_ {
  real_T PIDController_D;              /* Mask Parameter: PIDController_D
                                        * Referenced by: '<S1>/Derivative Gain'
                                        */
  real_T PIDController_I;              /* Mask Parameter: PIDController_I
                                        * Referenced by: '<S1>/Integral Gain'
                                        */
  real_T PIDController_N;              /* Mask Parameter: PIDController_N
                                        * Referenced by: '<S1>/Filter Coefficient'
                                        */
  real_T PIDController_P;              /* Mask Parameter: PIDController_P
                                        * Referenced by: '<S1>/Proportional Gain'
                                        */
  uint32_T PWM_pinNumber;              /* Mask Parameter: PWM_pinNumber
                                        * Referenced by: '<S2>/PWM'
                                        */
  real_T SineWave_Amp;                 /* Expression: 0.3
                                        * Referenced by: '<Root>/Sine Wave'
                                        */
  real_T SineWave_Bias;                /* Expression: 0.5
                                        * Referenced by: '<Root>/Sine Wave'
                                        */
  real_T SineWave_Freq;                /* Expression: 1
                                        * Referenced by: '<Root>/Sine Wave'
                                        */
  real_T SineWave_Phase;               /* Expression: 0
                                        * Referenced by: '<Root>/Sine Wave'
                                        */
  real_T DesiredPercentMaxPosition_Value;/* Expression: .6
                                          * Referenced by: '<Root>/Desired Percent Max Position'
                                          */
  real_T ScaletoMaxInput_Gain;         /* Expression: 1023
                                        * Referenced by: '<Root>/Scale to Max Input'
                                        */
  real_T Gain_Gain;                    /* Expression: 1/4
                                        * Referenced by: '<Root>/Gain'
                                        */
  real_T Integrator_IC;                /* Expression: InitialConditionForIntegrator
                                        * Referenced by: '<S1>/Integrator'
                                        */
  real_T Filter_IC;                    /* Expression: InitialConditionForFilter
                                        * Referenced by: '<S1>/Filter'
                                        */
  uint32_T AnalogInput_p1;             /* Computed Parameter: AnalogInput_p1
                                        * Referenced by: '<Root>/Analog Input'
                                        */
  uint8_T ManualSwitch_CurrentSetting; /* Computed Parameter: ManualSwitch_CurrentSetting
                                        * Referenced by: '<Root>/Manual Switch'
                                        */
};

/* Real-time Model Data Structure */
struct tag_RTM_ArduinoFeedbackTest_T {
  const char_T *errorStatus;
  RTWSolverInfo solverInfo;

  /*
   * ModelData:
   * The following substructure contains information regarding
   * the data used in the model.
   */
  struct {
    X_ArduinoFeedbackTest_T *contStates;
    real_T *derivs;
    boolean_T *contStateDisabled;
    boolean_T zCCacheNeedsReset;
    boolean_T derivCacheNeedsReset;
    boolean_T blkStateChange;
    real_T odeY[2];
    real_T odeF[3][2];
    ODE3_IntgData intgData;
  } ModelData;

  /*
   * Sizes:
   * The following substructure contains sizes information
   * for many of the model attributes such as inputs, outputs,
   * dwork, sample times, etc.
   */
  struct {
    int_T numContStates;
    int_T numSampTimes;
  } Sizes;

  /*
   * Timing:
   * The following substructure contains information regarding
   * the timing information for the model.
   */
  struct {
    uint32_T clockTick0;
    time_T stepSize0;
    uint32_T clockTick1;
    SimTimeStep simTimeStep;
    boolean_T stopRequestedFlag;
    time_T *t;
    time_T tArray[2];
  } Timing;
};

/* Block parameters (auto storage) */
extern P_ArduinoFeedbackTest_T ArduinoFeedbackTest_P;

/* Block signals (auto storage) */
extern B_ArduinoFeedbackTest_T ArduinoFeedbackTest_B;

/* Continuous states (auto storage) */
extern X_ArduinoFeedbackTest_T ArduinoFeedbackTest_X;

/* Model entry point functions */
extern void ArduinoFeedbackTest_initialize(void);
extern void ArduinoFeedbackTest_output(void);
extern void ArduinoFeedbackTest_update(void);
extern void ArduinoFeedbackTest_terminate(void);

/* Real-time Model object */
extern RT_MODEL_ArduinoFeedbackTest_T *const ArduinoFeedbackTest_M;

/*-
 * The generated code includes comments that allow you to trace directly
 * back to the appropriate location in the model.  The basic format
 * is <system>/block_name, where system is the system number (uniquely
 * assigned by Simulink) and block_name is the name of the block.
 *
 * Use the MATLAB hilite_system command to trace the generated code back
 * to the model.  For example,
 *
 * hilite_system('<S3>')    - opens system 3
 * hilite_system('<S3>/Kp') - opens and selects block Kp which resides in S3
 *
 * Here is the system hierarchy for this model
 *
 * '<Root>' : 'ArduinoFeedbackTest'
 * '<S1>'   : 'ArduinoFeedbackTest/PID Controller'
 * '<S2>'   : 'ArduinoFeedbackTest/PWM'
 */
#endif                                 /* RTW_HEADER_ArduinoFeedbackTest_h_ */

/*
 * File trailer for generated code.
 *
 * [EOF]
 */
