Logiant/AgileRoboticControls/System Modelling/Control/Simulink Code/Cylinder Tests/Hardware Test/SingleCylinderTest_grt_rtw/multiword_types.h

/*
 * multiword_types.h
 *
 * Code generation for model "SingleCylinderTest".
 *
 * Model version              : 1.68
 * Simulink Coder version : 8.6 (R2014a) 27-Dec-2013
 * C source code generated on : Thu Apr 16 22:12:23 2015
 *
 * Target selection: grt.tlc
 * Note: GRT includes extra infrastructure and instrumentation for prototyping
 * Embedded hardware selection: 32-bit Generic
 * Code generation objectives: Unspecified
 * Validation result: Not run
 */

#ifndef __MULTIWORD_TYPES_H__
#define __MULTIWORD_TYPES_H__
#include "rtwtypes.h"

/*
 * Definitions supporting external data access
 */
typedef int32_T chunk_T;
typedef uint32_T uchunk_T;

/*
 * MultiWord supporting definitions
 */
typedef long int long_T;

/*
 * MultiWord types
 */
typedef struct {
  uint32_T chunks[2];
} int64m_T;

typedef struct {
  int64m_T re;
  int64m_T im;
} cint64m_T;

typedef struct {
  uint32_T chunks[2];
} uint64m_T;

typedef struct {
  uint64m_T re;
  uint64m_T im;
} cuint64m_T;

typedef struct {
  uint32_T chunks[3];
} int96m_T;

typedef struct {
  int96m_T re;
  int96m_T im;
} cint96m_T;

typedef struct {
  uint32_T chunks[3];
} uint96m_T;

typedef struct {
  uint96m_T re;
  uint96m_T im;
} cuint96m_T;

typedef struct {
  uint32_T chunks[4];
} int128m_T;

typedef struct {
  int128m_T re;
  int128m_T im;
} cint128m_T;

typedef struct {
  uint32_T chunks[4];
} uint128m_T;

typedef struct {
  uint128m_T re;
  uint128m_T im;
} cuint128m_T;

typedef struct {
  uint32_T chunks[5];
} int160m_T;

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
  uint32_T chunks[64];
} int2048m_T;

typedef struct {
  int2048m_T re;
  int2048m_T im;
} cint2048m_T;

typedef struct {
  uint32_T chunks[64];
} uint2048m_T;

typedef struct {
  uint2048m_T re;
  uint2048m_T im;
} cuint2048m_T;

#endif                                 /* __MULTIWORD_TYPES_H__ */
