Logiant/AgileRoboticControls/System Modelling/Control/Simulink Code/Cylinder Tests/Hardware Test/SingleCylinderTest_grt_rtw/SingleCylinderTest_private.h

/*
 * SingleCylinderTest_private.h
 *
 * Code generation for model "SingleCylinderTest".
 *
 * Model version              : 1.68
 * Simulink Coder version : 8.6 (R2014a) 27-Dec-2013
 * C source code generated on : Thu Apr 16 22:12:23 2015
 *
 * Target selection: grt.tlc
 * Note: GRT includes extra infrastructure and instrumentation for prototyping
 * Embedded hardware selection: 32-bit Generic
 * Code generation objectives: Unspecified
 * Validation result: Not run
 */
#ifndef RTW_HEADER_SingleCylinderTest_private_h_
#define RTW_HEADER_SingleCylinderTest_private_h_
#include "rtwtypes.h"
#include "builtin_typeid_types.h"
#include "multiword_types.h"

/* Private macros used by the generated code to access rtModel */
#ifndef rtmSetTFinal
# define rtmSetTFinal(rtm, val)        ((rtm)->Timing.tFinal = (val))
#endif

#ifndef rtmGetTPtr
# define rtmGetTPtr(rtm)               (&(rtm)->Timing.taskTime0)
#endif

#ifndef UCHAR_MAX
#include <limits.h>
#endif

#if ( UCHAR_MAX != (0xFFU) ) || ( SCHAR_MAX != (0x7F) )
#error "Code was generated for compiler with different sized uchar/char. Consider adjusting Emulation Hardware word size settings on the Hardware Implementation pane to match your compiler word sizes as defined in the compiler's limits.h header file. Alternatively, you can select 'None' for Emulation Hardware and select the 'Enable portable word sizes' option for ERT based targets, which will disable the preprocessor word size checks."
#endif

#if ( USHRT_MAX != (0xFFFFU) ) || ( SHRT_MAX != (0x7FFF) )
#error "Code was generated for compiler with different sized ushort/short. Consider adjusting Emulation Hardware word size settings on the Hardware Implementation pane to match your compiler word sizes as defined in the compilers limits.h header file. Alternatively, you can select 'None' for Emulation Hardware and select the 'Enable portable word sizes' option for ERT based targets, this will disable the preprocessor word size checks."
#endif

#if ( UINT_MAX != (0xFFFFFFFFU) ) || ( INT_MAX != (0x7FFFFFFF) )
#error "Code was generated for compiler with different sized uint/int. Consider adjusting Emulation Hardware word size settings on the Hardware Implementation pane to match your compiler word sizes as defined in the compilers limits.h header file. Alternatively, you can select 'None' for Emulation Hardware and select the 'Enable portable word sizes' option for ERT based targets, this will disable the preprocessor word size checks."
#endif

#if ( ULONG_MAX != (0xFFFFFFFFU) ) || ( LONG_MAX != (0x7FFFFFFF) )
#error "Code was generated for compiler with different sized ulong/long. Consider adjusting Emulation Hardware word size settings on the Hardware Implementation pane to match your compiler word sizes as defined in the compilers limits.h header file. Alternatively, you can select 'None' for Emulation Hardware and select the 'Enable portable word sizes' option for ERT based targets, this will disable the preprocessor word size checks."
#endif

#ifndef __RTWTYPES_H__
#error This file requires rtwtypes.h to be included
#endif                                 /* __RTWTYPES_H__ */
#endif                                 /* RTW_HEADER_SingleCylinderTest_private_h_ */
