Logiant/AgileRoboticControls/System Modelling/Control/Simulink Code/FrequencyResponseTest_rtt/FrequencyResponseTest_data.c

/*
 * File: FrequencyResponseTest_data.c
 *
 * Code generated for Simulink model 'FrequencyResponseTest'.
 *
 * Model version                  : 1.15
 * Simulink Coder version         : 8.6 (R2014a) 27-Dec-2013
 * TLC version                    : 8.6 (Jan 30 2014)
 * C/C++ source code generated on : Wed Apr 29 20:13:30 2015
 *
 * Target selection: realtime.tlc
 * Embedded hardware selection: Atmel->AVR
 * Code generation objectives: Unspecified
 * Validation result: Not run
 */

#include "FrequencyResponseTest.h"
#include "FrequencyResponseTest_private.h"

/* Block parameters (auto storage) */
P_FrequencyResponseTest_T FrequencyResponseTest_P = {
  5U,                                  /* Mask Parameter: PWM_pinNumber
                                        * Referenced by: '<S1>/PWM'
                                        */
  9U,                                  /* Mask Parameter: PWM_pinNumber_b
                                        * Referenced by: '<S2>/PWM'
                                        */
  7U,                                  /* Mask Parameter: PWM_pinNumber_j
                                        * Referenced by: '<S3>/PWM'
                                        */
  1.0,                                 /* Expression: 1
                                        * Referenced by: '<Root>/Reference Voltage (Percentage)'
                                        */
  0.0,                                 /* Expression: 0
                                        * Referenced by: '<Root>/Reference Voltage (Percentage)'
                                        */
  7.0,                                 /* Expression: 7
                                        * Referenced by: '<Root>/Reference Voltage (Percentage)'
                                        */
  0.0,                                 /* Expression: 0
                                        * Referenced by: '<Root>/Reference Voltage (Percentage)'
                                        */
  255.0,                               /* Expression: 255
                                        * Referenced by: '<Root>/Scale Value'
                                        */
  1.0,                                 /* Expression: 1
                                        * Referenced by: '<S4>/Constant1'
                                        */
  0.0,                                 /* Expression: 0
                                        * Referenced by: '<S4>/Constant2'
                                        */
  0.0,                                 /* Expression: 0
                                        * Referenced by: '<S4>/Switch'
                                        */
  255.0,                               /* Expression: 255
                                        * Referenced by: '<Root>/Reference Gain'
                                        */
  1.0                                  /* Expression: 1
                                        * Referenced by: '<S4>/Constant3'
                                        */
};

/*
 * File trailer for generated code.
 *
 * [EOF]
 */
