Logiant/AgileRoboticControls/System Modelling/Control/Simulink Code/Cylinder Tests/Hardware Test/untitled_rtt/untitled.c

/*
 * File: untitled.c
 *
 * Code generated for Simulink model 'untitled'.
 *
 * Model version                  : 1.0
 * Simulink Coder version         : 8.6 (R2014a) 27-Dec-2013
 * TLC version                    : 8.6 (Jan 30 2014)
 * C/C++ source code generated on : Thu Apr 23 20:43:13 2015
 *
 * Target selection: realtime.tlc
 * Embedded hardware selection: Atmel->AVR
 * Code generation objectives: Unspecified
 * Validation result: Not run
 */

#include "untitled.h"
#include "untitled_private.h"

/* Real-time model */
RT_MODEL_untitled_T untitled_M_;
RT_MODEL_untitled_T *const untitled_M = &untitled_M_;

/* Model output function */
void untitled_output(void)
{
  real_T tmp;
  uint8_T tmp_0;

  /* DataTypeConversion: '<S1>/Data Type Conversion' incorporates:
   *  Constant: '<Root>/Constant3'
   *  Gain: '<Root>/FeedbackVoltage'
   */
  tmp = untitled_P.FeedbackVoltage_Gain * untitled_P.Constant3_Value;
  if (tmp < 256.0) {
    if (tmp >= 0.0) {
      tmp_0 = (uint8_T)tmp;
    } else {
      tmp_0 = 0U;
    }
  } else {
    tmp_0 = MAX_uint8_T;
  }

  /* End of DataTypeConversion: '<S1>/Data Type Conversion' */

  /* S-Function (arduinoanalogoutput_sfcn): '<S1>/PWM' */
  MW_analogWrite(untitled_P.PWM_pinNumber, tmp_0);
}

/* Model update function */
void untitled_update(void)
{
  /* (no update code required) */
}

/* Model initialize function */
void untitled_initialize(void)
{
  /* Registration code */

  /* initialize error status */
  rtmSetErrorStatus(untitled_M, (NULL));

  /* Start for S-Function (arduinoanalogoutput_sfcn): '<S1>/PWM' */
  MW_pinModeOutput(untitled_P.PWM_pinNumber);
}

/* Model terminate function */
void untitled_terminate(void)
{
  /* (no terminate code required) */
}

/*
 * File trailer for generated code.
 *
 * [EOF]
 */
