Logiant/AgileRoboticControls/(commit log)

2014-11-13 Added existing documents into repo
    SVN sucks!
    [Agile Quadruped Robot - Gantt Chart.xlsx, Constraints List.xlsx, DebugBoard.SLDPRT, Design Matrix.xlsx, Link1.SLDPRT, Link1.STL, Link2.SLDPRT, Link2.STL]
2014-12-03 Updated to newest content
    [Microcontroller Decision Matrix.xlsx, TODO List Fall Quarter.xlsx, TODO List.xlsx]
2014-12-03 Updated TODO List
    [TODO List Fall Quarter.xlsx]
2014-12-04 updated matlab simulation to be fully kinematic for arbitrary gaits
    [Link1.SLDPRT, Link1.STL, Link2.SLDPRT, Link2.STL]
2014-12-05 Updated TODO List for this week
    [TODO List Fall Quarter.xlsx]
2014-12-11 Updated design document and sample circuit
    Changed document title
    Updated Pedagogical Research section
    Changed sample pneumatic circuit diagram
2014-12-11 Updated TODO list after meeting
    [TODO List Fall Quarter.xlsx]
2014-12-12 Updated TODO Lists
    [TODO List Fall.xlsx, TODO List Winter.xlsx]
2014-12-12 Design Proposal Draft Modifications - PID Loop Test added
    Design Proposal Draft Revision 4 changes made.
    PID loop test added. (Model used to test a basic untuned PID).
2014-12-19 Created powerpoint and updated todo list
    [TODO List Winter.xlsx]
2015-01-03 Small update
    [TODO List Winter.xlsx]
2015-01-07 PID Model and Weight List added
    PID Model was modified to have multliple control loops.
    Weight excel list was created to contain the weights for parts.
    [Weight List.xlsx]
2015-01-09 Xbee Device Order
    Xbee Devices ordered for the communications system.
    Order record added.
2015-01-09 Memo and TODO list update 1/8/2015
    Memo updated
    TODO list updated
    [TODO List Winter.xlsx]
2015-01-09 Memo and TODO list update 1/8/2015
    updated memo and todo list
    [TODO List Winter.xlsx]
2015-01-09 Memo and TODO list update
    Updated the memo, TODO list, and Weight List with the information I had.
    [TODO List Winter.xlsx, Weight List.xlsx]
2015-01-09 Added Slides to PowerPoint Presentation
    Added slides related to pneumatic design
2015-01-09 Powerpoint, TODO List, Memo4
    Powerpoint controls and software slides added
    TODO list (color updated)
    Memo 4 Goals removed since they have not been decided.
    [TODO List Winter.xlsx]
2015-01-09 Meeting updates
    Powerpoint and Excel sheet updated after meeting
    [TODO List Winter.xlsx]
2015-01-12 Pointpoint Update based on Rodriguez Feedback
    Electrical Slides updated based on Rodriguez feedback from last advisor
    meeting (2015/1/9)
    Powerpoint moved to Presentation folder in documentation folder
2015-01-12 PowerPoint Updated
    Updated PowerPoint
2015-01-12 PowerPoint Uploaded
    Mechanical portion updated
2015-01-13 Fixed PowerPoint
    PowerPoint Fixed
2015-01-13 Presentation - Powerpoint
    Design power point updated with electrical changes.
2015-01-13 Advisor Update to Powerpoint
    Dr. Rodriguez added to first slide
2015-01-13 TODO list updated for Advisor meeting
    TODO list updated 2015/1/13
    Memo 4 updated
    [TODO List Winter.xlsx]
2015-01-20 Compressor Spreadsheet added
    Compressor excel sheet created
    [Air Compressor Spread sheet.xlsx]
2015-01-30 Compressor Sheet updated
    Compressors and information added
    [Air Compressor Spread sheet.xlsx]
2015-02-06 Communication System Software Updated
    Comm. System Update
    Debug Panel components
    [Debug Panel Components.xlsx]
2015-02-09 Environmental Report Finalized
    Environment Report final pdf added
    Debug Panel Components updated
    [Debug Panel Components.xlsx]
2015-02-10 Updated software
    Yay software!
    [PressureBoreCalc.xlsx]
2015-02-11 ANSYS Project, Results, PMax Calculator
    Created initial ANSYS Workbench model with dynamic piston and static
    weight forces as well as summary document in Design\Mechanical Analysis
    Created initial Pressure/Bore Size calculator based on required leg
    torque.
    [PressureBoreCalc.xlsx]
2015-02-11 Updated pneumatic calculations
    Created excel sheet that calculates required air pressure based on
    piston and leg geometry, then calculates air supply lifetime based on
    constant usage and compressor specs.
    [PressureBoreCalc.xlsx]
2015-02-11 Changed values to be more realistic in pneumatic calculator
    Used matlab parameters and a generic 100 PSI air compressor to calculate
    values along with a generic pneumatic cylinder with approximate values.
    [PressureBoreCalc.xlsx]
2015-02-11 Converting gallon to ft3
    [PressureBoreCalc.xlsx]
2015-02-11 Updated constant values
    Pressure Calculator now uses longer leg sizes with impossibly small
    strokes and calculates air supply life based off of storage pressure.
    [PressureBoreCalc.xlsx]
2015-02-13 Upgraded MATLAB Assembly to BETA
    Also added SolidWorks parts for a potential leg assembly/ANSYS FEA
    modelling.
    [Leg Assembly.SLDASM, Mounting.SLDPRT, ParameterConfig.xlsx, Pin Joint.SLDPRT, Shank.SLDPRT, Side Wall.SLDPRT, Surface_Shank.SLDPRT, Surface_Thigh.SLDPRT]
2015-02-13 Updated all simulations with semi-realistic values
    Finalized initial SolidWorks leg model.
    Took leg properties and placed them in MATLAB dynamic simulation to
    determine required torques and forces.
    Took leg geometry and MATLAB output into ANSYS and performed a worst
    case failure analysis with immobile joints.
    [Force Calculations.xlsx, Leg Assembly.SLDASM, Mounting.SLDPRT, ParameterConfig.xlsx, Pin Joint.IGS, PressureBoreCalc.xlsx, Shank.IGS, Shank.SLDPRT]
2015-02-13 Weekly to do list update
    [Force Calculations.xlsx, PressureBoreCalc.xlsx]
2015-02-17 Solid Models
    Here are all the solid models I have
    [90_Degree_Bracket.SLDPRT, 90_Degree_Extended_Bracket.SLDPRT, 90_Degree_Plate.SLDPRT, Body_2_Angle.SLDPRT, Body_2_Back.SLDPRT, Body_2_Front.SLDPRT, Body_2_Side.SLDPRT, Body_2_Upright.SLDPRT]
2015-02-17 Added lines between joints to represent lengths
    ctrl+q to rebuild model
    [Leg Assembly.SLDASM, Mounting.SLDPRT]
2015-02-17 Full Body Model
    Body Model with all current components installed
    [Doge 4.0.SLDASM]
2015-02-18 Moved simulation into System Model folder
    Originally in Software folder, but that was not correct
    [Force Calculations.xlsx, Link1.SLDPRT, Link1.STL, Link2.SLDPRT, Link2.STL, ParameterConfig.xlsx, PressureBoreCalc.xlsx]
2015-02-18 Minor changes
    added newline to matlab script
    added thetas to force calculations
    [Force Calculations.xlsx]
2015-02-18 Led PID Model Updated and Executive Summary Added
    Executive SUmmary and supporting image added.
    Leg PIDs MR added
    Small Battery Indicator
    [Smaller Battery Level Indicator.ms13]
2015-02-19 Modeling Updates
    Updated Leg models after ANSYS analysis and included the MATLAB script
    to solve for point positions
    [Doge 4.0.SLDASM, Doge 4.0.x_t, Lower Leg 3.0.x_t, Upper Leg 4.0.SLDPRT, Upper Leg.x_t]
2015-02-19 Created state machine flowchart representation
    7 initial states:
    Initialize
    Idle
    Move forward/backward/left/right
    Shutdown
2015-02-19 Executive Summary
    Uploaded the Mechanical design part as well as some more model changes
    [Doge 4.0.SLDASM]
2015-02-19 Updated simulation and summary
    Simulation now uses actual 3D leg model while running
    Executive summary for dynamic simulation updated
    [ParameterConfig.xlsx, Shank.SLDPRT, Shank.STL, Thigh.SLDPRT, Thigh.STL]
2015-02-23 Updated dynamics summary and matlab files
    Dynamics summary is 10 pages and still needs references/sources
    Updated matlab files to calculate impulse foot forces
    Added a summary table to force calculations for report
    [Force Calculations.xlsx]
2015-02-23 Design Report Changes
    Fixed wording on Control Algorithms (We made Simulink models).
    Added Battery Level indicator design.
2015-02-23 Created controller block diagram
    Moved PID Model into System Modelling/Control
2015-02-23 Updated and moved pneumatic diagram
    Moved to SystemModelling\Mechanical\Pneumatics
    Began refactoring control algorithms section in new document
    [PressureBoreCalc.xlsx]
2015-02-23 Gantt Chart Updates
    Updated Gantt Chart Content
    [Agile Quadruped Robot - Gantt Chart.xlsx]
2015-02-23 Updated Gantt Chart
    [Agile Quadruped Robot - Gantt Chart.xlsx]
2015-02-23 First draft BOM added
    BOM added
    [BOM.xlsx]
2015-02-23 Added to Bill of Materials
    [BOM.xlsx]
2015-02-23 Final report changes
    Added bill of materials. PRINTING NOW
    [BOM.xlsx]
2015-02-23 Updated Design Report
    Updated Mechanical Design. Also including a BOM for mechanical and
    pneumatic components.
    [Bill of Materials.xlsx]
2015-02-26 Smaller Battery Level Indicator Update
    Zener diodes changes, model created.
    [Smaller Battery Level Indicator.ms13]
2015-02-26 Added Pneumatics Section to Presentation folder
2015-02-26 Added pneumatics and dynamics to presentation
2015-02-26 Datasheets and LPF design added
    Datasheets for amplifiers and Switched Capacitor Voltage Converter
    [LPF.ms13]
2015-02-26 Updated document and presentation
    Minor presentation updates to pneumatics and control
    Re-added controls section to design report
2015-02-26 Design Report Updated
    Datasheets for components added
    Design report updated with 9 volt battery detector and LPF design
    [LPF.ms13]
2015-02-26 Updated Pneumatic Slides in presentation
2015-02-27 Updated Presentation
    Updated Mechanical Design Portion with beautiful pictures. Also did one
    last touch up to the solid model.
    [Doge 4.0.SLDASM]
2015-02-27 Updated Presentation
    Fixed errors in pneumatics portion of presentation
2015-02-27 Updatedd leg animation and title page
2015-02-27 Updated Presentation
    Couple of corrections is all
2015-02-27 Updated Presentation
    Re-fixed pneumatic slides in presentation
2015-03-08 Updated Pneumatics in Design Report
    Added updates to the pneumatics section based on feedback
2015-03-08 Updated Bill of Materials
    New bill of materials doc. added to Bill of Materials folder
    [Bill Of Materials - Updated.xlsx]
2015-03-08 Updated Pneumatics Section in Design Report
    Updated pneumatics section in design report based on feedback
2015-03-08 Updated simulation and created sim results excel sheet
    [Sim Results.xlsx]
2015-03-11 Created TODO List for Spring week 1!
    [TODO List Spring.xlsx]
2015-03-12 Bill of Materials Update
    Updated Bill of materials
    [Bill Of Materials - Updated.xlsx]
2015-03-13 Meeting update
    [TODO List Spring.xlsx]
2015-03-15 Updated HMI software
    The UI is ugly but functional, the connect button runs a custom DLL
    which produces sound.
2015-04-27 Created JGI presentation and weight calc excel doc
    [Weight Calculations.xlsx]
2015-04-28 Joy Global Presentation Submission
    This presentation now includes my electrical points
    [Bill Of Materials - Updated.xlsx, LPF_Standard Caps.ms13]
2015-04-29 Added Chassis picture
    Added Chassis Picture
2015-04-29 Updated Bill of Materials
    [Bill Of Materials - Updated.xlsx]
2015-04-30 Compiled simulink models to arduino
2015-04-30 Updated slideshow
    Removed two -insert image here- slides
    Updated block diagram for overall control
2015-04-30 Fixed Pneumatic Circuit Diagram picture
    4-2 valve changed to 4-3 valve
2015-04-30 Slideshow Update
    Added Leg Picture
2015-04-30 Slideshow Update
    Added Leg Picture?
2015-04-30 Added pictures to Pneumatic design slide
2015-04-30 Changed background, added cad model of robot
2015-05-06 Dual Cylinder Test
2015-05-18 Added a basic pneumatic circuit picture
    It has color
2015-05-21 Circuit Diagrams Updated - Final Report Updates
    Electrical Section of the final report updated to include most up-to
    date electrical circuit designs.
    Circuit simulation models updated.
    Pictures of the circuits added.
    [9VoltBatteryLevelIndicator.ms13, Amplifier.ms13, LPF_Standard Caps.ms13, Smaller Battery Level Indicator.ms13]
2015-05-22 Added more simulink code
    [SingleCylinderTest.obj, SingleCylinderTest_data.obj, rtGetInf.obj, rtGetNaN.obj, rt_logging.obj, rt_main.obj, rt_nonfinite.obj]
